bogdan-kovalchuk/esp32-battery-charging-monitoring/hardware/battery-monitor-rev-a/production/README.md

# Battery monitor rev-a: production package

Board: ESP32-S3-WROOM-1 + Ra-02 battery voltage monitor, 4 layers, 62 x 50 mm, 1.6 mm, HASL (JLCPCB standard, no surcharge), 66 footprints (62 BOM references, of them 59 soldered parts in the position file + J101 wire pads + TP102/TP103 test pads, + 4 mounting holes H1–H4), all on the top side, hand assembly. Built 2026-10-15, reworked 2026-10-18, balanced 2026-10-20, revised in review round r6 (2026-10-22), silkscreen reworked in r7, top silk texts edited by the owner in r8, parts re-sourced to Ukrainian stock in the IMRAD-stock round (2026-10-25: F101 and R511 footprints changed, MPN fields), U201 thermal-pad holes 0.20 -> 0.30 mm in the JLCPCB-standard round (2026-10-26), re-exported 2026-10-26 with KiCad 10.0.6 `kicad-cli` from the installed board `battery-monitor-rev-a.kicad_pcb` SHA256 `cf1b4365...` (full hash in `../evidence/jlc-standard-20261026/report.md`; every file of this package except the purchase workbook: fabrication files, assembly drawings, renders, STEP, BOM, position file); DRC with schematic parity 0 errors / 0 unconnected / 0 parity, 7 accepted `lib_footprint_mismatch` warnings (J201, U201, U401, L101, TP102, TP103, R511: board silk edited against the library footprints; never run "Update footprints from library" on them).

## What to upload

`01-gerbers-for-order/battery-monitor-rev-a-gerbers.zip` to JLCPCB as a standard 4-layer board with the quote-page defaults (bare PCB + top stencil, no surcharge). The quote-page table, the expected charges, the design facts, drill counts and the answers to engineering questions are in `01-gerbers-for-order/README-FABRICATION.md`.

**No assembly service for Ukraine:** JLCPCB offers no PCB assembly for delivery to Ukraine and LCSC takes no orders from Ukraine. Order the bare PCB and the stencil only; the parts are bought in Ukraine / AliExpress and soldered by hand.

## What else is in the package

| Path | Content |
|---|---|
| `01-gerbers-for-order/gerbers/` | The ZIP content unpacked (10 Gerber layers, job file, PTH and NPTH Excellon) |
| `01-gerbers-for-order/drill/` | Drill maps (PDF) and drill report: PTH 99 (smallest 0.30 mm: 72 vias + 12 U201 thermal-pad holes), NPTH 6 (total vias: 76 = 72 x 0.6/0.3 + 4 x 0.8/0.4, plugged/tented both sides; the 5 GND vias in the U101 exposed pad are open on the top through the pad's mask opening) |
| `01-gerbers-for-order/netlist-ipc356/` | IPC-D-356 netlist for the fab's electrical test |
| `01-gerbers-for-order/alt-drill-G85/` | Fallback only: PTH drill file with the J201 slots as G85 oval holes and a ZIP that differs from the main ZIP only in that file (use only if the fab asks for G85 slots) |
| `02-components/battery-monitor-rev-a-bom.csv` | KiCad BOM (`kicad-cli sch export bom`, grouped by value + footprint + MPN): Reference, Value, Footprint, MPN, Manufacturer, Quantity, Population, Note; 40 groups, 62 references (59 soldered parts + J101 wire pads + TP102/TP103), 0 DNP |
| `02-components/battery-monitor-rev-a-components.xlsx` | Ukrainian purchase workbook (formulas): sheet `Плата` one line per BOM group (boards to build in `Інструкція`!C5, default 5; buy-at-least stock target, shop, price, link, status), `Список покупок` grouped by shop, `Кошики` per-shop totals, `Набори` the owner's 0603 E24 resistor book, `Поза платою` what to buy outside the board (voltmeter module, XH mating housings and contacts, nylon M3 mounting hardware, inline 2 A blade fuse and holder for the battery + lead), `Пропозиції` every offer and search link; IMRAD-stock round 2026-10-25: MPNs as the schematic fields, IMRAD for every line it stocks, VD MAIS for U101, U301, F501, L101, R305, U202, owner stock U201 / U401, the owner's 0603 book now the free reserve of the 9 resistor lines bought as IMRAD packs; all 120 links opened and stock and prices checked on 2026-10-25 (`../evidence/imrad-stock-20261025/scratch/imrad-workbook/live/`). Generated by the scripts in `../evidence/imrad-stock-20261025/scratch/imrad-workbook/gen/`, verified by `verify_components.py` (0 problems; 39 board lines, 9 outside lines; 9137.32 UAH for 5 boards without delivery: board parts 8328.76 UAH + outside the board 808.56 UAH); record `../evidence/imrad-stock-20261025/imrad-workbook-CHANGES.md` |
| `03-documentation/ASSEMBLY-NOTES.md` | Hand assembly: soldering order with a test per stage, U101 PowerPAD (5 GND vias in the exposed pad, open on the top inside the pad's mask opening, no paste on them; hot air), U301 VSSOP, WROOM MSL3 bake, BOOT/EN recovery without buttons, J101 battery leads (square pad = BAT +), inline 2 A fuse in the battery + lead, M3 nylon mounting hardware (H3 next to F101 pad 2), enclosure heights, voltmeter wiring at J503 and external wake button at J504 (pin 1 = square pad; silk legends `+ GND SNS` at J503 and `BTN` at J504), the 30 references only on the assembly drawing, the parts re-sourced on 2026-10-25 (F101 NANO2, R511 2512, J201 test-fit), firmware obligations, bring-up tests |
| `03-documentation/assembly-top.pdf` | Assembly drawing, top: page 1 F.Fab + F.SilkS + Edge.Cuts with all 66 references (board `cf1b4365`); page 2 overview map 1.5:1 and pages 3–6 quadrants Q1–Q4 at 3:1, all 62 BOM references labelled on their own parts (H1–H4 only on page 1) |
| `03-documentation/assembly-top.html` | Interactive assembly map (hover for reference, value, MPN) |
| `03-documentation/assembly-bottom.pdf` | Bottom view, mirrored: no parts (single-sided), legends only (`BAT +` / `BAT -`, board name, date line) |
| `03-documentation/battery-monitor-rev-a-pos-kicad.csv` | Position file, top side, mm (`kicad-cli pcb export pos`, 59 soldered parts) |
| `03-documentation/battery-monitor-rev-a-schematic.pdf` | Schematic, root + 5 sheets (`kicad-cli sch export pdf`; sheet title blocks empty, owner GUI step) |
| `03-documentation/render-top.png`, `render-bottom.png`, `battery-monitor-rev-a.step` | 3D renders and STEP (re-exported 2026-10-26 from board `cf1b4365`; STEP with `--no-optimize-step`; F101 NANO2 model from EasyEDA/LCSC C99547, KiCad 10.0.6 has none for `Fuse_Littelfuse-NANO2-451_453`; record `../evidence/imrad-stock-20261025/imrad-3d-gerber-CHANGES.md`) |
| `manifest.sha256` | SHA256 of every file in this folder |

Do not rename or edit the Gerber files; after any CAD change regenerate the whole package.

**Re-export of the assembly drawing:** the map pages 2–6 come from `assembly_map_62.py` with the collision-aware label placement of r7-map-fix, which imports `labelplace.py`. Copy both files together from `../evidence/silk-r7-20261023/scratch/r7-map-fix/scripts/` into the export `scripts/` folder before running `doc_export.sh` (the call itself is unchanged); the `assembly_map_62.py` in `../evidence/silk-r7-20261023/scratch/r7-reexport/scripts/` and in the r6 scratch is the older version that runs labels together in the 0603 rows.

**Footprint library:** Never run "Update footprints from library" (or "Change footprints" / any library re-sync) on U201, J201, U401, L101, TP102, TP103 or R511: their board silk was edited against the library footprints (r7; R511 in the IMRAD-stock round 2026-10-25: the library silk line on the `BAT -` side split around the legend, the 7th accepted warning, `../evidence/imrad-stock-20261025/imrad-install-CHANGES.md`) (accepted DRC warnings `lib_footprint_mismatch`), and a library update restores the old silk with its silk-edge and silk-to-pad defects (L101 0.04 mm, TP rings 0.14 mm, U401 at C402 0.095 mm, the R511 line across `BAT -`). A library fix (project-local copies of these seven footprints with the edited silk) is a rev-b item.

**Inline battery-lead fuse (owner wiring, required):** a 2 A MINI/ATO blade fuse (32 V DC rated) in an inline holder in the battery + lead within 0.2 m of the + clip. F101 on the board (Littelfuse NANO2 0451002.MRL since 2026-10-25) interrupts up to 50 A at 125 V AC/DC and 300 A at 32 V DC (Littelfuse 451/453 datasheet, interrupting ratings) and stays secondary protection; a 12/24 V battery can deliver more into a shorted input part or a shorted lead. 48 V part swap: fuse rated >= 80 V DC. Text in `03-documentation/ASSEMBLY-NOTES.md` section 3; purchase lines П8/П9 on the workbook sheet `Поза платою`.

**Bottom silk date:** the bottom silkscreen reads `battery-monitor rev A` and `2026-10-23  4L` (date of the r7 silk rework; the top carries `rev A`). Later changes (the same day the F.Fab-only board `22731ea4` and the owner's top-silk edit r8, board `f26090a2`; on 2026-10-25 the IMRAD-stock round, board `98f3c7e2`) are identified by this package and the board hash, not by the bottom silk.

## Revision history

| Date | Round | Board | What changed in the package | Record |
|---|---|---|---|---|
| 2026-10-20 | Feng-Shui rework 62 x 50 mm | `1e59116f` | complete package | `../evidence/fengshui-20261020/` |
| 2026-10-22 | review r6 | `81057c2e` | vias out of SMD pads, C402 at U401, silk 1.0/0.15 mm, docs; schematic not edited (errata below) | `../evidence/review-r6-20261022/` |
| 2026-10-23 | silk rework r7, owner silk edit r8 | `22731ea4`, `f26090a2` | only F/B silkscreen and assembly drawing | `../evidence/silk-r7-20261023/`, `../evidence/owner-silk-r8-20261023/` |
| 2026-10-25 | IMRAD-stock round, F101 3D model, purchase for 3 boards, pre-fab review | `98f3c7e2`, `0eb3bae2` | F101 NANO2 and R511 2512 footprints, one GND via, MPN fields, workbook, `alt-drill-G85/` | `../evidence/imrad-stock-20261025/` |
| 2026-10-26 | JLCPCB-standard round | `cf1b4365` | U201 thermal holes 0.20 -> 0.30 mm (PTH drill, report, maps, IPC, STEP, ZIP); README-FABRICATION = JLCPCB quote-page defaults (HASL); live quote PCB $8.00 | `../evidence/jlc-standard-20261026/report.md` |

Every exported file is rebuilt from the board of the last row with the commands recorded in that round (method proven
on the previous board each time). Full paragraphs of each round: `../evidence/production-history.md`.

## Schematic errata

The installed schematic sheets were deliberately not edited in r6 (owner 2026-10-22: no schematic change without a real defect; the texts below change no connection). They are stale in the schematic PDF and, for the Note fields, in the BOM CSV `Note` column. Read them as corrected here. Step 1 of the IMRAD-stock round (2026-10-25) changed symbol fields only: it replaced the F101 and L101 Note fields, so their r6 errata rows are closed (new F101 Note checked against the Littelfuse 451/453 datasheet: interrupting ratings, 2 A cold resistance 0.0367 ohm, melting I2t 0.530 A2s); sheet texts and the F501 Note were not touched, and one refreshed field needs reading as corrected (U301 UA_Source).

| Where | Printed text (stale) | Read as |
|---|---|---|
| `05-io` sheet header | "05-IO: user button, status and alert LEDs, I2C header, spare header, LED voltmeter output." | "05-IO: external wake button (J504), status and alert LEDs, I2C pull-ups, LED voltmeter output (J503)." (J501/J502 headers removed 2026-10-18) |
| `02-mcu-usb` sheet header | "02-MCU-USB: ESP32-S3-WROOM-1-N16R8, EN/RESET, BOOT, USB-C data, UART0. Inherited from ..." | "02-MCU-USB: ESP32-S3-WROOM-1-N16R8, EN/RESET (TPS3808), BOOT strap, USB-C data (native USB). Inherited from antenna-controller-rev-c 02-mcu-usb (owner-approved); UART0 header removed 2026-10-18." |
| `05-io` voltmeter text, F501 | "F501 opens in <= 0.2 s (>= 300 %) or 0.04-0.3 ms (adiabatic)" | "F501 opens in <= 0.2 s (>= 300 %) or about 0.08-0.5 ms (adiabatic, melting I2t 0.0022 A2s, Littelfuse 466 Rev. 12/17/18)" |
| `01-power` chain text, 48 V sentence | "Documented alternate for 48 V only (not built): SMAJ58A/SMAJ64A, a 125 V fuse, 100 V switch MOSFETs" | "Documented alternate for 48 V only (not built): SMAJ58A/SMAJ64A (full-surge clamp above the U101 85 V abs max: accepted surge assumption), a fuse rated >= 80 V (F101 0451002.MRL, 125 V, meets this since 2026-10-25), 100 V switch MOSFET, R512 >= 0.5 W (2010/2512) or 22k, C102 effective capacitance re-checked at 60 V; the 4-30 V voltmeter module cannot be used (firmware lockout F6)." |
| L101 Note field (BOM CSV, step-1 text) | "... Isat 1.9 A (L -30 %), above the LMR38010 1.6 A typ limit ..." | "... Isat 1.9 A (L -30 %): above the LMR38010 high-side current limit 1.6 A typ and equal to its 1.9 A max (SNVSC73B 7.5, as quoted in `../evidence/review-r6-20261022/verify-circuit.md`) ..."; the r6 row for the former part's Note is closed |
| F501 Note field (BOM CSV) | "gauge fault fuse (review R2-01): cold 0.710 ohm, melting I2t 0.0010 A2s, 300 % <= 0.2 s, 200 % <= 5 s (Littelfuse 466 Rev. 12/19/13); ..." | "gauge fault fuse (review R2-01): cold 0.691 ohm, melting I2t 0.0022 A2s, 200 % <= 5 s (Littelfuse 466 Rev. 12/17/18); coordination table in schematic-review.md." |
| U301 UA_Source field (hidden schematic field; not in the PDF or the BOM CSV; refreshed in step 1) | "VD MAIS own stock 4 pcs; Digi-Key via VD MAIS 34304 pcs, 3 weeks, 374.63 UAH; IMRAD on order 6-10 working days (2026-10-25)" | "... Digi-Key via VD MAIS 34304 pcs, 3 weeks, 374.63 UAH ex VAT (449.56 UAH with VAT) ..." (the workbook line uses 449.56; `../evidence/imrad-stock-20261025/imrad-workbook-CHANGES.md`; schematic not edited) |

None of these changes a part, a value or a connection; F501 selection is unaffected (`../evidence/review-r6-20261022/verify-circuit.md` S-01, S-02, S-04); the F101 and L101 selections of 2026-10-25 are recorded in `../evidence/imrad-stock-20261025/report.md`.
