bogdan-kovalchuk/esp32-battery-charging-monitoring/hardware/battery-monitor-rev-a/production/03-documentation/render-bottom.png

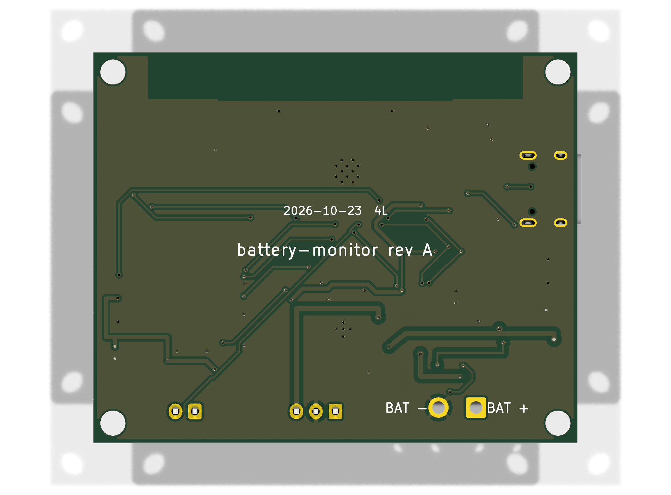
hardware/battery-monitor-rev-a/production/03-documentation/render-bottom.png
