bogdan-kovalchuk/esp32-battery-charging-monitoring/hardware/battery-monitor-rev-a/production/02-components/battery-monitor-rev-a-bom.csv

Reference | Value | Footprint | MPN | Manufacturer | Quantity | Population | Note
C101 | 22uF 100V | Capacitor_SMD:CP_Elec_8x10 | EEE-FK2A220P | Panasonic | 1 |  | damping of hot-plug ringing on battery leads (PWR-020); aluminium SMD 8x10
C102 | 10uF 100V | Capacitor_SMD:C_1210_3225Metric | GRM32EC72A106KE05L | Murata | 1 |  | 10 uF 100 V X7S 1210; 4.32 uF effective at 31 V (Murata curve, c102-choice.md); TI 4.7 uF effective minimum met up to 28.4 V, C101 in parallel
C103 | 100nF 100V | Capacitor_SMD:C_0603_1608Metric | CL10B104KC8NNNC | Samsung | 1 |  | X7R 100 V, next to U101 VIN/GND
C104,C202-C205,C301,C302,C402 | 100nF | Capacitor_SMD:C_0603_1608Metric | CL10B104KB8NNNC | Samsung | 8 |  | RC with 9.57k source: tau 0.96 ms, 16-bit settling 11 tau = 11 ms,U301 VDD decoupling,bootstrap, >= 16 V
C105-C107,C201 | 22uF | Capacitor_SMD:C_0805_2012Metric | GRM21BR61E226ME44L | Murata | 4
C401 | 10uF | Capacitor_SMD:C_0805_2012Metric | CL21A106KAYNNNE | Samsung | 1
D101 | B1100 | Diode_SMD:D_SMA | B1100-13-F | Diodes Incorporated | 1 |  | reverse-polarity block, 100 V 1 A SMA; VF 0.79 V max at 1 A (Diodes DS30018); was MCC SS110-LTP (2026-10-25 IMRAD-stock change); do not substitute a 60 V SS1x family part
D102 | SMAJ33A | Diode_SMD:D_SMA | SMAJ33A-TR | STMicroelectronics | 1 |  | owner Q1: 24 V systems -> SMAJ33A (VWM 33 V, VC 53.3 V at 7.5 A < 85 V U101); documented 48 V alternate only: SMAJ58A/SMAJ64A; pad 1 = cathode band to VIN_PROT
D501 | GREEN | LED_SMD:LED_0603_1608Metric | LTST-C191KGKT | Lite-On | 1 |  | STATUS (GPIO40): Wi-Fi/report state; yellow-green 571 nm, VF 2.0 V typ / 2.4 V max at 20 mA (Lite-On LTST-C191KGKT, 2026-10-25, was Foryard FYLS-0603GD): about 1.3 mA from GPIO40 via R502 1k; 3 V emerald-green LEDs stay dim or dark
D502 | RED | LED_SMD:LED_0603_1608Metric | KP-1608SURCK | Kingbright | 1 |  | ALERT (GPIO41): battery critical; 630 nm, VF 1.95 V typ / 2.5 V max (Kingbright KP-1608SURCK, 2026-10-25, was Hubei KENTO KT-0603R)
F101 | 2A 125V | Fuse:Fuse_Littelfuse-NANO2-451_453 | 0451002.MRL | Littelfuse | 1 |  | 2 A 125 V very fast NANO2 451 (IMRAD-stock change 2026-10-25, was 0466002.NRHF 1206): interrupting 50 A at 125 V AC/DC, 300 A at 32 V DC; cold 0.0367 ohm; melting I2t 0.530 A2s, hot-plug inrush about 0.04 A2s = 7.5 %; still clears a shorted D102
F501 | 0.25A 125V | Fuse:Fuse_1206_3216Metric | 0466.250NRHF | Littelfuse | 1 |  | gauge fault fuse (review R2-01): cold 0.710 ohm, melting I2t 0.0010 A2s, 300 % <= 0.2 s, 200 % <= 5 s (Littelfuse 466 Rev. 12/19/13); coordination table in schematic-review.md
J101 | BAT | Connector_Wire:SolderWire-0.75sqmm_1x02_P4.8mm_D1.25mm_OD2.3mm |  |  | 1 |  | solder pads for the XT30 lead; + = pin 1
J201 | USB4105-GF-A | Connector_USB:USB_C_Receptacle_HRO_TYPE-C-31-M-12 | USB4105-GF-A | GCT | 1 |  | data and programming only; VBUS does not power the board; GCT USB4105-GF-A on the HRO TYPE-C-31-M-12 land (2026-10-25, HRO not stocked in Ukraine): signal pads identical, VBUS/GND 0.05 mm shift, shell legs 0.80/1.10 mm in the 1.2/1.7 mm slots; test-fit on a bare board before soldering
J503 | VOLTMETER | Connector_JST:JST_XH_B3B-XH-A_1x03_P2.50mm_Vertical | B3B-XH-A(LF)(SN) | JST | 1 |  | 0.28 in LED voltmeter 0-100 V: 1 V_GAUGE (module supply, 4-30 V), 2 GND, 3 SENSE via R512 10k from VBAT_FUSED; 2-wire module: pins 1-2, pin 3 unused
J504 | BTN_EXT | Connector_JST:JST_XH_B2B-XH-A_1x02_P2.50mm_Vertical | B2B-XH-A(LF)(SN) | JST | 1 | Populated | External wake button (active high): 1 BTN_PULL (+3V3 via R510 1k), 2 BTN_USER (GPIO5, R501 10k pull-down to GND)
L101 | 22uH | Inductor_SMD:L_Bourns_SRN6045TA | SRN6045-220M | Bourns | 1 |  | 22 uH, ripple 0.34-0.36 A at 32-62 V in; SRN6045-220M (2026-10-25, was SRN6045TA-220M Isat 2.5 A): DCR 0.142 ohm max, Irms 1.5 A, Isat 1.9 A (L -30 %), above the LMR38010 1.6 A typ limit; same footprint; Sumida CDRH6D38NP-220NC (IMRAD) rejected: 1.3 A rated
Q501 | SI2309CDS | Package_TO_SOT_SMD:SOT-23 | SI2309CDS-T1-GE3 | Vishay Siliconix | 1 |  | gauge high-side switch (W23: single P-MOS): source on VIN_PROT (after D101, reverse-safe), drain to GAUGE_SW; -60 V, VGS(th) -1..-3 V; pulsed ID -8 A (10 us)
Q503 | MMBT5551 | Package_TO_SOT_SMD:SOT-23 | MMBT5551LT1G | onsemi | 1 |  | 160 V NPN current sink for the gauge switch gate
R101 | 68k | Resistor_SMD:R_0603_1608Metric | RC0603FR-0768KL | Yageo | 1 |  | RT: fSW = (30970/68)^(1/1.027) = 388 kHz (SNVSC73B eq. 2); full regulation to 65 V at tON-MIN 131 ns
R102 | 510k | Resistor_SMD:R_0603_1608Metric | 0603SAF5103T5E | Royal Ohm | 1 |  | RFBT; Vout = 1.0 V x (1 + 510/220) = 3.318 V; +3V3 band 3.22-3.45 V (typ 3.32 V; LMR38010 PFM regulation and 1 % resistors)
R103 | 220k | Resistor_SMD:R_0603_1608Metric | RC0603FR-07220KL | Yageo | 1 |  | RFBB; divider current 4.5 uA
R201,R202,R401,R501,R507 | 10k | Resistor_SMD:R_0603_1608Metric | 0603SAF1002T5E | Royal Ohm | 5 |  | emitter: Ic = 70-105 uA,pull-down replaces the DevKit external pull-down on GPIO34; GPIO5 has no pull at reset
R205,R206 | 5.1k | Resistor_SMD:R_0603_1608Metric | RC0603FR-075K1L | Yageo | 2
R208,R209 | 22 | Resistor_SMD:R_0603_1608Metric | RC0603FR-0722RL | Yageo | 2
R304 | 220k 0.1% | Resistor_SMD:R_0805_2012Metric | ERA-6AEB224V | Panasonic | 1 |  | thin film 0.1 % 25 ppm/K, 150 V; divider ratio 23.0 (0-69 V -> 0-3.0 V); always on from VBAT_FUSED (W23), 0.1 mA at 24 V
R305 | 10k 0.1% | Resistor_SMD:R_0603_1608Metric | RT0603BRD0710KL | Yageo | 1 |  | thin film 0.1 % 25 ppm/K
R307,R502,R503,R510 | 1k | Resistor_SMD:R_0603_1608Metric | RC0603FR-071KL | Yageo | 4 |  | AIN0 series: limits clamp current on reversal/overvoltage; source 10.6k: load error 0.18-0.39 % (typical ADS1115 input impedance), removed by the one-point calibration,button supply: pressed level 3.0 V (10k/11k), limits current to 3.3 mA when GPIO5 is driven low (power-up glitch)
R504,R505 | 4.7k | Resistor_SMD:R_0603_1608Metric | 0603SAF4701T5E | Royal Ohm | 2 |  | I2C SCL pull-up,I2C SDA pull-up
R506,R508,R509 | 100k | Resistor_SMD:R_0603_1608Metric | AC0603FR-07100KL | Yageo | 3 |  | base pull-down: gauge off while GPIO38 floats at reset/boot,base resistor GPIO38 -> Q503, 1:2 divider with R508,gate to source (VIN_PROT): VGS = 100k x 70-105 uA = 7-10.5 V, limited to VIN_PROT at a low battery
R511 | 4.7 2512 1W | Resistor_SMD:R_2512_6332Metric | RC2512JK-074R7L | Yageo | 1 |  | gauge short-circuit limiter (review R2-01): 2512 1 W thick film (2026-10-25 IMRAD-stock change, was Panasonic ERJ-P08J4R7V 1206 anti-surge 2.64 W / 5 s): short-time overload 2.5 x rated voltage for 5 s (Yageo RC2512, IEC 60115-1 4.13) = 5.42 V, 6.25 W, 31 J; partial-short case 1.8 W for <= 5 s = 8.9 J; dead short <= 0.78 J; ROHM ESR18 rejected: overload test 2.5 x Vr for 2 s only
R512 | 10k | Resistor_SMD:R_1206_3216Metric | 1206S4F1002T5E | Royal Ohm | 1 |  | voltmeter SENSE (J503 pin 3) from VBAT_FUSED: module reads the battery without the D101 drop; limits a sense-lead short to 3.1 mA (96 mW at 31 V; 1206 0.25 W)
TP102 | +3V3 | TestPoint:TestPoint_Pad_D1.5mm |  |  | 1
TP103 | GND | TestPoint:TestPoint_Pad_D1.5mm |  |  | 1
U101 | LMR38010SDDAR | Package_SO:TI_SO-PowerPAD-8 | LMR38010SDDAR | Texas Instruments | 1 |  | PFM + spread spectrum variant: Iq 40 uA, shutdown 3 uA; 4.2-80 V in (85 V abs max), 1 A; do not substitute FDDAR/FSDDAR (forced PWM); DDA0008B = KiCad TI_SO-PowerPAD-8
U201 | ESP32-S3-WROOM-1-N16R8 | RF_Module:ESP32-S3-WROOM-1 | ESP32-S3-WROOM-1-N16R8 (or -N16 / -N8, same footprint) | Espressif | 1 |  | owner stock N16R8; PSRAM not initialised by the firmware; N16R8 ambient -40..+65 C (indoor/garage OK)
U202 | TPS3808G33DBVR | Package_TO_SOT_SMD:SOT-23-6 | TPS3808G33DBVR | Texas Instruments | 1
U203 | USBLC6-2SC6 | Package_TO_SOT_SMD:SOT-23-6 | USBLC6-2SC6 | STMicroelectronics | 1
U301 | ADS1115IDGSR | Package_SO:TSSOP-10_3x3mm_P0.5mm | ADS1115IDGSR | Texas Instruments | 1 |  | 16 bit, I2C 0x48 (ADDR = GND); AIN0 battery, AIN1-AIN3 unused (no-connect, allowed by SBAS444E 9.1.4); ALERT/RDY no-connect (open drain, firmware polls; W23)
U401 | Ra-02 | BattMon:Ra02_Source | Ra-02 | Ai-Thinker | 1 | fitted (owner Q3) | 433 MHz variant (410-525 MHz), IPEX antenna; owner stock
