bogdan-kovalchuk/esp32-battery-charging-monitoring/hardware/battery-monitor-rev-a/production/02-components/battery-monitor-rev-a-components.xlsx

Sheet: Інструкція
Battery monitor rev-a: деталі для монтажу і закупівля із запасом
Деталі, що паяються на плату battery-monitor-rev-a (59 шт на плату з 62 позицій BOM; J101, TP102, TP103 - площадки без деталі). ESP32-S3 і Ra-02 вже є у власника; основний магазин - IMRAD, решта (U101, U301, F501, L101, R305, U202) - VD MAIS; резистори 0603 ряду E24 можна брати і з книги власника. Аркуш «Поза платою» - що купити для монтажу в корпус (вольтметр, відповідні роз'єми, кріплення, запобіжник у проводі батареї). Ціни, наявність і мінімальні замовлення - як на сторінках магазинів 2026-10-25; перед замовленням перевірити.
Налаштування (жовті клітинки можна змінювати)
Кількість плат для збирання | 5 |  | PCB замовляються по 5 шт. Кількості «Потрібно» і запас на брак рахуються від цього числа.
ПДВ для цін, вказаних «без ПДВ» | 20% |  | Космодром і РКС показують ціни без ПДВ; VD MAIS - з ПДВ; Prom.ua, IMRAD, Mini-Tech - як на сторінці.
Категорія | Запас на брак, % | Мін. запас на брак, шт | Навіщо
Дрібні пасивні | 20% | 3 | 0603/0805/1206 губляться і «відлітають» під час паяння
Мікросхеми та силові | 0% | 1 | 1 шт на випадок перегріву або неправильної орієнтації
Роз'єми та кнопки | 0% | 1 | 1 шт на випадок пошкодження
Модулі | 0% | 0 | ESP32-S3 і Ra-02 вже є у власника
Без деталі | 0% | 0 | площадки на платі, нічого не купується
Підсумок (рахується автоматично)
Деталі плати (із запасом): сума відомих цін, грн | 8328.764
Набори (книги): сума, грн | 0
Поза платою (вольтметр, роз'єми-відповідники, кріплення, запобіжник у проводі): сума, грн | 808.56
Разом, грн (без доставки і рядків без ціни) | 9137.324
Рядків без ціни (AliExpress) | 0
Рядків до покупки «в наявності» | 33
Рядків до покупки «під замовлення» (строк уточнити) | 2
Рядків до покупки «немає» / «немає в Україні» | 0
Номіналів з книги резисторів, яким її не вистачає | 0
Як користуватися: 5 кроків
КРОК 1. Тут, у жовтій клітинці C5, - скільки плат збираєте (зараз 5). Усі кількості перерахуються самі.
КРОК 2. Аркуш «Набори»: книга резисторів 0603 вже є («Вже є» = 1); резистори 0603 зараз купуються в IMRAD, книга - безкоштовна альтернатива. «Купити» = 1, лише якщо потрібна ще одна.
КРОК 3. Аркуш «Плата»: змінюйте лише жовті клітинки - «Купити щонайменше», «Вже є» (залишки після rev-c: стовпець «Деталь з rev-c»), «Джерело» і «Магазин». Зелений стовпець «ЗАМОВИТИ» - результат.
КРОК 4. Аркуш «Поза платою»: вольтметр, корпуси і контакти XH, нейлонове кріплення H1-H4, тримач і запобіжник 2 А для проводу батареї. «Вже є» - якщо щось уже є.
КРОК 5. Аркуш «Список покупок»: готовий перелік по магазинах. Аркуш «Кошики» - сума по кожному магазину і скільки бракує до мінімальної суми продавця Prom.ua (Filur 300, Connectors 150, DIY mag 100 грн).
Корисно знати
«ЗАМОВИТИ» = більше з двох: («Потрібно на всі плати» + «на брак») або «Купити щонайменше»; мінус «Вже є»; далі округлюється до мінімального замовлення і кратності магазину. «Лишиться в запасі» – що залишиться після збирання.
«Купити щонайменше» зараз: дешеві мікросхеми, запобіжники, дросель, діоди, транзистори, роз'єми – 10 шт; світлодіоди, 220k 0.1 % - 20; 100 нФ 0603 і 10 кОм 1206 - 100; 22 мкФ 0805 - 50. Дорогі U101, U202, U301 - лише потреба + 1 шт на брак.
«Джерело»: «магазин» - купується окремо (резистори 0603 68k, 510k, 220k, 10k, 5.1k, 22, 4.7k, 1k, 100k - упаковками по 100 шт в IMRAD; замість цього можна вибрати «книга резисторів 0603»); «є у власника» - ESP32-S3 і Ra-02 (сірі рядки); «не купується» - J101 (провід батареї), TP102/TP103.
НЕ замінювати: R304/R305 (0.1 %, тонкоплівкові), R511 (2512 1 Вт, перевантаження 5 с) і F501 0.25 А (розраховані разом), F101 лише NANO2 0451002.MRL (футпринт NANO2), U101 лише SDDAR / SQDDARQ1 (не FDDAR), D102 лише однонаправлений SMAJ33A. Допустимі заміни описано в стовпці «Що купувати».
Два замовлення (перевірено 2026-10-25): IMRAD - усі рядки, які він має на складі; VD MAIS - L101 SRN6045-220M, R305, U202 (власний склад, 0 тижнів) і Digi-Key через VD MAIS, 3 тижні: U101 LMR38010SQDDARQ1, F501 0466.250NRHF, 2 з 6 шт U301 - цей кошик замовляйте першим.
U301 ADS1115: на власному складі VD MAIS лише 4 шт з потрібних 6; решту 2 шт - Digi-Key у тому ж кошику VD MAIS. Ціна в рядку - середня за 6 шт; для іншої кількості перерахуйте (резерв: IMRAD під замовлення 6-10 робочих днів).
Дорожче, ніж у Космодромі (власний склад, резерв у рядку): Q501 (57.12 проти 9.00 грн без ПДВ) і F101 (49.95 проти 8.00): за бажанням змініть «Магазин» і ціну.
J504: лише B2B-XH-A(LF)(SN) без бобишки (IMRAD). B2B-XH-AM (з бобишкою) у плату не стає без підрізання бобишки.
LCSC/JLCPCB не продають в Україну; Digi-Key - через VD MAIS (catalog.vdmais.ua). AliExpress - лише пошукові посилання.
Ціни - як на сторінках на 2026-10-25; «без ПДВ» множиться на (1 + ПДВ). Доставку не враховано. Перед замовленням перевірте наявність. Усі перевірені пропозиції - аркуш «Пропозиції».
Джерела: KiCad BOM (02-components/battery-monitor-rev-a-bom.csv, kicad-cli 10.0.6), сторінки магазинів. Скрипти: battery-monitor-rev-a/evidence/imrad-stock-20261025/scratch/imrad-workbook/gen/ (edit_offers.py -> bom_offers.py, check_links.py, make_components_ua.py, verify_components.py, recalc_excel.ps1); дані - сторінки магазинів 2026-10-25 (скрипти component-sourcing-ukraine, вивід у imrad-workbook/live/).

Sheet: Список покупок
Список покупок: що і скільки замовити в кожному магазині. Рахується сам з аркушів «Плата» і «Набори»: тут нічого не змінюйте.
Купуйте магазин за магазином (рядки згруповано). Порожня ціна - AliExpress: шукайте за MPN зі стовпця «Що замовити». Перед оплатою відкрийте посилання і перевірте наявність і ціну.
Деталі плати
Магазин | Позиції на платі | Що замовити | Кількість | Од. | Ціна з ПДВ, грн/од. | Сума, грн | Статус | Посилання | Примітка
IMRAD | C101 | Panasonic EEEFK2A220P (точний MPN) | 10 | шт | 14.82 | 148.20 | в наявності | відкрити | IMRAD: «Є в наявності, на складі» (кількість не показано); ціна від 6 шт (1 шт: 16.13, від 15: 13.69, від 70: 12.38)
IMRAD | C102 | Murata GRM32EC72A106KE05L (точний MPN) | 10 | шт | 32.06 | 320.60 | в наявності | відкрити | IMRAD: «Є в наявності, на складі» (кількість не показано); ціна від 5 шт (1 шт: 36.53)
IMRAD | C103 | Samsung CL10B104KC8NNNC (100 нФ X7R 100 В 0603, точний MPN) | 100 | шт | 0.94 | 94.00 | в наявності | відкрити | IMRAD: «Є в наявності, на складі» (кількість не показано); ціна від 100 шт (1 шт: 1.65, від 10: 1.02)
IMRAD | C104, C202-C205, C301, C302, C402 | Samsung CL10B104KB8NNNC (100 нФ X7R 50 В 0603, точний MPN) | 100 | шт | 0.67 | 67.00 | в наявності | відкрити | IMRAD: «Є в наявності, на складі» (кількість не показано); ціна від 100 шт (1 шт: 1.65, від 10: 0.72, від 500: 0.63)
IMRAD | C105-C107, C201 | Murata GRM21BR61E226ME44L (точний MPN) | 50 | шт | 12.04 | 602.00 | в наявності | відкрити | IMRAD: «Є в наявності, на складі» (кількість не показано); ціна від 10 шт (1 шт: 13.42, від 100: 11.21). «Купити щонайменше» 50 задано, коли ціна була 2.96 грн: потреба 5 плат = 24 шт
IMRAD | C401 | Samsung CL21A106KAYNNNE (точний MPN) | 20 | шт | 3.41 | 68.20 | в наявності | відкрити | IMRAD: «Є в наявності, на складі» (кількість не показано); ціна від 10 шт (1 шт: 3.80, від 100: 3.18)
IMRAD | D101 | Diodes B1100-13-F (100 В, 1 А, SMA, точний MPN) | 10 | шт | 5.55 | 55.50 | в наявності | відкрити | IMRAD: «Є в наявності, на складі» (кількість не показано); ціна від 10 шт (1 шт: 6.07, від 50: 5.21)
IMRAD | D102 | ST SMAJ33A-TR (однонаправлений, 33 В, 400 Вт, SMA, точний MPN) | 10 | шт | 6.26 | 62.60 | в наявності | відкрити | IMRAD: «Є в наявності, на складі» (кількість не показано); ціна від 10 шт (1 шт: 6.85, від 50: 5.87)
IMRAD | D501 | Lite-On LTST-C191KGKT (жовто-зелений 571 нм, точний MPN) | 20 | шт | 1.74 | 34.80 | в наявності | відкрити | IMRAD: «Є в наявності, на складі» (кількість не показано); ціна від 10 шт (1 шт: 1.84, від 50: 1.56)
IMRAD | D502 | Kingbright KP-1608SURCK (червоний 630 нм, точний MPN) | 20 | шт | 4.69 | 93.80 | в наявності | відкрити | IMRAD: «Є в наявності, на складі» (кількість не показано); ціна від 10 шт (1 шт: 4.96, від 50: 4.21)
IMRAD | F101 | Littelfuse 0451002.MRL (NANO2, 2 А 125 В, точний MPN) | 10 | шт | 49.95 | 499.50 | в наявності | відкрити | IMRAD: «Є в наявності, на складі» (кількість не показано); ціна від 8 шт (1 шт: 57.93, від 4: 55.03, від 24: 45.86)
IMRAD | J201 | GCT USB4105-GF-A (точний MPN) | 10 | шт | 34.96 | 349.60 | в наявності | відкрити | IMRAD: «Є в наявності, на складі» (кількість не показано); ціна від 8 шт (1 шт: 37.65, від 4: 36.30, від 20: 33.62)
IMRAD | J503 | JST B3B-XH-A (точний MPN) | 10 | шт | 4.35 | 43.50 | в наявності | відкрити | IMRAD: «Є в наявності, на складі» (кількість не показано); ціна від 10 шт (1 шт: 4.82, від 35: 4.20)
IMRAD | J504 | JST B2B-XH-A (LF)(SN) (точний MPN) | 10 | шт | 3.20 | 32.00 | в наявності | відкрити | IMRAD: «Є в наявності, на складі» (кількість не показано); ціна від 10 шт (1 шт: 3.72, від 50: 3.05). НЕ B2B-XH-AM (з бобишкою)
IMRAD | Q501 | Vishay SI2309CDS-T1-GE3 (точний MPN) | 10 | шт | 57.12 | 571.20 | в наявності | відкрити | IMRAD: «Є в наявності, на складі» (кількість не показано); одна ціна для будь-якої кількості
IMRAD | Q503 | onsemi MMBT5551LT1G (точний MPN) | 10 | шт | 1.62 | 16.20 | в наявності | відкрити | IMRAD: «Є в наявності, на складі» (кількість не показано); ціна від 10 шт (1 шт: 1.72, від 50: 1.54)
IMRAD | R101 | Yageo RC0603FR-0768KL (68 кОм 1 %), упаковка 100 шт | 100 | шт | 0.104 | 10.40 | в наявності | відкрити | IMRAD: «Є в наявності, на складі» (кількість не показано); 10.40 грн за 100 шт (від 5 уп.: 8.40, від 10: 7.00); ціна в рядку - за 1 шт
IMRAD | R102 | Royal Ohm 0603SAF5103T5E (510 кОм 1 %), упаковка 100 шт | 100 | шт | 0.117 | 11.70 | в наявності | відкрити | IMRAD: «Є в наявності, на складі» (кількість не показано); 11.70 грн за 100 шт (від 5 уп.: 9.45, від 10: 7.88); ціна в рядку - за 1 шт
IMRAD | R103 | Yageo RC0603FR-07220KL (220 кОм 1 %), упаковка 100 шт | 100 | шт | 0.262 | 26.20 | в наявності | відкрити | IMRAD: «Є в наявності, на складі» (кількість не показано); 26.20 грн за 100 шт (від 5 уп.: 25.20, від 10: 21.00); ціна в рядку - за 1 шт
IMRAD | R201, R202, R401, R501, R507 | Royal Ohm 0603SAF1002T5E (10 кОм 1 %), упаковка 100 шт | 100 | шт | 0.1404 | 14.04 | в наявності | відкрити | IMRAD: «Є в наявності, на складі» (кількість не показано); 14.04 грн за 100 шт (від 5 уп.: 11.34, від 10: 9.45); ціна в рядку - за 1 шт
IMRAD | R205, R206 | Yageo RC0603FR-075K1L (5.1 кОм 1 %), упаковка 100 шт | 100 | шт | 0.182 | 18.20 | в наявності | відкрити | IMRAD: «Є в наявності, на складі» (кількість не показано); 18.20 грн за 100 шт (від 5 уп.: 14.70, від 10: 12.25); ціна в рядку - за 1 шт
IMRAD | R208, R209 | Yageo RC0603FR-0722RL (22 Ом 1 %), упаковка 100 шт | 100 | шт | 0.208 | 20.80 | в наявності | відкрити | IMRAD: «Є в наявності, на складі» (кількість не показано); 20.80 грн за 100 шт (від 5 уп.: 16.80, від 10: 14.00); ціна в рядку - за 1 шт
IMRAD | R304 | Panasonic ERA-6AEB224V (220 кОм 0.1 % 25 ppm/K 0805, точний MPN) | 20 | шт | 5.12 | 102.40 | в наявності | відкрити | IMRAD: «Є в наявності, на складі» (кількість не показано); ціна від 10 шт (1 шт: 5.86)
IMRAD | R307, R502, R503, R510 | Yageo RC0603FR-071KL (1 кОм 1 %), упаковка 100 шт | 100 | шт | 0.1375 | 13.75 | в наявності | відкрити | IMRAD: «Є в наявності, на складі» (кількість не показано); 13.75 грн за 100 шт (від 5 уп.: 11.34, від 10: 9.45); ціна в рядку - за 1 шт
IMRAD | R504, R505 | Royal Ohm 0603SAF4701T5E (4.7 кОм 1 %; на сайті SMD0603-4K7-1%), упаковка 100 шт | 100 | шт | 0.1517 | 15.17 | в наявності | відкрити | IMRAD: «Є в наявності, на складі» (кількість не показано); 15.17 грн за 100 шт (від 5 уп.: 14.30, від 10: 13.50); ціна в рядку - за 1 шт
IMRAD | R506, R508, R509 | Yageo AC0603FR-07100KL (100 кОм 1 %), упаковка 100 шт | 100 | шт | 0.1808 | 18.08 | в наявності | відкрити | IMRAD: «Є в наявності, на складі» (кількість не показано); 18.08 грн за 100 шт (від 5 уп.: 17.68, від 10: 16.90); ціна в рядку - за 1 шт
IMRAD | R511 | Yageo RC2512JK-074R7L (4.7 Ом 5 % 2512 1 Вт, точний MPN) | 10 | шт | 1.34 | 13.40 | в наявності | відкрити | IMRAD: «Є в наявності, на складі» (кількість не показано); ціна від 10 шт (1 шт: 1.58, від 100: 1.04)
IMRAD | R512 | Royal Ohm 1206S4F1002T5E (10 кОм 1 % 1206), упаковка 100 шт | 100 | шт | 0.2808 | 28.08 | в наявності | відкрити | IMRAD: «Є в наявності, на складі» (кількість не показано); 28.08 грн за 100 шт (від 5 уп.: 22.68, від 10: 18.90); ціна в рядку - за 1 шт
IMRAD | U203 | ST USBLC6-2SC6 (точний MPN) | 10 | шт | 10.84 | 108.40 | в наявності | відкрити | IMRAD: «Є в наявності, на складі» (кількість не показано); ціна від 10 шт (1 шт: 11.50, від 35: 10.38)
VD MAIS | F501 | Littelfuse 0466.250NRHF (точний MPN), Digi-Key через VD MAIS | 10 | шт | 71.436 | 714.36 | під замовлення | відкрити | Digi-Key F5692CT-ND: 5812 шт, 3 тижні; ціна від 5 шт 59.53 грн без ПДВ (1 шт: 59.66), дані API VD MAIS; в IMRAD немає (0466.250NR - немає, 0451.250MRL - під замовлення). Замовляти разом з U101
VD MAIS | L101 | Bourns SRN6045-220M (точний MPN) | 10 | шт | 12.27 | 122.70 | в наявності | відкрити | власний склад VD MAIS: 370 шт, строк 0 тижнів; в IMRAD 22 мкГн з Isat >= 1.6 А немає
VD MAIS | R305 | Yageo RT0603BRD0710KL (точний MPN) | 10 | шт | 2.07 | 20.70 | в наявності | відкрити | власний склад VD MAIS: 50 шт, строк 0 тижнів; ціна від 10 шт. В IMRAD лише 10.2 кОм 0.1 % (змінило б коефіцієнт дільника)
VD MAIS | U101 | TI LMR38010SQDDARQ1 (Q1-версія LMR38010SDDAR), Digi-Key через VD MAIS | 6 | шт | 302.184 | 1813.10 | під замовлення | відкрити | Digi-Key 296-LMR38010SQDDARQ1CT-ND: 2220 шт, 3 тижні; 251.82 грн без ПДВ (від 10: 225.26), дані API VD MAIS. В IMRAD немає. Замовляти зараз разом з F501 і U301
VD MAIS | U202 | TI TPS3808G33DBVR (точний MPN) | 6 | шт | 84.42 | 506.52 | в наявності | відкрити | власний склад VD MAIS: 227 шт, строк 0 тижнів
VD MAIS | U301 | TI ADS1115IDGSR: 4 шт власний склад VD MAIS + 2 шт Digi-Key через VD MAIS | 6 | шт | 282.01 | 1692.06 | в наявності | відкрити | власний склад: 4 шт по 198.23 грн, строк 0 тижнів; решта 2 шт - Digi-Key 296-38849-1-ND (34304 шт, 3 тижні, 374.63 грн без ПДВ = 449.56 з ПДВ) у тому ж кошику VD MAIS. Ціна в рядку - середня для 6 шт ((4 x 198.23 + 2 x 449.56) / 6 = 282.01); для іншої кількості перерахувати
 |  |  |  |  | Деталі: | 8328.76
Набори (книги)
 |  |  |  |  | Набори: | 0.00
Поза платою (корпус, проводи, кріплення)
IMRAD | J503 B3B-XH-A | JST XHP-3 | 6 | шт | 2.16 | 12.96 | в наявності | відкрити | в наявності (кількість не показано)
IMRAD | J504 B2B-XH-A | JST XHP-2 | 6 | шт | 1.72 | 10.32 | в наявності | відкрити | в наявності (кількість не показано)
Космодром | XHP-3 (3 шт) + XHP-2 (2 шт) | JST SXH-001T-P0.6 (точний MPN) | 30 | шт | 2.40 | 72.00 | в наявності | відкрити | на складі 2499 шт
Космодром | H1-H4 (отвори 3.2 мм) | PLFF-M3-10 (Nylon 66, M3, 10 мм, F-F) | 22 | шт | 4.20 | 92.40 | в наявності | відкрити | на складі 40597 шт; матеріал Nylon 66 94V-2
РКС Компоненти | H1-H4: плата - стійка (4) і стійка - корпус (4) | KLS8-0318-PF-M3-06 (пластиковий M3x6, головка 5.5 мм) | 44 | шт | 1.80 | 79.20 | в наявності | відкрити | у наявності 103 шт (Львів 98, Харків 5), очікується 20000 шт (дату не показано); 10+ по 2.00, 14+ по 1.50 грн без ПДВ
РКС Компоненти | H1-H4 під головку гвинта; обов'язково біля H3 (F101.2 за 4.45 мм) | KangYang WS3-1.5 (пластик, 6 x 3.1 x 1.5 мм) | 22 | шт | 1.44 | 31.68 | в наявності | відкрити | у наявності 3323 шт; 14+ по 1.50, 17+ по 1.20 грн без ПДВ
РКС Компоненти | у тримач на проводі «+» батареї (C-01); F101 на платі - лише вторинний захист | MTA MINIVAL 2A (AMFM-2A) | 10 | шт | 6.00 | 60.00 | в наявності | відкрити | у наявності 57 шт (Львів); 2+ по 10.00, 10+ по 5.00 грн без ПДВ; 32 В DC - з опису іншої пропозиції того самого MINIVAL 2A MTA на цій сторінці (у картці складу напруги немає): перевірити маркування
Prom.ua - DIY mag | J503 (кабель модуля в корпусі) | Панельний LED вольтметр 0.28" 0-100V DC, 3-провідний | 5 | шт | 50.00 | 250.00 | в наявності | відкрити | сторінка: живлення DC 4-30 В («перевищення може пошкодити»), споживання < 30 мА, колір індикатора випадковий; у 24 В системі під час вирівнюючого заряду (до 31 В) живлення на межі: перевірити на стенді (B6/B7)
Prom.ua - Connectors | провід батареї «+», не далі 0.2 м від затискача (C-01) | Тримач автомобільного запобіжника міні з кабелем (вологозахисний, з кришкою) | 5 | шт | 40.00 | 200.00 | в наявності | відкрити | замовлення у продавця від 150 грн; переріз проводу на сторінці не вказано: перевірити
 |  |  |  |  | Поза платою: | 808.56
 |  |  |  |  | РАЗОМ: | 9137.32
 |  | Без доставки. Рядки без ціни (AliExpress) в суму не входять.

Sheet: Плата
Аркуш «Плата»: один рядок = одна група однакових деталей з KiCad BOM плати battery-monitor-rev-a. Результат - стовпець «ЗАМОВИТИ» і аркуш «Список покупок».
Змінювати можна лише ЖОВТІ клітинки: «Купити щонайменше» - скільки взяти із запасом для інших плат; «Вже є» - що вже лежить у вас (наприклад, залишок після rev-c: стовпець «Деталь з rev-c»); «Джерело» і «Магазин» - звідки брати.
«Потрібно на всі плати» + «на брак» → «ЗАМОВИТИ» (не менше «Купити щонайменше» і мінімального замовлення магазину) → «Лишиться в запасі». Технічні стовпці (ціна на сайті, мінімум, резерв, MPN) згорнуто: кнопка «+» над заголовками.
ДЕТАЛЬ |  |  |  |  | СКІЛЬКИ |  |  |  |  |  |  |  | ДЕ КУПИТИ |  |  |  |  |  |  |  | ДОВІДКА (згорнуто: «+» над стовпцями)
№ | Позиції | Номінал | Корпус (KiCad footprint) | Що купувати / допустима заміна | На 1 плату | Од. | Потрібно на всі плати | + на брак | Купити щонайменше ✎ | Вже є ✎ | ЗАМОВИТИ | Лишиться в запасі | Джерело ✎ | Магазин ✎ | Що саме замовити | Статус | Ціна з ПДВ, грн/од. | Сума, грн | Посилання | Примітка до покупки | Ціна на сайті, грн/од. | Ціна вказана | Мін. замовл. | Кратність | Відповідність | Перевірено | Резервний варіант | Резерв: посилання | AliExpress (пошук) | Деталь з rev-c | Категорія | Призначення в схемі | MPN у KiCad (виробник) | URL (службовий) | Ключ (службовий)
1 | C101 | 22uF 100V | CP_Elec_8x10 | 22 мкФ 100 В, алюмінієвий SMD 8x10 мм, low-ESR (Panasonic FK або аналог того самого розміру) | 1 | шт | 5 | 3 | 10 | 0 | 10 | 5 | магазин | IMRAD | Panasonic EEEFK2A220P (точний MPN) | в наявності | 14.82 | 148.20 | відкрити (https://imrad.com.ua/ua/eeefk2a220p-3) | IMRAD: «Є в наявності, на складі» (кількість не показано); ціна від 6 шт (1 шт: 16.13, від 15: 13.69, від 70: 12.38) | 14.82 | як на сторінці | 1 | 1 | точний MPN | 2026-10-25 | Космодром: Panasonic EEEFK2A220P (точний MPN): в наявності, 14.5 грн (без ПДВ). на складі 131 шт | відкрити (https://kosmodrom.ua/kondensator-elektrolitichniy/eeefk2a220p-2.html) | пошук (https://www.aliexpress.com/w/wholesale-EEE-FK2A220P-22uF-100V-SMD.html) |  | Дрібні пасивні | C101: демпфування дзвону на проводах батареї (VIN_PROT) | EEE-FK2A220P (Panasonic) | https://imrad.com.ua/ua/eeefk2a220p-3 | 1006
2 | C102 | 10uF 100V | C_1210_3225Metric | 10 мкФ 100 В X7S 1210, Murata GRM32EC72A106KE05L (той самий з кодом пакування KE05K; допустима заміна Samsung CL32Y106KCVZ4NE) | 1 | шт | 5 | 3 | 10 | 0 | 10 | 5 | магазин | IMRAD | Murata GRM32EC72A106KE05L (точний MPN) | в наявності | 32.06 | 320.60 | відкрити (https://imrad.com.ua/ua/grm32ec72a106ke05l-2) | IMRAD: «Є в наявності, на складі» (кількість не показано); ціна від 5 шт (1 шт: 36.53) | 32.06 | як на сторінці | 1 | 1 | точний MPN | 2026-10-25 | VD MAIS: Murata GRM32EC72A106KE05K (10 мкФ 100 В X7S 1210): в наявності, 44.55 грн (з ПДВ). той самий GRM32EC72A106KE05L, інший лише код пакування; на складі 60 шт | відкрити (https://catalog.vdmais.ua/uk/product/grm32ec72a106ke05k/1747843/) | пошук (https://www.aliexpress.com/w/wholesale-10uF-100V-1210-X7S-capacitor.html) |  | Дрібні пасивні | C102: вхідний конденсатор U101 LMR38010 | GRM32EC72A106KE05L (Murata) | https://imrad.com.ua/ua/grm32ec72a106ke05l-2 | 1007
3 | C103 | 100nF 100V | C_0603_1608Metric | 100 нФ, 0603, X7R, >= 100 В (Samsung CL10B104KC8NNNC або аналог X7R 100 В) | 1 | шт | 5 | 3 | 100 | 0 | 100 | 95 | магазин | IMRAD | Samsung CL10B104KC8NNNC (100 нФ X7R 100 В 0603, точний MPN) | в наявності | 0.94 | 94.00 | відкрити (https://imrad.com.ua/ua/cl10b104kc8nnnc-3) | IMRAD: «Є в наявності, на складі» (кількість не показано); ціна від 100 шт (1 шт: 1.65, від 10: 1.02) | 0.94 | як на сторінці | 1 | 1 | точний MPN | 2026-10-25 | Космодром: Samsung CL10B104KC8NNNC (точний MPN), партнерський склад: під замовлення, 2.76 грн (без ПДВ), мін. 50 шт. 4-6 тижнів, ціна від 50 шт | відкрити (https://kosmodrom.ua/tsq-search?q=CL10B104KC8NNNC) | пошук (https://www.aliexpress.com/w/wholesale-100nF-100V-0603-X7R-capacitor.html) |  | Дрібні пасивні | C103: розв'язка VIN/GND біля U101 | CL10B104KC8NNNC (Samsung) | https://imrad.com.ua/ua/cl10b104kc8nnnc-3 | 1008
4 | C104, C202-C205, C301, C302, C402 | 100nF | C_0603_1608Metric | 100 нФ, 0603, X7R, >= 25 В (C104 bootstrap >= 16 В): Samsung CL10B104KB8NNNC (50 В) | 8 | шт | 40 | 8 | 100 | 0 | 100 | 60 | магазин | IMRAD | Samsung CL10B104KB8NNNC (100 нФ X7R 50 В 0603, точний MPN) | в наявності | 0.67 | 67.00 | відкрити (https://imrad.com.ua/ua/cl10b104kb8nnnc-8) | IMRAD: «Є в наявності, на складі» (кількість не показано); ціна від 100 шт (1 шт: 1.65, від 10: 0.72, від 500: 0.63) | 0.67 | як на сторінці | 1 | 1 | точний MPN | 2026-10-25 | Космодром: Samsung CL10B104KB8NNNC (точний MPN), партнерський склад: під замовлення, 1.79 грн (без ПДВ), мін. 100 шт. 4-6 тижнів, ціна від 100 шт | відкрити (https://kosmodrom.ua/tsq-search?q=CL10B104KB8NNNC) | пошук (https://www.aliexpress.com/w/wholesale-100nF-0603-X7R-50V-capacitor.html) |  | Дрібні пасивні | C104 bootstrap U101; C202-C205 розв'язка ESP32; C301/C302 ADS1115 і RC-фільтр AIN0; C402 Ra-02 | CL10B104KB8NNNC (Samsung) | https://imrad.com.ua/ua/cl10b104kb8nnnc-8 | 1009
5 | C105-C107, C201 | 22uF | C_0805_2012Metric | 22 мкФ, 0805, X5R, >= 25 В: Murata GRM21BR61E226ME44L (або Samsung CL21A226MAYNNNE того самого класу) | 4 | шт | 20 | 4 | 50 | 0 | 50 | 30 | магазин | IMRAD | Murata GRM21BR61E226ME44L (точний MPN) | в наявності | 12.04 | 602.00 | відкрити (https://imrad.com.ua/ua/grm21br61e226me44l-1) | IMRAD: «Є в наявності, на складі» (кількість не показано); ціна від 10 шт (1 шт: 13.42, від 100: 11.21). «Купити щонайменше» 50 задано, коли ціна була 2.96 грн: потреба 5 плат = 24 шт | 12.04 | як на сторінці | 1 | 1 | точний MPN | 2026-10-25 | Космодром: Murata GRM21BR61E226ME44L (точний MPN), партнерський склад: під замовлення, 32.83 грн (без ПДВ), мін. 5 шт. 4-6 тижнів, ціна від 5 шт | відкрити (https://kosmodrom.ua/tsq-search?q=GRM21BR61E226ME44L) | пошук (https://www.aliexpress.com/w/wholesale-22uF-25V-0805-X5R-capacitor.html) |  | Дрібні пасивні | C105-C107: вихід buck +3V3; C201: +3V3 біля ESP32 | GRM21BR61E226ME44L (Murata) | https://imrad.com.ua/ua/grm21br61e226me44l-1 | 1010
6 | C401 | 10uF | C_0805_2012Metric | 10 мкФ, 0805, X5R або X7R, >= 10 В | 1 | шт | 5 | 3 | 20 | 0 | 20 | 15 | магазин | IMRAD | Samsung CL21A106KAYNNNE (точний MPN) | в наявності | 3.41 | 68.20 | відкрити (https://imrad.com.ua/ua/cl21a106kaynnne-3) | IMRAD: «Є в наявності, на складі» (кількість не показано); ціна від 10 шт (1 шт: 3.80, від 100: 3.18) | 3.41 | як на сторінці | 1 | 1 | точний MPN | 2026-10-25 | VD MAIS: Samsung CL21A106KAYNNNE (точний MPN): в наявності, 0.92 грн (з ПДВ), мін. 10 шт. ціна від 10 шт; на складі 1293 шт | відкрити (https://catalog.vdmais.ua/uk/product/cl21a106kaynnne/1718726/) | пошук (https://www.aliexpress.com/w/wholesale-10uF-25V-0805-X5R-capacitor.html) | так | Дрібні пасивні | C401: +3V3 біля Ra-02 | CL21A106KAYNNNE (Samsung) | https://imrad.com.ua/ua/cl21a106kaynnne-3 | 1011
7 | D101 | B1100 | D_SMA | Шотткі 100 В 1 А, SMA: Diodes B1100-13-F (VF 0.79 В max при 1 А). НЕ ставити 60-вольтові SS1x (SS16 тощо) | 1 | шт | 5 | 1 | 10 | 0 | 10 | 5 | магазин | IMRAD | Diodes B1100-13-F (100 В, 1 А, SMA, точний MPN) | в наявності | 5.55 | 55.50 | відкрити (https://imrad.com.ua/ua/b1100-13-f-9) | IMRAD: «Є в наявності, на складі» (кількість не показано); ціна від 10 шт (1 шт: 6.07, від 50: 5.21) | 5.55 | як на сторінці | 1 | 1 | точний MPN | 2026-10-25 | Космодром: Diodes B1100-13-F (точний MPN): в наявності, 3 грн (без ПДВ). на складі 1475 шт | відкрити (https://kosmodrom.ua/diod-shottki-2/b1100-13-f.html) | пошук (https://www.aliexpress.com/w/wholesale-B1100-13-F-SMA-schottky-100V-1A.html) |  | Мікросхеми та силові | D101: захист від переполюсовки батареї | B1100-13-F (Diodes Incorporated) | https://imrad.com.ua/ua/b1100-13-f-9 | 1012
8 | D102 | SMAJ33A | D_SMA | SMAJ33A будь-якого виробника: 33 В, 400 Вт, ОДНОНАПРЯМЛЕНИЙ (не SMAJ33CA), SMA | 1 | шт | 5 | 1 | 10 | 0 | 10 | 5 | магазин | IMRAD | ST SMAJ33A-TR (однонаправлений, 33 В, 400 Вт, SMA, точний MPN) | в наявності | 6.26 | 62.60 | відкрити (https://imrad.com.ua/ua/smaj33a-tr-4) | IMRAD: «Є в наявності, на складі» (кількість не показано); ціна від 10 шт (1 шт: 6.85, від 50: 5.87) | 6.26 | як на сторінці | 1 | 1 | точний MPN | 2026-10-25 | Космодром: ST SMAJ33A-TR (точний MPN), партнерський склад: під замовлення, 9.52 грн (без ПДВ), мін. 5 шт. 4-6 тижнів, ціна від 5 шт (власний склад Космодрому: 0 шт, очікується) | відкрити (https://kosmodrom.ua/tsq-search?q=SMAJ33A-TR) | пошук (https://www.aliexpress.com/w/wholesale-SMAJ33A-TVS-diode-SMA-unidirectional.html) |  | Мікросхеми та силові | D102: TVS на вході VIN_PROT | SMAJ33A-TR (STMicroelectronics) | https://imrad.com.ua/ua/smaj33a-tr-4 | 1013
9 | D501 | GREEN | LED_0603_1608Metric | Жовто-зелений світлодіод 0603, Vf близько 2.0-2.4 В (571 нм): Lite-On LTST-C191KGKT. НЕ ставити смарагдові 525 нм / 3 В | 1 | шт | 5 | 3 | 20 | 0 | 20 | 15 | магазин | IMRAD | Lite-On LTST-C191KGKT (жовто-зелений 571 нм, точний MPN) | в наявності | 1.74 | 34.80 | відкрити (https://imrad.com.ua/ua/ltst-c191kgkt-4) | IMRAD: «Є в наявності, на складі» (кількість не показано); ціна від 10 шт (1 шт: 1.84, від 50: 1.56) | 1.74 | як на сторінці | 1 | 1 | точний MPN | 2026-10-25 | Космодром: Lite-On LTST-C191KGKT (точний MPN), партнерський склад: під замовлення, 2 грн (без ПДВ), мін. 50 шт. 4-6 тижнів, ціна від 50 шт | відкрити (https://kosmodrom.ua/tsq-search?q=LTST-C191KGKT) | пошук (https://www.aliexpress.com/w/wholesale-LTST-C191KGKT-0603-LED.html) |  | Дрібні пасивні | D501: STATUS (GPIO40) | LTST-C191KGKT (Lite-On) | https://imrad.com.ua/ua/ltst-c191kgkt-4 | 1014
10 | D502 | RED | LED_0603_1608Metric | Червоний світлодіод 0603, 630 нм, Vf близько 2 В: Kingbright KP-1608SURCK | 1 | шт | 5 | 3 | 20 | 0 | 20 | 15 | магазин | IMRAD | Kingbright KP-1608SURCK (червоний 630 нм, точний MPN) | в наявності | 4.69 | 93.80 | відкрити (https://imrad.com.ua/ua/kp-1608surck-3) | IMRAD: «Є в наявності, на складі» (кількість не показано); ціна від 10 шт (1 шт: 4.96, від 50: 4.21) | 4.69 | як на сторінці | 1 | 1 | точний MPN | 2026-10-25 | Космодром: Kingbright KP-1608SURCK (точний MPN), партнерський склад: під замовлення, 11.5 грн (без ПДВ), мін. 5 шт. 4-6 тижнів, ціна від 5 шт | відкрити (https://kosmodrom.ua/tsq-search?q=KP-1608SURCK) | пошук (https://www.aliexpress.com/w/wholesale-KP-1608SURCK-0603-red-LED.html) |  | Дрібні пасивні | D502: ALERT (GPIO41) | KP-1608SURCK (Kingbright) | https://imrad.com.ua/ua/kp-1608surck-3 | 1015
11 | F101 | 2A 125V | Fuse_Littelfuse-NANO2-451_453 | Лише Littelfuse 0451002.MRL (NANO2 451, 2 А 125 В, дуже швидкий) під футпринт Fuse_Littelfuse-NANO2-451_453. 1206-запобіжники 0466 на цей футпринт не стають | 1 | шт | 5 | 1 | 10 | 0 | 10 | 5 | магазин | IMRAD | Littelfuse 0451002.MRL (NANO2, 2 А 125 В, точний MPN) | в наявності | 49.95 | 499.50 | відкрити (https://imrad.com.ua/ua/0451002-mrl-2) | IMRAD: «Є в наявності, на складі» (кількість не показано); ціна від 8 шт (1 шт: 57.93, від 4: 55.03, від 24: 45.86) | 49.95 | як на сторінці | 1 | 1 | точний MPN | 2026-10-25 | Космодром: Littelfuse 0451002.MRL (точний MPN; виробник на сайті «LTL»): в наявності, 8 грн (без ПДВ). на складі 806 шт; маркування перевірити при отриманні | відкрити (https://kosmodrom.ua/zapobizhnik-plavkiy/0451002-mrl.html) | пошук (https://www.aliexpress.com/w/wholesale-0451002.MRL-NANO2-2A-fuse.html) |  | Мікросхеми та силові | F101: запобіжник входу батареї | 0451002.MRL (Littelfuse) | https://imrad.com.ua/ua/0451002-mrl-2 | 1016
12 | F501 | 0.25A 125V | Fuse_1206_3216Metric | Лише Littelfuse 0466.250NRHF (0.25 А, 125 В, дуже швидкий, 1206). Інший номінал не ставити: розраховано разом з R511 | 1 | шт | 5 | 1 | 10 | 0 | 10 | 5 | магазин | VD MAIS | Littelfuse 0466.250NRHF (точний MPN), Digi-Key через VD MAIS | під замовлення | 71.436 | 714.36 | відкрити (https://catalog.vdmais.ua/uk/parasearch/?keyword=0466.250NRHF) | Digi-Key F5692CT-ND: 5812 шт, 3 тижні; ціна від 5 шт 59.53 грн без ПДВ (1 шт: 59.66), дані API VD MAIS; в IMRAD немає (0466.250NR - немає, 0451.250MRL - під замовлення). Замовляти разом з U101 | 59.53 | без ПДВ | 5 | 1 | точний MPN | 2026-10-25 | Космодром: Littelfuse 0466.250NRHF (точний MPN), партнерський склад: під замовлення, 8.85 грн (без ПДВ), мін. 5 шт. 4-6 тижнів, ціна від 5 шт | відкрити (https://kosmodrom.ua/tsq-search?q=0466.250NRHF) | пошук (https://www.aliexpress.com/w/wholesale-0466.250-fuse-1206-250mA.html) |  | Мікросхеми та силові | F501: запобіжник виходу на вольтметр J503 | 0466.250NRHF (Littelfuse) | https://catalog.vdmais.ua/uk/parasearch/?keyword=0466.250NRHF | 2017
13 | J101 | BAT | SolderWire-0.75sqmm_1x02_P4.8mm_D1.25mm_OD2.3mm | Деталі немає: два отвори під провід 0.75 мм² (косичка XT30 від роз'єму на корпусі) | 1 | шт | 5 | 0 | 0 | 0 | 0 |  | не купується | не купується | провід XT30 0.5-0.75 мм² (поза платою) | не купується |  | 0.00 |  |  |  | як на сторінці | 1 | 1 |  |  |  |  |  |  | Без деталі | J101: провід батареї (BAT+ = квадратна площадка) | -
14 | J201 | USB4105-GF-A | USB_C_Receptacle_HRO_TYPE-C-31-M-12 | GCT USB4105-GF-A на футпринті HRO TYPE-C-31-M-12 (сигнальні площадки ті самі; ніжки корпусу 0.80/1.10 мм у пазах 1.2/1.7 мм): приміряти на голій платі перед пайкою | 1 | шт | 5 | 1 | 10 | 0 | 10 | 5 | магазин | IMRAD | GCT USB4105-GF-A (точний MPN) | в наявності | 34.96 | 349.60 | відкрити (https://imrad.com.ua/ua/usb4105-gf-a-1) | IMRAD: «Є в наявності, на складі» (кількість не показано); ціна від 8 шт (1 шт: 37.65, від 4: 36.30, від 20: 33.62) | 34.96 | як на сторінці | 1 | 1 | точний MPN | 2026-10-25 | Космодром: GCT USB4105-GF-A (точний MPN): в наявності, 44 грн (без ПДВ). на складі 726 шт | відкрити (https://kosmodrom.ua/usb-roz-39-yem/10sq050-dc.html) | пошук (https://www.aliexpress.com/w/wholesale-USB4105-GF-A-USB-C.html) |  | Роз'єми та кнопки | J201 USB-C: лише дані/прошивка, плату не живить | USB4105-GF-A (GCT) | https://imrad.com.ua/ua/usb4105-gf-a-1 | 1019
15 | J503 | VOLTMETER | JST_XH_B3B-XH-A_1x03_P2.50mm_Vertical | JST XH 3P вертикальний, крок 2.50 мм (B3B-XH-A). НЕ 2.54 мм | 1 | шт | 5 | 1 | 10 | 0 | 10 | 5 | магазин | IMRAD | JST B3B-XH-A (точний MPN) | в наявності | 4.35 | 43.50 | відкрити (https://imrad.com.ua/ua/b3b-xh-a-9) | IMRAD: «Є в наявності, на складі» (кількість не показано); ціна від 10 шт (1 шт: 4.82, від 35: 4.20) | 4.35 | як на сторінці | 1 | 1 | точний MPN | 2026-10-25 | VD MAIS: JST B3B-XH-A (LF)(SN) (точний MPN): в наявності, 5.81 грн (з ПДВ), мін. 10 шт. ціна від 10 шт; на складі 118 шт | відкрити (https://catalog.vdmais.ua/uk/product/b3b-xh-a-%28lf%29%28sn%29/1418386/) | пошук (https://www.aliexpress.com/w/wholesale-JST-XH-2.5mm-3P-vertical-header-B3B-XH-A.html) |  | Роз'єми та кнопки | J503 вольтметр: 1 V+, 2 GND, 3 SNS | B3B-XH-A(LF)(SN) (JST) | https://imrad.com.ua/ua/b3b-xh-a-9 | 1020
16 | J504 | BTN_EXT | JST_XH_B2B-XH-A_1x02_P2.50mm_Vertical | JST XH 2P вертикальний, крок 2.50 мм, B2B-XH-A(LF)(SN) БЕЗ бобишки. НЕ B2B-XH-AM (з бобишкою: у футпринті J504 немає отвору під неї). НЕ 2.54 мм | 1 | шт | 5 | 1 | 10 | 0 | 10 | 5 | магазин | IMRAD | JST B2B-XH-A (LF)(SN) (точний MPN) | в наявності | 3.20 | 32.00 | відкрити (https://imrad.com.ua/ua/b2b-xh-a-cwf-2-wk-02-9) | IMRAD: «Є в наявності, на складі» (кількість не показано); ціна від 10 шт (1 шт: 3.72, від 50: 3.05). НЕ B2B-XH-AM (з бобишкою) | 3.20 | як на сторінці | 1 | 1 | точний MPN | 2026-10-25 | Космодром: JST B2B-XH-A(LF)(SN) (точний MPN), партнерський склад: під замовлення, 3.73 грн (без ПДВ), мін. 20 шт. 4-6 тижнів, ціна від 20 шт | відкрити (https://kosmodrom.ua/tsq-search?q=B2B-XH-A%28LF%29%28SN%29) | пошук (https://www.aliexpress.com/w/wholesale-JST-XH-2.5mm-2P-vertical-header-B2B-XH-A.html) |  | Роз'єми та кнопки | J504 зовнішня кнопка пробудження: 1 + (+3V3 через R510 1k), 2 BTN (GPIO5) (Population: Populated) | B2B-XH-A(LF)(SN) (JST) | https://imrad.com.ua/ua/b2b-xh-a-cwf-2-wk-02-9 | 1021
17 | L101 | 22uH | L_Bourns_SRN6045TA | 22 мкГн, 6x6 мм під футпринт SRN6045TA, Isat >= 1.6 А: Bourns SRN6045-220M (Isat 1.9 А, Irms 1.5 А, DCR 0.142 Ом max). Sumida CDRH6D38NP-220NC (1.3 А) не ставити | 1 | шт | 5 | 1 | 10 | 0 | 10 | 5 | магазин | VD MAIS | Bourns SRN6045-220M (точний MPN) | в наявності | 12.27 | 122.70 | відкрити (https://catalog.vdmais.ua/uk/product/srn6045-220m/1628266/) | власний склад VD MAIS: 370 шт, строк 0 тижнів; в IMRAD 22 мкГн з Isat >= 1.6 А немає | 12.27 | з ПДВ | 1 | 1 | точний MPN | 2026-10-25 | Космодром: Bourns SRN6045-220M (точний MPN), партнерський склад: під замовлення, 43.37 грн (без ПДВ). 4-6 тижнів | відкрити (https://kosmodrom.ua/tsq-search?q=SRN6045-220M) | пошук (https://www.aliexpress.com/w/wholesale-SRN6045-220M-22uH-inductor.html) |  | Мікросхеми та силові | L101: дросель buck U101 | SRN6045-220M (Bourns) | https://catalog.vdmais.ua/uk/product/srn6045-220m/1628266/ | 2022
18 | Q501 | SI2309CDS | SOT-23 | Лише Si2309CDS (P-MOSFET -60 В, SOT-23); суфікс -T1-GE3 або -T1-E3 | 1 | шт | 5 | 1 | 10 | 0 | 10 | 5 | магазин | IMRAD | Vishay SI2309CDS-T1-GE3 (точний MPN) | в наявності | 57.12 | 571.20 | відкрити (https://imrad.com.ua/ua/si2309cds-t1-ge3-3) | IMRAD: «Є в наявності, на складі» (кількість не показано); одна ціна для будь-якої кількості | 57.12 | як на сторінці | 1 | 1 | точний MPN | 2026-10-25 | Космодром: Vishay SI2309CDS-T1-GE3 (точний MPN): в наявності, 9 грн (без ПДВ). на складі 2980 шт | відкрити (https://kosmodrom.ua/tranzistor-poloviy-mosfet/si2309cds-t1-ge3.html) | пошук (https://www.aliexpress.com/w/wholesale-SI2309CDS-SOT-23.html) |  | Мікросхеми та силові | Q501: ключ живлення вольтметра (GAUGE) | SI2309CDS-T1-GE3 (Vishay Siliconix) | https://imrad.com.ua/ua/si2309cds-t1-ge3-3 | 1023
19 | Q503 | MMBT5551 | SOT-23 | MMBT5551 (NPN 160 В, SOT-23) будь-якого виробника | 1 | шт | 5 | 1 | 10 | 0 | 10 | 5 | магазин | IMRAD | onsemi MMBT5551LT1G (точний MPN) | в наявності | 1.62 | 16.20 | відкрити (https://imrad.com.ua/ua/mmbt5551lt1g-3) | IMRAD: «Є в наявності, на складі» (кількість не показано); ціна від 10 шт (1 шт: 1.72, від 50: 1.54) | 1.62 | як на сторінці | 1 | 1 | точний MPN | 2026-10-25 | Космодром: onsemi MMBT5551LT1G (точний MPN): в наявності, 1 грн (без ПДВ). на складі 804 шт | відкрити (https://kosmodrom.ua/tranzistor-bipolyarniy/mmbt5551lt1g.html) | пошук (https://www.aliexpress.com/w/wholesale-MMBT5551-SOT-23.html) |  | Мікросхеми та силові | Q503: джерело струму затвора Q501 | MMBT5551LT1G (onsemi) | https://imrad.com.ua/ua/mmbt5551lt1g-3 | 1024
20 | R101 | 68k | R_0603_1608Metric | 68 кОм, 0603, 1 % | 1 | шт | 5 | 3 | 0 | 0 | 100 | 95 | магазин | IMRAD | Yageo RC0603FR-0768KL (68 кОм 1 %), упаковка 100 шт | в наявності | 0.104 | 10.40 | відкрити (https://imrad.com.ua/ua/rc0603fr-0768kl-8) | IMRAD: «Є в наявності, на складі» (кількість не показано); 10.40 грн за 100 шт (від 5 уп.: 8.40, від 10: 7.00); ціна в рядку - за 1 шт | 0.104 | як на сторінці | 100 | 100 | точний MPN | 2026-10-25 | Mini-Tech: книга резисторів 0603 власника (аркуш «Набори»): з набору. номінал ряду E24 є в книзі власника: якщо не купувати в IMRAD, у стовпці «Джерело» вибрати «книга резисторів 0603» | відкрити (https://www.mini-tech.com.ua/ua/nabor-smd-rezistorov-0603-170) | пошук (https://www.aliexpress.com/w/wholesale-0603-resistor-68K-1%25.html) |  | Дрібні пасивні | R101: RT частоти U101 (388 кГц) | RC0603FR-0768KL (Yageo) | https://imrad.com.ua/ua/rc0603fr-0768kl-8 | 1025
21 | R102 | 510k | R_0603_1608Metric | 510 кОм, 0603, 1 % | 1 | шт | 5 | 3 | 0 | 0 | 100 | 95 | магазин | IMRAD | Royal Ohm 0603SAF5103T5E (510 кОм 1 %), упаковка 100 шт | в наявності | 0.117 | 11.70 | відкрити (https://imrad.com.ua/ua/0603saf5103t5e-1) | IMRAD: «Є в наявності, на складі» (кількість не показано); 11.70 грн за 100 шт (від 5 уп.: 9.45, від 10: 7.88); ціна в рядку - за 1 шт | 0.117 | як на сторінці | 100 | 100 | точний MPN | 2026-10-25 | Mini-Tech: книга резисторів 0603 власника (аркуш «Набори»): з набору. номінал ряду E24 є в книзі власника: якщо не купувати в IMRAD, у стовпці «Джерело» вибрати «книга резисторів 0603» | відкрити (https://www.mini-tech.com.ua/ua/nabor-smd-rezistorov-0603-170) | пошук (https://www.aliexpress.com/w/wholesale-0603-resistor-510K-1%25.html) |  | Дрібні пасивні | R102: верхнє плече FB U101 (+3V3) | 0603SAF5103T5E (Royal Ohm) | https://imrad.com.ua/ua/0603saf5103t5e-1 | 1026
22 | R103 | 220k | R_0603_1608Metric | 220 кОм, 0603, 1 % | 1 | шт | 5 | 3 | 0 | 0 | 100 | 95 | магазин | IMRAD | Yageo RC0603FR-07220KL (220 кОм 1 %), упаковка 100 шт | в наявності | 0.262 | 26.20 | відкрити (https://imrad.com.ua/ua/rc0603fr-07220kl-8) | IMRAD: «Є в наявності, на складі» (кількість не показано); 26.20 грн за 100 шт (від 5 уп.: 25.20, від 10: 21.00); ціна в рядку - за 1 шт | 0.262 | як на сторінці | 100 | 100 | точний MPN | 2026-10-25 | Mini-Tech: книга резисторів 0603 власника (аркуш «Набори»): з набору. номінал ряду E24 є в книзі власника: якщо не купувати в IMRAD, у стовпці «Джерело» вибрати «книга резисторів 0603» | відкрити (https://www.mini-tech.com.ua/ua/nabor-smd-rezistorov-0603-170) | пошук (https://www.aliexpress.com/w/wholesale-0603-resistor-220K-1%25.html) |  | Дрібні пасивні | R103: нижнє плече FB U101 | RC0603FR-07220KL (Yageo) | https://imrad.com.ua/ua/rc0603fr-07220kl-8 | 1027
23 | R201, R202, R401, R501, R507 | 10k | R_0603_1608Metric | 10 кОм, 0603, 1 % | 5 | шт | 25 | 5 | 0 | 0 | 100 | 75 | магазин | IMRAD | Royal Ohm 0603SAF1002T5E (10 кОм 1 %), упаковка 100 шт | в наявності | 0.1404 | 14.04 | відкрити (https://imrad.com.ua/ua/0603saf1002t5e-2) | IMRAD: «Є в наявності, на складі» (кількість не показано); 14.04 грн за 100 шт (від 5 уп.: 11.34, від 10: 9.45); ціна в рядку - за 1 шт | 0.1404 | як на сторінці | 100 | 100 | точний MPN | 2026-10-25 | Mini-Tech: книга резисторів 0603 власника (аркуш «Набори»): з набору. номінал ряду E24 є в книзі власника: якщо не купувати в IMRAD, у стовпці «Джерело» вибрати «книга резисторів 0603» | відкрити (https://www.mini-tech.com.ua/ua/nabor-smd-rezistorov-0603-170) | пошук (https://www.aliexpress.com/w/wholesale-0603-resistor-10K-1%25.html) |  | Дрібні пасивні | R201 EN, R202 BOOT, R401 NSS, R501 кнопка, R507 емітер Q503 | 0603SAF1002T5E (Royal Ohm) | https://imrad.com.ua/ua/0603saf1002t5e-2 | 1028
24 | R205, R206 | 5.1k | R_0603_1608Metric | Лише 5.1 кОм (вимога USB-C до CC), 0603 | 2 | шт | 10 | 3 | 0 | 0 | 100 | 90 | магазин | IMRAD | Yageo RC0603FR-075K1L (5.1 кОм 1 %), упаковка 100 шт | в наявності | 0.182 | 18.20 | відкрити (https://imrad.com.ua/ua/rc0603fr-075k1l-4) | IMRAD: «Є в наявності, на складі» (кількість не показано); 18.20 грн за 100 шт (від 5 уп.: 14.70, від 10: 12.25); ціна в рядку - за 1 шт | 0.182 | як на сторінці | 100 | 100 | точний MPN | 2026-10-25 | Mini-Tech: книга резисторів 0603 власника (аркуш «Набори»): з набору. номінал ряду E24 є в книзі власника: якщо не купувати в IMRAD, у стовпці «Джерело» вибрати «книга резисторів 0603» | відкрити (https://www.mini-tech.com.ua/ua/nabor-smd-rezistorov-0603-170) | пошук (https://www.aliexpress.com/w/wholesale-0603-resistor-5.1K-1%25.html) |  | Дрібні пасивні | R205/R206: CC1/CC2 USB-C | RC0603FR-075K1L (Yageo) | https://imrad.com.ua/ua/rc0603fr-075k1l-4 | 1029
25 | R208, R209 | 22 | R_0603_1608Metric | 22 Ом, 0603, 1-5 % | 2 | шт | 10 | 3 | 0 | 0 | 100 | 90 | магазин | IMRAD | Yageo RC0603FR-0722RL (22 Ом 1 %), упаковка 100 шт | в наявності | 0.208 | 20.80 | відкрити (https://imrad.com.ua/ua/rc0603fr-0722rl-9) | IMRAD: «Є в наявності, на складі» (кількість не показано); 20.80 грн за 100 шт (від 5 уп.: 16.80, від 10: 14.00); ціна в рядку - за 1 шт | 0.208 | як на сторінці | 100 | 100 | точний MPN | 2026-10-25 | Mini-Tech: книга резисторів 0603 власника (аркуш «Набори»): з набору. номінал ряду E24 є в книзі власника: якщо не купувати в IMRAD, у стовпці «Джерело» вибрати «книга резисторів 0603» | відкрити (https://www.mini-tech.com.ua/ua/nabor-smd-rezistorov-0603-170) | пошук (https://www.aliexpress.com/w/wholesale-0603-resistor-22R.html) |  | Дрібні пасивні | R208/R209: послідовні в USB D+/D- | RC0603FR-0722RL (Yageo) | https://imrad.com.ua/ua/rc0603fr-0722rl-9 | 1030
26 | R304 | 220k 0.1% | R_0805_2012Metric | Лише 220 кОм +/-0.1 %, 25 ppm/K, тонкоплівковий, 0805, робоча напруга >= 100 В: Panasonic ERA-6AEB224V (150 В). 1 % не ставити | 1 | шт | 5 | 3 | 20 | 0 | 20 | 15 | магазин | IMRAD | Panasonic ERA-6AEB224V (220 кОм 0.1 % 25 ppm/K 0805, точний MPN) | в наявності | 5.12 | 102.40 | відкрити (https://imrad.com.ua/ua/era6aeb224v-6) | IMRAD: «Є в наявності, на складі» (кількість не показано); ціна від 10 шт (1 шт: 5.86) | 5.12 | як на сторінці | 1 | 1 | точний MPN | 2026-10-25 | Космодром: Yageo RT0805BRD07220KL (220 кОм 0.1 % 0805), партнерський склад: під замовлення, 4.6 грн (без ПДВ), мін. 20 шт. 4-6 тижнів, мін. 20 шт | відкрити (https://kosmodrom.ua/tsq-search?q=RT0805BRD07220KL) | пошук (https://www.aliexpress.com/w/wholesale-ERA-6AEB224V-220K-0.1%25-0805.html) |  | Дрібні пасивні | R304: верхнє плече дільника батареї (AIN0) | ERA-6AEB224V (Panasonic) | https://imrad.com.ua/ua/era6aeb224v-6 | 1031
27 | R305 | 10k 0.1% | R_0603_1608Metric | Лише 10 кОм +/-0.1 %, 25 ppm/K, тонкоплівковий, 0603. 1 % не ставити | 1 | шт | 5 | 3 | 10 | 0 | 10 | 5 | магазин | VD MAIS | Yageo RT0603BRD0710KL (точний MPN) | в наявності | 2.07 | 20.70 | відкрити (https://catalog.vdmais.ua/uk/product/rt0603brd0710kl/1697301/) | власний склад VD MAIS: 50 шт, строк 0 тижнів; ціна від 10 шт. В IMRAD лише 10.2 кОм 0.1 % (змінило б коефіцієнт дільника) | 2.07 | з ПДВ | 10 | 1 | точний MPN | 2026-10-25 | Космодром: Yageo RT0603BRD0710KL (точний MPN), партнерський склад: під замовлення, 3.06 грн (без ПДВ), мін. 20 шт. 4-6 тижнів, від 20 шт | відкрити (https://kosmodrom.ua/tsq-search?q=RT0603BRD0710KL) | пошук (https://www.aliexpress.com/w/wholesale-RT0603BRD0710KL-10K-0.1%25-0603.html) |  | Дрібні пасивні | R305: нижнє плече дільника батареї (AIN0) | RT0603BRD0710KL (Yageo) | https://catalog.vdmais.ua/uk/product/rt0603brd0710kl/1697301/ | 2032
28 | R307, R502, R503, R510 | 1k | R_0603_1608Metric | 1 кОм, 0603, 1 % | 4 | шт | 20 | 4 | 0 | 0 | 100 | 80 | магазин | IMRAD | Yageo RC0603FR-071KL (1 кОм 1 %), упаковка 100 шт | в наявності | 0.1375 | 13.75 | відкрити (https://imrad.com.ua/ua/rc0603fr-071kl-3) | IMRAD: «Є в наявності, на складі» (кількість не показано); 13.75 грн за 100 шт (від 5 уп.: 11.34, від 10: 9.45); ціна в рядку - за 1 шт | 0.1375 | як на сторінці | 100 | 100 | точний MPN | 2026-10-25 | Mini-Tech: книга резисторів 0603 власника (аркуш «Набори»): з набору. номінал ряду E24 є в книзі власника: якщо не купувати в IMRAD, у стовпці «Джерело» вибрати «книга резисторів 0603» | відкрити (https://www.mini-tech.com.ua/ua/nabor-smd-rezistorov-0603-170) | пошук (https://www.aliexpress.com/w/wholesale-0603-resistor-1K-1%25.html) |  | Дрібні пасивні | R307 AIN0 послідовний; R502/R503 світлодіоди; R510 живлення кнопки | RC0603FR-071KL (Yageo) | https://imrad.com.ua/ua/rc0603fr-071kl-3 | 1033
29 | R504, R505 | 4.7k | R_0603_1608Metric | 4.7 кОм, 0603, 1 % | 2 | шт | 10 | 3 | 0 | 0 | 100 | 90 | магазин | IMRAD | Royal Ohm 0603SAF4701T5E (4.7 кОм 1 %; на сайті SMD0603-4K7-1%), упаковка 100 шт | в наявності | 0.1517 | 15.17 | відкрити (https://imrad.com.ua/ua/smd0603-4k7-1--2) | IMRAD: «Є в наявності, на складі» (кількість не показано); 15.17 грн за 100 шт (від 5 уп.: 14.30, від 10: 13.50); ціна в рядку - за 1 шт | 0.1517 | як на сторінці | 100 | 100 | точний MPN | 2026-10-25 | Mini-Tech: книга резисторів 0603 власника (аркуш «Набори»): з набору. номінал ряду E24 є в книзі власника: якщо не купувати в IMRAD, у стовпці «Джерело» вибрати «книга резисторів 0603» | відкрити (https://www.mini-tech.com.ua/ua/nabor-smd-rezistorov-0603-170) | пошук (https://www.aliexpress.com/w/wholesale-0603-resistor-4.7K-1%25.html) |  | Дрібні пасивні | R504/R505 підтяжки I2C | 0603SAF4701T5E (Royal Ohm) | https://imrad.com.ua/ua/smd0603-4k7-1--2 | 1034
30 | R506, R508, R509 | 100k | R_0603_1608Metric | 100 кОм, 0603, 1 % | 3 | шт | 15 | 3 | 0 | 0 | 100 | 85 | магазин | IMRAD | Yageo AC0603FR-07100KL (100 кОм 1 %), упаковка 100 шт | в наявності | 0.1808 | 18.08 | відкрити (https://imrad.com.ua/ua/ac0603fr-07100kl-5) | IMRAD: «Є в наявності, на складі» (кількість не показано); 18.08 грн за 100 шт (від 5 уп.: 17.68, від 10: 16.90); ціна в рядку - за 1 шт | 0.1808 | як на сторінці | 100 | 100 | точний MPN | 2026-10-25 | Mini-Tech: книга резисторів 0603 власника (аркуш «Набори»): з набору. номінал ряду E24 є в книзі власника: якщо не купувати в IMRAD, у стовпці «Джерело» вибрати «книга резисторів 0603» | відкрити (https://www.mini-tech.com.ua/ua/nabor-smd-rezistorov-0603-170) | пошук (https://www.aliexpress.com/w/wholesale-0603-resistor-100K-1%25.html) |  | Дрібні пасивні | R506 стягування бази Q503; R508 база Q503; R509 затвор-витік Q501 | AC0603FR-07100KL (Yageo) | https://imrad.com.ua/ua/ac0603fr-07100kl-5 | 1035
31 | R511 | 4.7 2512 1W | R_2512_6332Metric | Лише 4.7 Ом 2512 1 Вт товстоплівковий з перевантаженням 2.5 x Ur протягом 5 с (Yageo RC2512JK-074R7L): 1206-резистори на цей футпринт не стають | 1 | шт | 5 | 3 | 10 | 0 | 10 | 5 | магазин | IMRAD | Yageo RC2512JK-074R7L (4.7 Ом 5 % 2512 1 Вт, точний MPN) | в наявності | 1.34 | 13.40 | відкрити (https://imrad.com.ua/ua/rc2512jk-074r7l-2) | IMRAD: «Є в наявності, на складі» (кількість не показано); ціна від 10 шт (1 шт: 1.58, від 100: 1.04) | 1.34 | як на сторінці | 1 | 1 | точний MPN | 2026-10-25 | Космодром: Yageo RC2512JK-074R7L (точний MPN), партнерський склад: під замовлення, 7.51 грн (без ПДВ), мін. 10 шт. 4-6 тижнів, ціна від 10 шт | відкрити (https://kosmodrom.ua/tsq-search?q=RC2512JK-074R7L) | пошук (https://www.aliexpress.com/w/wholesale-RC2512JK-074R7L-4.7R-2512.html) |  | Дрібні пасивні | R511: обмеження струму КЗ виходу на вольтметр (разом з F501) | RC2512JK-074R7L (Yageo) | https://imrad.com.ua/ua/rc2512jk-074r7l-2 | 1036
32 | R512 | 10k | R_1206_3216Metric | 10 кОм, 1206, 1 %, >= 0.25 Вт: Royal Ohm 1206S4F1002T5E (друге джерело Yageo RC1206FR-0710KL) | 1 | шт | 5 | 3 | 100 | 0 | 100 | 95 | магазин | IMRAD | Royal Ohm 1206S4F1002T5E (10 кОм 1 % 1206), упаковка 100 шт | в наявності | 0.2808 | 28.08 | відкрити (https://imrad.com.ua/ua/1206s4f1002t5e-3) | IMRAD: «Є в наявності, на складі» (кількість не показано); 28.08 грн за 100 шт (від 5 уп.: 22.68, від 10: 18.90); ціна в рядку - за 1 шт | 0.2808 | як на сторінці | 100 | 100 | точний MPN | 2026-10-25 | Космодром: Yageo 10 кОм 1 % 1206 0.25 Вт: в наявності, 0.69 грн (без ПДВ), мін. 100 шт. ціна від 100 шт | відкрити (https://kosmodrom.ua/smd-rezistor-2513/smd-rezistor-1206-10-kom-1-tochni.html) | пошук (https://www.aliexpress.com/w/wholesale-1206-resistor-10K-1%25.html) |  | Дрібні пасивні | R512: лінія SENSE вольтметра від VBAT_FUSED | 1206S4F1002T5E (Royal Ohm) | https://imrad.com.ua/ua/1206s4f1002t5e-3 | 1037
33 | TP102, TP103 | +3V3 / GND | TestPoint_Pad_D1.5mm | Деталі немає: контрольні площадки 1.5 мм на платі | 2 | шт | 10 | 0 | 0 | 0 | 0 |  | не купується | не купується | площадки на платі | не купується |  | 0.00 |  |  |  | як на сторінці | 1 | 1 |  |  |  |  |  |  | Без деталі | TP102 +3V3, TP103 GND | -
34 | U101 | LMR38010SDDAR | TI_SO-PowerPAD-8 | LMR38010 у PFM-варіанті: LMR38010SQDDARQ1 (AEC-Q100 версія того самого кристала, той самий корпус) або LMR38010SDDAR. FDDAR / FSDDAR (примусовий PWM) НЕ купувати | 1 | шт | 5 | 1 | 0 | 0 | 6 | 1 | магазин | VD MAIS | TI LMR38010SQDDARQ1 (Q1-версія LMR38010SDDAR), Digi-Key через VD MAIS | під замовлення | 302.184 | 1813.10 | відкрити (https://catalog.vdmais.ua/uk/parasearch/?keyword=LMR38010SQDDARQ1) | Digi-Key 296-LMR38010SQDDARQ1CT-ND: 2220 шт, 3 тижні; 251.82 грн без ПДВ (від 10: 225.26), дані API VD MAIS. В IMRAD немає. Замовляти зараз разом з F501 і U301 | 251.82 | без ПДВ | 1 | 1 | еквівалент | 2026-10-25 | Космодром: TI LMR38010SDDAR (точний MPN KiCad), партнерський склад: під замовлення, 84.59 грн (без ПДВ). 4-6 тижнів | відкрити (https://kosmodrom.ua/tsq-search?q=LMR38010SDDAR) | пошук (https://www.aliexpress.com/w/wholesale-LMR38010SDDAR.html) |  | Мікросхеми та силові | U101: buck 6-31 В -> +3V3 | LMR38010SDDAR (Texas Instruments) | https://catalog.vdmais.ua/uk/parasearch/?keyword=LMR38010SQDDARQ1 | 2039
35 | U201 | ESP32-S3-WROOM-1-N16R8 | ESP32-S3-WROOM-1 | ESP32-S3-WROOM-1-N16R8 (або -N16 / -N8, той самий футпринт). Перед пайкою: маркування, MSL3 – просушити | 1 | шт | 5 | 0 | 0 | 0 | 0 |  | є у власника | є у власника | вже куплено | є у власника |  | 0.00 |  | якщо знадобиться ще – резервний варіант |  | як на сторінці | 1 | 1 |  |  | IMRAD: Espressif ESP32-S3-WROOM-1-N16R8 (точний MPN): в наявності, 480.56 грн (як на сторінці). IMRAD: «Є в наявності, на складі» (кількість не показано); якщо знадобиться ще; 1 шт: 480.56, від 2: 451.73, від 4: 432.51 | відкрити (https://imrad.com.ua/ua/esp32-s3-wroom-1-n16r8-8) | пошук (https://www.aliexpress.com/w/wholesale-ESP32-S3-WROOM-1-N16R8.html) | так | Модулі | U201: мікроконтролер | ESP32-S3-WROOM-1-N16R8 (or -N16 / -N8, same footprint) (Espressif)
36 | U202 | TPS3808G33DBVR | SOT-23-6 | Лише TPS3808G33DBVR. MAX809T (IMRAD) потребує зміни кола скидання: лише rev-b. Може лишитися з rev-c (див. «Вже є») | 1 | шт | 5 | 1 | 0 | 0 | 6 | 1 | магазин | VD MAIS | TI TPS3808G33DBVR (точний MPN) | в наявності | 84.42 | 506.52 | відкрити (https://catalog.vdmais.ua/uk/product/tps3808g33dbvr/1716171/) | власний склад VD MAIS: 227 шт, строк 0 тижнів | 84.42 | з ПДВ | 1 | 1 | точний MPN | 2026-10-25 | IMRAD: TI TPS3808G33DBVR (точний MPN): під замовлення, 109.23 грн (як на сторінці). 6-10 робочих днів; від 14 шт: 66.35 | відкрити (https://imrad.com.ua/ua/tps3808g33dbvr-4) | пошук (https://www.aliexpress.com/w/wholesale-TPS3808G33DBVR.html) | так | Мікросхеми та силові | U202: супервізор живлення на EN | TPS3808G33DBVR (Texas Instruments) | https://catalog.vdmais.ua/uk/product/tps3808g33dbvr/1716171/ | 2041
37 | U203 | USBLC6-2SC6 | SOT-23-6 | Лише ST USBLC6-2SC6 (клони UMW/TECH PUBLIC мають іншу напругу обмеження). Може лишитися з rev-c | 1 | шт | 5 | 1 | 10 | 0 | 10 | 5 | магазин | IMRAD | ST USBLC6-2SC6 (точний MPN) | в наявності | 10.84 | 108.40 | відкрити (https://imrad.com.ua/ua/usblc6-2sc6-4) | IMRAD: «Є в наявності, на складі» (кількість не показано); ціна від 10 шт (1 шт: 11.50, від 35: 10.38) | 10.84 | як на сторінці | 1 | 1 | точний MPN | 2026-10-25 | Космодром: ST USBLC6-2SC6 (точний MPN): в наявності, 7.5 грн (без ПДВ). на складі 61 шт | відкрити (https://kosmodrom.ua/zahisniy-diod-supresor/usblc6-2sc6.html) | пошук (https://www.aliexpress.com/w/wholesale-USBLC6-2SC6.html) | так | Мікросхеми та силові | U203: ESD-захист USB | USBLC6-2SC6 (STMicroelectronics) | https://imrad.com.ua/ua/usblc6-2sc6-4 | 1042
38 | U301 | ADS1115IDGSR | TSSOP-10_3x3mm_P0.5mm | Лише ADS1115IDGSR (VSSOP-10). Модулі-плати ADS1115 не підходять | 1 | шт | 5 | 1 | 0 | 0 | 6 | 1 | магазин | VD MAIS | TI ADS1115IDGSR: 4 шт власний склад VD MAIS + 2 шт Digi-Key через VD MAIS | в наявності | 282.01 | 1692.06 | відкрити (https://catalog.vdmais.ua/uk/product/ads1115idgsr/1745986/) | власний склад: 4 шт по 198.23 грн, строк 0 тижнів; решта 2 шт - Digi-Key 296-38849-1-ND (34304 шт, 3 тижні, 374.63 грн без ПДВ = 449.56 з ПДВ) у тому ж кошику VD MAIS. Ціна в рядку - середня для 6 шт ((4 x 198.23 + 2 x 449.56) / 6 = 282.01); для іншої кількості перерахувати | 282.01 | з ПДВ | 1 | 1 | точний MPN | 2026-10-25 | IMRAD: TI ADS1115IDGSR (точний MPN): під замовлення, 217.65 грн (як на сторінці), мін. 5 шт. 6-10 робочих днів; від 5 шт (1 шт: 346.29, від 10: 205.51) | відкрити (https://imrad.com.ua/ua/ads1115idgsr-3) | пошук (https://www.aliexpress.com/w/wholesale-ADS1115IDGSR.html) |  | Мікросхеми та силові | U301: 16-бітний АЦП напруги батареї, I2C 0x48 | ADS1115IDGSR (Texas Instruments) | https://catalog.vdmais.ua/uk/product/ads1115idgsr/1745986/ | 2043
39 | U401 | Ra-02 | Ra02_Source | Ai-Thinker Ra-02, 433 МГц, з роз'ємом IPEX (не Ra-01, не 868/915 МГц) | 1 | шт | 5 | 0 | 0 | 0 | 0 |  | є у власника | є у власника | вже куплено | є у власника |  | 0.00 |  | якщо знадобиться ще – резервний варіант |  | як на сторінці | 1 | 1 |  |  | Prom.ua - продавець Ra-02: Ai-Thinker Ra-02 SX1278 433 МГц: в наявності, 230 грн (як на сторінці). ціна 230 грн у заголовку сторінки (2026-10-25); діапазон 433 МГц і роз'єм IPEX перевірити на фото перед покупкою | відкрити (https://prom.ua/ua/p3212257815-thinker-433-mgts.html) | пошук (https://www.aliexpress.com/w/wholesale-Ai-Thinker-Ra-02-SX1278-433MHz.html) | так | Модулі | U401: LoRa (FSPI); не вмикати передачу без антени (Population: fitted (owner Q3)) | Ra-02 (Ai-Thinker)
 | РАЗОМ | деталей на 1 плату: |  |  | 59 |  |  |  |  |  |  |  |  |  |  |  | Сума: | 8328.76
 |  |  |  |  |  |  |  |  |  |  |  |  |  |  |  |  | Без ціни: | 0

Sheet: Набори
Аркуш «Набори»: книга SMD резисторів 0603 (ряд E24) власника - безкоштовна альтернатива 9 номіналам 0603, які з 2026-10-25 куплено в IMRAD (щоб брати з книги: «Джерело» = «книга резисторів 0603» на аркуші «Плата»).
«Вже є» = 1: книга вже є у власника (куплена для rev-c). «Купити» = 1, якщо потрібна ще одна (наприклад, книги не вистачає: на аркуші «Плата» статус «набору мало - докупити»).
Якщо книги немає (обидва 0), рядки з джерелом «книга резисторів 0603» стануть червоними: тоді змініть їм «Джерело» на «магазин» і вкажіть магазин.
№ | Набір | Що дає для цієї плати / навіщо | Вже є ✎ | Купити ✎ | Шт кожного номіналу | Магазин | Статус | Ціна, грн | Ціна вказана | Ціна з ПДВ, грн | Сума, грн | Посилання | Примітка
N1 | Книга SMD резисторів 0603: 170 номіналів x 50 шт, 1 %, 0R-10M (ряд E24) | Є у власника (куплена для rev-c). Безкоштовна альтернатива рядкам 0603 E24 (68k, 510k, 220k, 10k, 5.1k, 22, 4.7k, 1k, 100k), які з 2026-10-25 куплено в IMRAD: щоб брати з книги, у стовпці «Джерело» на аркуші «Плата» вибрати «книга резисторів 0603». НЕ містить прецизійні 0.1 % (вони на аркуші «Плата» з магазину). 1 = купити ще одну | 1 | 0 | 50 | Mini-Tech | в наявності | 825.00 | як на сторінці | 825.00 | 0.00 | відкрити (https://www.mini-tech.com.ua/ua/nabor-smd-rezistorov-0603-170) | 170 номіналів 0R-10M = ряд E24 (висновок з кількості)
 |  |  |  |  |  |  |  |  |  | Сума: | 0.00

Sheet: Поза платою
Аркуш «Поза платою»: що ще купити для монтажу плати в корпус. Цих деталей немає в KiCad BOM (не паяються на плату).
Кількість = «На 1 плату» × кількість плат (Інструкція!C5) + «Запас»; жовті клітинки можна змінювати («Вже є» - якщо щось уже лежить у вас). Сума потрапляє в «Кошики», «Список покупок» і підсумок на «Інструкції».
Запобіжник у проводі «+» батареї (тримач + 2 А) - обов'язковий захист проводу (C-01): F101 на платі розриває лише до 50 А. Кріплення H1-H4 - лише пластикове (нейлон), шайби не більше 7 мм.
№ | Для чого | Що купити | Вимоги / допустима заміна | На 1 плату | Од. | Потрібно на всі плати | Запас, шт ✎ | Купити щонайменше ✎ | Вже є ✎ | ЗАМОВИТИ | Магазин ✎ | Що саме замовити | Статус | Ціна на сайті, грн/од. | Ціна вказана | Ціна з ПДВ, грн/од. | Сума, грн | Посилання | Мін. замовл. | Кратність | Примітка до покупки | Резервний варіант | Резерв: посилання
П1 | J503 (кабель модуля в корпусі) | Модуль LED-вольтметра 0.28", 3 дроти, DC 0-100 В | 3-провідний 0.28" вольтметр 0-100 В: червоний - живлення (J503.1 V+), чорний - GND (J503.2), жовтий - вимір (J503.3 SNS) | 1 | шт | 5 | 0 | 0 | 0 | 5 | Prom.ua - DIY mag | Панельний LED вольтметр 0.28" 0-100V DC, 3-провідний | в наявності | 50.00 | як на сторінці | 50.00 | 250.00 | відкрити (https://prom.ua/ua/p2882297154-panelnyj-led-voltmetr.html) | 1 | 1 | сторінка: живлення DC 4-30 В («перевищення може пошкодити»), споживання < 30 мА, колір індикатора випадковий; у 24 В системі під час вирівнюючого заряду (до 31 В) живлення на межі: перевірити на стенді (B6/B7) | Prom.ua - RADIOFORMAT: Вольтметр цифровий DC 0-100 В, 0.28", червоний, трипровідний: в наявності, 49 грн (як на сторінці). діапазон живлення на сторінці не перевірено | відкрити (https://prom.ua/ua/p1469578947-voltmetr-tsifrovoj-100.html)
П2 | J503 B3B-XH-A | Корпус роз'єму JST XHP-3 (відповідь до J503) | JST XHP-3, крок 2.50 мм; контакти SXH-001T-P0.6 окремо | 1 | шт | 5 | 1 | 0 | 0 | 6 | IMRAD | JST XHP-3 | в наявності | 2.16 | як на сторінці | 2.16 | 12.96 | відкрити (https://imrad.com.ua/ua/xhp-3-3) | 1 | 1 | в наявності (кількість не показано)
П3 | J504 B2B-XH-A | Корпус роз'єму JST XHP-2 (відповідь до J504) | JST XHP-2, крок 2.50 мм; контакти SXH-001T-P0.6 окремо | 1 | шт | 5 | 1 | 0 | 0 | 6 | IMRAD | JST XHP-2 | в наявності | 1.72 | як на сторінці | 1.72 | 10.32 | відкрити (https://imrad.com.ua/ua/xhp-2-3) | 1 | 1 | в наявності (кількість не показано)
П4 | XHP-3 (3 шт) + XHP-2 (2 шт) | Контакт обтискний JST SXH-001T-P0.6 (22-28 AWG) | JST SXH-001T-P0.6 для XHP, провід 22-28 AWG (0.08-0.34 мм²); обтискач під JST XH | 5 | шт | 25 | 5 | 0 | 0 | 30 | Космодром | JST SXH-001T-P0.6 (точний MPN) | в наявності | 2.00 | без ПДВ | 2.40 | 72.00 | відкрити (https://kosmodrom.ua/roz-39-yem-ns25-2-54-mm/sxh-001t-p0-6-2.html) | 1 | 1 | на складі 2499 шт | РКС Компоненти: JST SXH-001T-P0.6 (для XHP): в наявності, 2 грн (без ПДВ), мін. 10 шт. у наявності лише 1 шт (Харків), потрібно 30; 10+ по 2.00, 100+ по 1.20 грн без ПДВ | відкрити (https://www.rcscomponents.kiev.ua/search?q=SXH-001T-P0.6)
П5 | H1-H4 (отвори 3.2 мм) | Стійка нейлонова M3, внутрішня-внутрішня різьба, 10 мм | Нейлонова стійка M3 F-F (Nylon 66), шестигранник 5.5 мм; висоту підібрати під корпус | 4 | шт | 20 | 2 | 0 | 0 | 22 | Космодром | PLFF-M3-10 (Nylon 66, M3, 10 мм, F-F) | в наявності | 3.50 | без ПДВ | 4.20 | 92.40 | відкрити (https://kosmodrom.ua/mizhplatni-stiyki-plastikovi/plff-m3-10.html) | 1 | 1 | на складі 40597 шт; матеріал Nylon 66 94V-2 | РКС Компоненти: KLS8-0214-M3-10 (нейлонова M3/M3, 10 мм, внутрішня/зовнішня різьба): під замовлення, 4 грн (без ПДВ), мін. 5 шт. очікується 15000 шт, під замовлення 150 шт, 7-21 день; тоді гвинтів 4 шт на плату + гайка або різьба в корпусі | відкрити (https://www.rcscomponents.kiev.ua/search?q=KLS8-0214-M3-10)
П6 | H1-H4: плата - стійка (4) і стійка - корпус (4) | Гвинт пластиковий M3x6, напівкругла головка 5.5 мм | Пластиковий (нейлоновий) гвинт M3x6, головка до 5.5 мм | 8 | шт | 40 | 4 | 0 | 0 | 44 | РКС Компоненти | KLS8-0318-PF-M3-06 (пластиковий M3x6, головка 5.5 мм) | в наявності | 1.50 | без ПДВ | 1.80 | 79.20 | відкрити (https://www.rcscomponents.kiev.ua/product/hvynt-m3-plastykovyi-kls8-0318-pf-m3-06-head-type-a_158561.html) | 14 | 1 | у наявності 103 шт (Львів 98, Харків 5), очікується 20000 шт (дату не показано); 10+ по 2.00, 14+ по 1.50 грн без ПДВ | Космодром: Гвинт пластиковий, полукругла головка під крест M3*6 (упаковка 100 шт): в наявності, 1.86 грн (без ПДВ), мін. 100 шт. 186 грн за упаковку 100 шт (ціна тут за 1 шт); на складі 10 уп. | відкрити (https://kosmodrom.ua/gvint-kripilniy/gvint-plastikoviy-polukrugla-golovka-pid-krest-m3-6-100pcs-2.html)
П7 | H1-H4 під головку гвинта; обов'язково біля H3 (F101.2 за 4.45 мм) | Шайба пластикова M3, зовн. 6 мм, 1.5 мм | Пластикова шайба M3, зовнішній діаметр <= 7 мм (не DIN 9021) | 4 | шт | 20 | 2 | 0 | 0 | 22 | РКС Компоненти | KangYang WS3-1.5 (пластик, 6 x 3.1 x 1.5 мм) | в наявності | 1.20 | без ПДВ | 1.44 | 31.68 | відкрити (https://www.rcscomponents.kiev.ua/product/shaiba-ws3-1-5_198596.html) | 17 | 1 | у наявності 3323 шт; 14+ по 1.50, 17+ по 1.20 грн без ПДВ | Космодром: Plastic Nylon Flat Washer M3x7x1mm White: в наявності, 1.4 грн (без ПДВ), мін. 100 шт. 3800 шт, від 100 шт | відкрити (https://kosmodrom.ua/shayba-2/plastic-nylon-flat-washer-m3x7x1mm-white-2.html)
П8 | провід батареї «+», не далі 0.2 м від затискача (C-01) | Тримач автомобільного запобіжника MINI (ATM) з кабелем | Тримач у розрив проводу «+» батареї, під запобіжник MINI 11 мм; переріз проводу тримача не менший за провід батареї (0.5-0.75 мм²) | 1 | шт | 5 | 0 | 0 | 0 | 5 | Prom.ua - Connectors | Тримач автомобільного запобіжника міні з кабелем (вологозахисний, з кришкою) | в наявності | 40.00 | як на сторінці | 40.00 | 200.00 | відкрити (https://prom.ua/ua/p2254860639-derzhatel-avtomobilnogo-predohranitelya.html) | 1 | 1 | замовлення у продавця від 150 грн; переріз проводу на сторінці не вказано: перевірити | Prom.ua - RadioShopUA: Тримач запобіжника mini П-образного з кабелем: в наявності, 36 грн (як на сторінці). замовлення у продавця від 100 грн; переріз проводу не вказано | відкрити (https://prom.ua/ua/p3200661263-trimach-zapobizhnika-mini.html)
П9 | у тримач на проводі «+» батареї (C-01); F101 на платі - лише вторинний захист | Запобіжник автомобільний MINI 2 А, 32 В DC | MINI (ATM) 2 А, >= 32 В DC (система 24 В: до 31 В). Для варіанта 48 В - запобіжник >= 80 В DC | 1 | шт | 5 | 5 | 0 | 0 | 10 | РКС Компоненти | MTA MINIVAL 2A (AMFM-2A) | в наявності | 5.00 | без ПДВ | 6.00 | 60.00 | відкрити (https://www.rcscomponents.kiev.ua/product/zapobizhnyk-avtomobilnyi-minival-2a-amfm-2a_168879.html) | 10 | 1 | у наявності 57 шт (Львів); 2+ по 10.00, 10+ по 5.00 грн без ПДВ; 32 В DC - з опису іншої пропозиції того самого MINIVAL 2A MTA на цій сторінці (у картці складу напруги немає): перевірити маркування | Prom.ua - Doodah: Yiyue FN Mini 2A 32V, 10 шт: в наявності, 54 грн (як на сторінці). 54 грн за 10 шт; замовлення у продавця від 200 грн | відкрити (https://prom.ua/ua/p2073082340-predohranitel-elektricheskij-plavkij.html)
 |  |  |  |  |  |  |  |  |  |  |  |  |  |  |  | Сума: | 808.56

Sheet: Кошики
Магазин | Рядків (плата) | Рядків (набори) | Рядків (поза платою) | Сума, грн | Мін. сума продавця, грн | Не вистачає до мінімуму, грн | Як купувати
IMRAD | 29 | 0 | 2 | 3482.60 |  |  | imrad.com.ua, Київ. Основний магазин цієї плати. Ціна як на сторінці (резистори 0603/1206 - за 100 шт).
VD MAIS | 6 | 0 | 0 | 4869.44 |  |  | catalog.vdmais.ua: каталог VD MAIS (партнер Digi-Key в Україні); ціни з ПДВ; оплата карткою для фізосіб.
Космодром | 0 | 0 | 2 | 164.40 |  |  | kosmodrom.ua, Харків. Ціни на сайті без ПДВ; доставка Новою поштою. «4 - 6 тижнів» = партнерський склад, під замовлення.
РКС Компоненти | 0 | 0 | 3 | 170.88 |  |  | rcscomponents.kiev.ua (Радіомаг). Ціни без ПДВ; у кожної позиції свій мінімум, шт.
Prom.ua - Filur Electric | 0 | 0 | 0 | 0.00 | 300 |  | filur.prom.ua; мінімальна сума замовлення на сайті 300 грн.
Prom.ua - DIY mag | 0 | 0 | 1 | 250.00 | 100 | 0.00 | prom.ua, продавець DIY mag; замовлення у продавця від 100 грн (вольтметр, аркуш «Поза платою»).
Prom.ua - Connectors | 0 | 0 | 1 | 200.00 | 150 | 0.00 | prom.ua, продавець Connectors; замовлення у продавця від 150 грн (тримач запобіжника, аркуш «Поза платою»).
Mini-Tech | 0 | 0 | 0 | 0.00 |  |  | mini-tech.com.ua, Київ: книги SMD резисторів (аркуш «Набори»).
AliExpress | 0 | 0 | 0 | 0.00 |  |  | Лише пошукові посилання (сторінки товарів не перевіряються автоматично). Звіряти номінал, корпус і MPN з рядком.
РАЗОМ | 35 | 0 | 9 | 9137.32
Що саме купувати в кожному магазині - аркуш «Список покупок». Доставку і комісії не враховано; рядки без ціни (AliExpress) в суму не входять.

Sheet: Пропозиції
Рядок «Плата» | Позиції | Потрібна деталь | Роль | Магазин | Пропозиція | Відповідність | Статус (оцінка) | Наявність (як на сторінці) | Ціна (як на сторінці) | Заголовок сторінки | HTTP | Деталь названа на сторінці | Посилання | Перевірено
1 | C101 | 22 мкФ 100 В, алюмінієвий SMD 8x10 мм, low-ESR (Panasonic FK або аналог того самого розміру) | обрано | IMRAD | Panasonic EEEFK2A220P (точний MPN) | точний MPN | в наявності | В наявності | 1 16,13 грн/шт 14,82 грн/шт - від 6 13,69 грн/шт - від 15 12,38 грн/шт - від 70 | ᐉ Конденсатор електролітичний Panasonic EEEFK2A220P купити в Києві • IMRAD - український інтернет-магазин радіодеталей | 200 | так | відкрити (https://imrad.com.ua/ua/eeefk2a220p-3) | 2026-10-25
1 | C101 | 22 мкФ 100 В, алюмінієвий SMD 8x10 мм, low-ESR (Panasonic FK або аналог того самого розміру) | резерв | Космодром | Panasonic EEEFK2A220P (точний MPN) | точний MPN | в наявності | Є НА СКЛАДІ, МОЖНА КУПИТИ; на складі 131 шт (склад) | 1+: 14.50 грн без ПДВ; 35+: 14.12 грн без ПДВ; 147+: 13.58 грн без ПДВ | Купити EEEFK2A220P Конденсатор електролітичний на складі КОСМОДРОМ, Харків, Україна | 200 | так | відкрити (https://kosmodrom.ua/kondensator-elektrolitichniy/eeefk2a220p-2.html) | 2026-10-25
1 | C101 | 22 мкФ 100 В, алюмінієвий SMD 8x10 мм, low-ESR (Panasonic FK або аналог того самого розміру) | пошук | AliExpress | пошукова сторінка | пошук |  | пошукова сторінка (товари не перевіряються) |  | EEE FK2A220P 22uF 100V SMD - Buy EEE FK2A220P 22uF 100V SMD with free shipping on AliExpress | 200 | так | відкрити (https://www.aliexpress.com/w/wholesale-EEE-FK2A220P-22uF-100V-SMD.html) | 2026-10-25
2 | C102 | 10 мкФ 100 В X7S 1210, Murata GRM32EC72A106KE05L (той самий з кодом пакування KE05K; допустима заміна Samsung CL32Y106KCVZ4NE) | обрано | IMRAD | Murata GRM32EC72A106KE05L (точний MPN) | точний MPN | в наявності | В наявності | 1 36,53 грн/шт 32,06 грн/шт - від 5 | ᐉ Конденсатор керамічний MURATA GRM32EC72A106KE05L купити в Києві • IMRAD - український інтернет-магазин радіодеталей | 200 | так | відкрити (https://imrad.com.ua/ua/grm32ec72a106ke05l-2) | 2026-10-25
2 | C102 | 10 мкФ 100 В X7S 1210, Murata GRM32EC72A106KE05L (той самий з кодом пакування KE05K; допустима заміна Samsung CL32Y106KCVZ4NE) | резерв | VD MAIS | Murata GRM32EC72A106KE05K (10 мкФ 100 В X7S 1210) | еквівалент | в наявності | Є на складі 60 шт Строк 0 тижн. Всього доступно 60 шт | від 1 44.55 грн від 100 41.02 грн від 200 38.78 грн | C1210 10mkF 10% 100V X7R - Замовити на VD MAIS | 200 | так | відкрити (https://catalog.vdmais.ua/uk/product/grm32ec72a106ke05k/1747843/) | 2026-10-25
2 | C102 | 10 мкФ 100 В X7S 1210, Murata GRM32EC72A106KE05L (той самий з кодом пакування KE05K; допустима заміна Samsung CL32Y106KCVZ4NE) | пошук | AliExpress | пошукова сторінка | пошук |  | пошукова сторінка (товари не перевіряються) |  | 10uF 100V 1210 X7S capacitor - Buy 10uF 100V 1210 X7S capacitor with free shipping on AliExpress | 200 | так | відкрити (https://www.aliexpress.com/w/wholesale-10uF-100V-1210-X7S-capacitor.html) | 2026-10-25
3 | C103 | 100 нФ, 0603, X7R, >= 100 В (Samsung CL10B104KC8NNNC або аналог X7R 100 В) | обрано | IMRAD | Samsung CL10B104KC8NNNC (100 нФ X7R 100 В 0603, точний MPN) | точний MPN | в наявності | В наявності | 1 1,65 грн/шт 1,02 грн/шт - від 10 0,94 грн/шт - від 100 | ᐉ Конденсатор керамічний SAMSUNG CL10B104KC8NNNC купити в Києві • IMRAD - український інтернет-магазин радіодеталей | 200 | так | відкрити (https://imrad.com.ua/ua/cl10b104kc8nnnc-3) | 2026-10-25
3 | C103 | 100 нФ, 0603, X7R, >= 100 В (Samsung CL10B104KC8NNNC або аналог X7R 100 В) | резерв | Космодром | Samsung CL10B104KC8NNNC (точний MPN), партнерський склад | точний MPN | під замовлення | 4 - 6 тижнів (Samsung Electro-Mechanics) | 50+: 2.76 грн без ПДВ | Результаты пошуку за запитом CL10B104KC8NNNC Космодром | 200 | так | відкрити (https://kosmodrom.ua/tsq-search?q=CL10B104KC8NNNC) | 2026-10-25
3 | C103 | 100 нФ, 0603, X7R, >= 100 В (Samsung CL10B104KC8NNNC або аналог X7R 100 В) | пошук | AliExpress | пошукова сторінка | пошук |  | пошукова сторінка (товари не перевіряються) |  | 100nF 100V 0603 X7R capacitor - Buy 100nF 100V 0603 X7R capacitor with free shipping on AliExpress | 200 | так | відкрити (https://www.aliexpress.com/w/wholesale-100nF-100V-0603-X7R-capacitor.html) | 2026-10-25
4 | C104, C202-C205, C301, C302, C402 | 100 нФ, 0603, X7R, >= 25 В (C104 bootstrap >= 16 В): Samsung CL10B104KB8NNNC (50 В) | обрано | IMRAD | Samsung CL10B104KB8NNNC (100 нФ X7R 50 В 0603, точний MPN) | точний MPN | в наявності | В наявності | 1 1,65 грн/шт 0,72 грн/шт - від 10 0,67 грн/шт - від 100 0,63 грн/шт - від 500 | ᐉ Конденсатор керамічний SAMSUNG CL10B104KB8NNNC купити в Києві • IMRAD - український інтернет-магазин радіодеталей | 200 | так | відкрити (https://imrad.com.ua/ua/cl10b104kb8nnnc-8) | 2026-10-25
4 | C104, C202-C205, C301, C302, C402 | 100 нФ, 0603, X7R, >= 25 В (C104 bootstrap >= 16 В): Samsung CL10B104KB8NNNC (50 В) | резерв | Космодром | Samsung CL10B104KB8NNNC (точний MPN), партнерський склад | точний MPN | під замовлення | 4 - 6 тижнів (Samsung Electro-Mechanics) | 100+: 1.79 грн без ПДВ | Результаты пошуку за запитом CL10B104KB8NNNC Космодром | 200 | так | відкрити (https://kosmodrom.ua/tsq-search?q=CL10B104KB8NNNC) | 2026-10-25
4 | C104, C202-C205, C301, C302, C402 | 100 нФ, 0603, X7R, >= 25 В (C104 bootstrap >= 16 В): Samsung CL10B104KB8NNNC (50 В) | пошук | AliExpress | пошукова сторінка | пошук |  | пошукова сторінка (товари не перевіряються) |  | 100nF 0603 X7R 50V capacitor - Buy 100nF 0603 X7R 50V capacitor with free shipping on AliExpress | 200 | так | відкрити (https://www.aliexpress.com/w/wholesale-100nF-0603-X7R-50V-capacitor.html) | 2026-10-25
5 | C105-C107, C201 | 22 мкФ, 0805, X5R, >= 25 В: Murata GRM21BR61E226ME44L (або Samsung CL21A226MAYNNNE того самого класу) | обрано | IMRAD | Murata GRM21BR61E226ME44L (точний MPN) | точний MPN | в наявності | В наявності | 1 13,42 грн/шт 12,04 грн/шт - від 10 11,21 грн/шт - від 100 | ᐉ Конденсатор керамічний MURATA GRM21BR61E226ME44L купити в Києві • IMRAD - український інтернет-магазин радіодеталей | 200 | так | відкрити (https://imrad.com.ua/ua/grm21br61e226me44l-1) | 2026-10-25
5 | C105-C107, C201 | 22 мкФ, 0805, X5R, >= 25 В: Murata GRM21BR61E226ME44L (або Samsung CL21A226MAYNNNE того самого класу) | резерв | Космодром | Murata GRM21BR61E226ME44L (точний MPN), партнерський склад | точний MPN | під замовлення | 4 - 6 тижнів (muRata) | 5+: 32.83 грн без ПДВ | Результаты пошуку за запитом GRM21BR61E226ME44L Космодром | 200 | так | відкрити (https://kosmodrom.ua/tsq-search?q=GRM21BR61E226ME44L) | 2026-10-25
5 | C105-C107, C201 | 22 мкФ, 0805, X5R, >= 25 В: Murata GRM21BR61E226ME44L (або Samsung CL21A226MAYNNNE того самого класу) | пошук | AliExpress | пошукова сторінка | пошук |  | пошукова сторінка (товари не перевіряються) |  | 22uF 25V 0805 X5R capacitor - Buy 22uF 25V 0805 X5R capacitor with free shipping on AliExpress | 200 | так | відкрити (https://www.aliexpress.com/w/wholesale-22uF-25V-0805-X5R-capacitor.html) | 2026-10-25
6 | C401 | 10 мкФ, 0805, X5R або X7R, >= 10 В | обрано | IMRAD | Samsung CL21A106KAYNNNE (точний MPN) | точний MPN | в наявності | В наявності | 1 3,80 грн/шт 3,41 грн/шт - від 10 3,18 грн/шт - від 100 2,98 грн/шт - від 500 | ᐉ Конденсатор керамічний SAMSUNG CL21A106KAYNNNE купити в Києві • IMRAD - український інтернет-магазин радіодеталей | 200 | так | відкрити (https://imrad.com.ua/ua/cl21a106kaynnne-3) | 2026-10-25
6 | C401 | 10 мкФ, 0805, X5R або X7R, >= 10 В | резерв | VD MAIS | Samsung CL21A106KAYNNNE (точний MPN) | точний MPN | в наявності | Є на складі 1293 шт Строк 0 тижн. Всього доступно 1293 шт | від 10 0.92 грн від 100 0.85 грн від 1000 0.81 грн | C0805 10mkF 10% 25V X5R - Замовити на VD MAIS | 200 | так | відкрити (https://catalog.vdmais.ua/uk/product/cl21a106kaynnne/1718726/) | 2026-10-25
6 | C401 | 10 мкФ, 0805, X5R або X7R, >= 10 В | пошук | AliExpress | пошукова сторінка | пошук |  | пошукова сторінка (товари не перевіряються) |  | 10uF 25V 0805 X5R capacitor - Buy 10uF 25V 0805 X5R capacitor with free shipping on AliExpress | 200 | так | відкрити (https://www.aliexpress.com/w/wholesale-10uF-25V-0805-X5R-capacitor.html) | 2026-10-25
7 | D101 | Шотткі 100 В 1 А, SMA: Diodes B1100-13-F (VF 0.79 В max при 1 А). НЕ ставити 60-вольтові SS1x (SS16 тощо) | обрано | IMRAD | Diodes B1100-13-F (100 В, 1 А, SMA, точний MPN) | точний MPN | в наявності | В наявності | 1 6,07 грн/шт 5,55 грн/шт - від 10 5,21 грн/шт - від 50 4,93 грн/шт - від 80 | ᐉ Діод Шоттки DIODES INCORPORATED B1100-13-F купити в Києві • IMRAD - український інтернет-магазин радіодеталей | 200 | так | відкрити (https://imrad.com.ua/ua/b1100-13-f-9) | 2026-10-25
7 | D101 | Шотткі 100 В 1 А, SMA: Diodes B1100-13-F (VF 0.79 В max при 1 А). НЕ ставити 60-вольтові SS1x (SS16 тощо) | резерв | Космодром | Diodes B1100-13-F (точний MPN) | точний MPN | в наявності | Є НА СКЛАДІ, МОЖНА КУПИТИ; на складі 1475 шт (склад) | 1+: 3.00 грн без ПДВ; 216+: 2.31 грн без ПДВ; 958+: 2.09 грн без ПДВ | Купити B1100-13-F Діод Шотткі на складі КОСМОДРОМ, Харків, Україна | 200 | так | відкрити (https://kosmodrom.ua/diod-shottki-2/b1100-13-f.html) | 2026-10-25
7 | D101 | Шотткі 100 В 1 А, SMA: Diodes B1100-13-F (VF 0.79 В max при 1 А). НЕ ставити 60-вольтові SS1x (SS16 тощо) | пошук | AliExpress | пошукова сторінка | пошук |  | пошукова сторінка (товари не перевіряються) |  | B1100 13 F SMA schottky 100V 1A - Buy B1100 13 F SMA schottky 100V 1A with free shipping on AliExpress | 200 | так | відкрити (https://www.aliexpress.com/w/wholesale-B1100-13-F-SMA-schottky-100V-1A.html) | 2026-10-25
8 | D102 | SMAJ33A будь-якого виробника: 33 В, 400 Вт, ОДНОНАПРЯМЛЕНИЙ (не SMAJ33CA), SMA | обрано | IMRAD | ST SMAJ33A-TR (однонаправлений, 33 В, 400 Вт, SMA, точний MPN) | точний MPN | в наявності | В наявності | 1 6,85 грн/шт 6,26 грн/шт - від 10 5,87 грн/шт - від 50 5,56 грн/шт - від 80 | ᐉ Захисний діод ST MICROELECTRONICS SMAJ33A-TR купити в Києві • IMRAD - український інтернет-магазин радіодеталей | 200 | так | відкрити (https://imrad.com.ua/ua/smaj33a-tr-4) | 2026-10-25
8 | D102 | SMAJ33A будь-якого виробника: 33 В, 400 Вт, ОДНОНАПРЯМЛЕНИЙ (не SMAJ33CA), SMA | резерв | Космодром | ST SMAJ33A-TR (точний MPN), партнерський склад | точний MPN | під замовлення | тимчасово немає на складі, очікується (ST) | 4 - 6 тижнів (ST) | 1+: 4.00 грн без ПДВ | 5+: 9.52 грн без ПДВ | Результаты пошуку за запитом SMAJ33A-TR Космодром | 200 | так | відкрити (https://kosmodrom.ua/tsq-search?q=SMAJ33A-TR) | 2026-10-25
8 | D102 | SMAJ33A будь-якого виробника: 33 В, 400 Вт, ОДНОНАПРЯМЛЕНИЙ (не SMAJ33CA), SMA | пошук | AliExpress | пошукова сторінка | пошук |  | пошукова сторінка (товари не перевіряються) |  | SMAJ33A TVS diode SMA unidirectional - Buy SMAJ33A TVS diode SMA unidirectional with free shipping on AliExpress | 200 | так | відкрити (https://www.aliexpress.com/w/wholesale-SMAJ33A-TVS-diode-SMA-unidirectional.html) | 2026-10-25
9 | D501 | Жовто-зелений світлодіод 0603, Vf близько 2.0-2.4 В (571 нм): Lite-On LTST-C191KGKT. НЕ ставити смарагдові 525 нм / 3 В | обрано | IMRAD | Lite-On LTST-C191KGKT (жовто-зелений 571 нм, точний MPN) | точний MPN | в наявності | В наявності | 1 1,84 грн/шт 1,74 грн/шт - від 10 1,56 грн/шт - від 50 1,34 грн/шт - від 100 | ᐉ Світлодіоди SMD LITEON LTST-C191KGKT купити в Києві • IMRAD - український інтернет-магазин радіодеталей | 200 | так | відкрити (https://imrad.com.ua/ua/ltst-c191kgkt-4) | 2026-10-25
9 | D501 | Жовто-зелений світлодіод 0603, Vf близько 2.0-2.4 В (571 нм): Lite-On LTST-C191KGKT. НЕ ставити смарагдові 525 нм / 3 В | резерв | Космодром | Lite-On LTST-C191KGKT (точний MPN), партнерський склад | точний MPN | під замовлення | 4 - 6 тижнів (LITEON) | 50+: 2.00 грн без ПДВ | Результаты пошуку за запитом LTST-C191KGKT Космодром | 200 | так | відкрити (https://kosmodrom.ua/tsq-search?q=LTST-C191KGKT) | 2026-10-25
9 | D501 | Жовто-зелений світлодіод 0603, Vf близько 2.0-2.4 В (571 нм): Lite-On LTST-C191KGKT. НЕ ставити смарагдові 525 нм / 3 В | пошук | AliExpress | пошукова сторінка | пошук |  | пошукова сторінка (товари не перевіряються) |  | LTST C191KGKT 0603 LED - Buy LTST C191KGKT 0603 LED with free shipping on AliExpress | 200 | так | відкрити (https://www.aliexpress.com/w/wholesale-LTST-C191KGKT-0603-LED.html) | 2026-10-25
10 | D502 | Червоний світлодіод 0603, 630 нм, Vf близько 2 В: Kingbright KP-1608SURCK | обрано | IMRAD | Kingbright KP-1608SURCK (червоний 630 нм, точний MPN) | точний MPN | в наявності | В наявності | 1 4,96 грн/шт 4,69 грн/шт - від 10 4,21 грн/шт - від 50 3,61 грн/шт - від 100 | ᐉ Світлодіоди SMD KINGBRIGHT ELECTRONIC KP-1608SURCK купити в Києві • IMRAD - український інтернет-магазин радіодеталей | 200 | так | відкрити (https://imrad.com.ua/ua/kp-1608surck-3) | 2026-10-25
10 | D502 | Червоний світлодіод 0603, 630 нм, Vf близько 2 В: Kingbright KP-1608SURCK | резерв | Космодром | Kingbright KP-1608SURCK (точний MPN), партнерський склад | точний MPN | під замовлення | 4 - 6 тижнів (Kingbright) | 5+: 11.50 грн без ПДВ | Результаты пошуку за запитом KP-1608SURCK Космодром | 200 | так | відкрити (https://kosmodrom.ua/tsq-search?q=KP-1608SURCK) | 2026-10-25
10 | D502 | Червоний світлодіод 0603, 630 нм, Vf близько 2 В: Kingbright KP-1608SURCK | пошук | AliExpress | пошукова сторінка | пошук |  | пошукова сторінка (товари не перевіряються) |  | KP 1608SURCK 0603 red LED - Buy KP 1608SURCK 0603 red LED with free shipping on AliExpress | 200 | так | відкрити (https://www.aliexpress.com/w/wholesale-KP-1608SURCK-0603-red-LED.html) | 2026-10-25
11 | F101 | Лише Littelfuse 0451002.MRL (NANO2 451, 2 А 125 В, дуже швидкий) під футпринт Fuse_Littelfuse-NANO2-451_453. 1206-запобіжники 0466 на цей футпринт не стають | обрано | IMRAD | Littelfuse 0451002.MRL (NANO2, 2 А 125 В, точний MPN) | точний MPN | в наявності | В наявності | 1 57,93 грн/шт 55,03 грн/шт - від 4 49,95 грн/шт - від 8 45,86 грн/шт - від 24 | ᐉ Запобіжник плавкий LITTELFUSE 0451002.MRL купити в Києві • IMRAD - український інтернет-магазин радіодеталей | 200 | так | відкрити (https://imrad.com.ua/ua/0451002-mrl-2) | 2026-10-25
11 | F101 | Лише Littelfuse 0451002.MRL (NANO2 451, 2 А 125 В, дуже швидкий) під футпринт Fuse_Littelfuse-NANO2-451_453. 1206-запобіжники 0466 на цей футпринт не стають | резерв | Космодром | Littelfuse 0451002.MRL (точний MPN; виробник на сайті «LTL») | точний MPN | в наявності | Є НА СКЛАДІ, МОЖНА КУПИТИ; на складі 806 шт (склад) | 1+: 8.00 грн без ПДВ; 71+: 7.07 грн без ПДВ; 303+: 6.60 грн без ПДВ | Купити 0451002.MRL Запобіжник плавкий на складі КОСМОДРОМ, Харків, Україна | 200 | так | відкрити (https://kosmodrom.ua/zapobizhnik-plavkiy/0451002-mrl.html) | 2026-10-25
11 | F101 | Лише Littelfuse 0451002.MRL (NANO2 451, 2 А 125 В, дуже швидкий) під футпринт Fuse_Littelfuse-NANO2-451_453. 1206-запобіжники 0466 на цей футпринт не стають | пошук | AliExpress | пошукова сторінка | пошук |  | пошукова сторінка (товари не перевіряються) |  | 0451002.MRL NANO2 2A fuse - Buy 0451002.MRL NANO2 2A fuse with free shipping on AliExpress | 200 | так | відкрити (https://www.aliexpress.com/w/wholesale-0451002.MRL-NANO2-2A-fuse.html) | 2026-10-25
12 | F501 | Лише Littelfuse 0466.250NRHF (0.25 А, 125 В, дуже швидкий, 1206). Інший номінал не ставити: розраховано разом з R511 | обрано | VD MAIS | Littelfuse 0466.250NRHF (точний MPN), Digi-Key через VD MAIS | точний MPN | під замовлення |  |  | Пошук по каталогу VD MAIS: 0466.250NRHF | 200 | так | відкрити (https://catalog.vdmais.ua/uk/parasearch/?keyword=0466.250NRHF) | 2026-10-25
12 | F501 | Лише Littelfuse 0466.250NRHF (0.25 А, 125 В, дуже швидкий, 1206). Інший номінал не ставити: розраховано разом з R511 | резерв | Космодром | Littelfuse 0466.250NRHF (точний MPN), партнерський склад | точний MPN | під замовлення | 4 - 6 тижнів (Littelfuse) | 5+: 8.85 грн без ПДВ | Результаты пошуку за запитом 0466.250NRHF Космодром | 200 | так | відкрити (https://kosmodrom.ua/tsq-search?q=0466.250NRHF) | 2026-10-25
12 | F501 | Лише Littelfuse 0466.250NRHF (0.25 А, 125 В, дуже швидкий, 1206). Інший номінал не ставити: розраховано разом з R511 | пошук | AliExpress | пошукова сторінка | пошук |  | пошукова сторінка (товари не перевіряються) |  | 0466.250 fuse 1206 250mA - Buy 0466.250 fuse 1206 250mA with free shipping on AliExpress | 200 | так | відкрити (https://www.aliexpress.com/w/wholesale-0466.250-fuse-1206-250mA.html) | 2026-10-25
14 | J201 | GCT USB4105-GF-A на футпринті HRO TYPE-C-31-M-12 (сигнальні площадки ті самі; ніжки корпусу 0.80/1.10 мм у пазах 1.2/1.7 мм): приміряти на голій платі перед пайкою | обрано | IMRAD | GCT USB4105-GF-A (точний MPN) | точний MPN | в наявності | В наявності | 1 37,65 грн/шт 36,30 грн/шт - від 4 34,96 грн/шт - від 8 33,62 грн/шт - від 20 | ᐉ Роз'єм USB GCT USB4105-GF-A купити в Києві • IMRAD - український інтернет-магазин радіодеталей | 200 | так | відкрити (https://imrad.com.ua/ua/usb4105-gf-a-1) | 2026-10-25
14 | J201 | GCT USB4105-GF-A на футпринті HRO TYPE-C-31-M-12 (сигнальні площадки ті самі; ніжки корпусу 0.80/1.10 мм у пазах 1.2/1.7 мм): приміряти на голій платі перед пайкою | резерв | Космодром | GCT USB4105-GF-A (точний MPN) | точний MPN | в наявності | Є НА СКЛАДІ, МОЖНА КУПИТИ; на складі 726 шт (склад) | 1+: 44.00 грн без ПДВ; 12+: 42.81 грн без ПДВ; 49+: 41.19 грн без ПДВ | Купити USB4105-GF-A USB роз'єм на складі КОСМОДРОМ, Харків, Україна | 200 | так | відкрити (https://kosmodrom.ua/usb-roz-39-yem/10sq050-dc.html) | 2026-10-25
14 | J201 | GCT USB4105-GF-A на футпринті HRO TYPE-C-31-M-12 (сигнальні площадки ті самі; ніжки корпусу 0.80/1.10 мм у пазах 1.2/1.7 мм): приміряти на голій платі перед пайкою | пошук | AliExpress | пошукова сторінка | пошук |  | пошукова сторінка (товари не перевіряються) |  | USB4105 GF A USB C - Buy USB4105 GF A USB C with free shipping on AliExpress | 200 | так | відкрити (https://www.aliexpress.com/w/wholesale-USB4105-GF-A-USB-C.html) | 2026-10-25
15 | J503 | JST XH 3P вертикальний, крок 2.50 мм (B3B-XH-A). НЕ 2.54 мм | обрано | IMRAD | JST B3B-XH-A (точний MPN) | точний MPN | в наявності | В наявності | 1 4,82 грн/шт 4,35 грн/шт - від 10 4,20 грн/шт - від 35 3,89 грн/шт - від 100 | Роз'єми сигнальні растр 2,50мм JST B3B-XH-A | 200 | так | відкрити (https://imrad.com.ua/ua/b3b-xh-a-9) | 2026-10-25
15 | J503 | JST XH 3P вертикальний, крок 2.50 мм (B3B-XH-A). НЕ 2.54 мм | резерв | VD MAIS | JST B3B-XH-A (LF)(SN) (точний MPN) | точний MPN | в наявності | Є на складі 118 шт Строк 0 тижн. Всього доступно 118 шт | від 10 5.81 грн від 10000 5.17 грн від 15000 4.69 грн | B3B-XH-A - Замовити на VD MAIS | 200 | так | відкрити (https://catalog.vdmais.ua/uk/product/b3b-xh-a-%28lf%29%28sn%29/1418386/) | 2026-10-25
15 | J503 | JST XH 3P вертикальний, крок 2.50 мм (B3B-XH-A). НЕ 2.54 мм | пошук | AliExpress | пошукова сторінка | пошук |  | пошукова сторінка (товари не перевіряються) |  | JST XH 2.5mm 3P vertical header B3B XH A - Buy JST XH 2.5mm 3P vertical header B3B XH A with free shipping on AliExpress | 200 | так | відкрити (https://www.aliexpress.com/w/wholesale-JST-XH-2.5mm-3P-vertical-header-B3B-XH-A.html) | 2026-10-25
16 | J504 | JST XH 2P вертикальний, крок 2.50 мм, B2B-XH-A(LF)(SN) БЕЗ бобишки. НЕ B2B-XH-AM (з бобишкою: у футпринті J504 немає отвору під неї). НЕ 2.54 мм | обрано | IMRAD | JST B2B-XH-A (LF)(SN) (точний MPN) | точний MPN | в наявності | В наявності | 1 3,72 грн/шт 3,20 грн/шт - від 10 3,05 грн/шт - від 50 | Роз'єми сигнальні растр 2,50мм JST B2B-XH-A [CWF-2] [WK-02] | 200 | так | відкрити (https://imrad.com.ua/ua/b2b-xh-a-cwf-2-wk-02-9) | 2026-10-25
16 | J504 | JST XH 2P вертикальний, крок 2.50 мм, B2B-XH-A(LF)(SN) БЕЗ бобишки. НЕ B2B-XH-AM (з бобишкою: у футпринті J504 немає отвору під неї). НЕ 2.54 мм | резерв | Космодром | JST B2B-XH-A(LF)(SN) (точний MPN), партнерський склад | точний MPN | під замовлення | 4 - 6 тижнів (JST) | 20+: 3.73 грн без ПДВ | Результаты пошуку за запитом B2B-XH-A(LF)(SN) Космодром | 200 | так | відкрити (https://kosmodrom.ua/tsq-search?q=B2B-XH-A%28LF%29%28SN%29) | 2026-10-25
16 | J504 | JST XH 2P вертикальний, крок 2.50 мм, B2B-XH-A(LF)(SN) БЕЗ бобишки. НЕ B2B-XH-AM (з бобишкою: у футпринті J504 немає отвору під неї). НЕ 2.54 мм | пошук | AliExpress | пошукова сторінка | пошук |  | пошукова сторінка (товари не перевіряються) |  | JST XH 2.5mm 2P vertical header B2B XH A - Buy JST XH 2.5mm 2P vertical header B2B XH A with free shipping on AliExpress | 200 | так | відкрити (https://www.aliexpress.com/w/wholesale-JST-XH-2.5mm-2P-vertical-header-B2B-XH-A.html) | 2026-10-25
17 | L101 | 22 мкГн, 6x6 мм під футпринт SRN6045TA, Isat >= 1.6 А: Bourns SRN6045-220M (Isat 1.9 А, Irms 1.5 А, DCR 0.142 Ом max). Sumida CDRH6D38NP-220NC (1.3 А) не ставити | обрано | VD MAIS | Bourns SRN6045-220M (точний MPN) | точний MPN | в наявності | Є на складі 370 шт Строк 0 тижн. Всього доступно 370 шт | від 1 12.27 грн | SRN6045-220M - Замовити на VD MAIS | 200 | так | відкрити (https://catalog.vdmais.ua/uk/product/srn6045-220m/1628266/) | 2026-10-25
17 | L101 | 22 мкГн, 6x6 мм під футпринт SRN6045TA, Isat >= 1.6 А: Bourns SRN6045-220M (Isat 1.9 А, Irms 1.5 А, DCR 0.142 Ом max). Sumida CDRH6D38NP-220NC (1.3 А) не ставити | резерв | Космодром | Bourns SRN6045-220M (точний MPN), партнерський склад | точний MPN | під замовлення | 4 - 6 тижнів (BOURNS) | 1+: 43.37 грн без ПДВ | Результаты пошуку за запитом SRN6045-220M Космодром | 200 | так | відкрити (https://kosmodrom.ua/tsq-search?q=SRN6045-220M) | 2026-10-25
17 | L101 | 22 мкГн, 6x6 мм під футпринт SRN6045TA, Isat >= 1.6 А: Bourns SRN6045-220M (Isat 1.9 А, Irms 1.5 А, DCR 0.142 Ом max). Sumida CDRH6D38NP-220NC (1.3 А) не ставити | пошук | AliExpress | пошукова сторінка | пошук |  | пошукова сторінка (товари не перевіряються) |  | SRN6045 220M 22uH inductor - Buy SRN6045 220M 22uH inductor with free shipping on AliExpress | 200 | так | відкрити (https://www.aliexpress.com/w/wholesale-SRN6045-220M-22uH-inductor.html) | 2026-10-25
18 | Q501 | Лише Si2309CDS (P-MOSFET -60 В, SOT-23); суфікс -T1-GE3 або -T1-E3 | обрано | IMRAD | Vishay SI2309CDS-T1-GE3 (точний MPN) | точний MPN | в наявності | В наявності | 1 57,12 грн/шт | ᐉ MOSFET транзистор VISHAY SI2309CDS-T1-GE3 купити в Києві • IMRAD - український інтернет-магазин радіодеталей | 200 | так | відкрити (https://imrad.com.ua/ua/si2309cds-t1-ge3-3) | 2026-10-25
18 | Q501 | Лише Si2309CDS (P-MOSFET -60 В, SOT-23); суфікс -T1-GE3 або -T1-E3 | резерв | Космодром | Vishay SI2309CDS-T1-GE3 (точний MPN) | точний MPN | в наявності | Є НА СКЛАДІ, МОЖНА КУПИТИ; на складі 2980 шт (склад) | 1+: 9.00 грн без ПДВ; 61+: 8.14 грн без ПДВ; 272+: 7.36 грн без ПДВ | Купити SI2309CDS-T1-GE3 Транзистор польовий MOSFET на складі КОСМОДРОМ, Харків, Україна | 200 | так | відкрити (https://kosmodrom.ua/tranzistor-poloviy-mosfet/si2309cds-t1-ge3.html) | 2026-10-25
18 | Q501 | Лише Si2309CDS (P-MOSFET -60 В, SOT-23); суфікс -T1-GE3 або -T1-E3 | пошук | AliExpress | пошукова сторінка | пошук |  | пошукова сторінка (товари не перевіряються) |  | SI2309CDS SOT 23 - Buy SI2309CDS SOT 23 with free shipping on AliExpress | 200 | так | відкрити (https://www.aliexpress.com/w/wholesale-SI2309CDS-SOT-23.html) | 2026-10-25
19 | Q503 | MMBT5551 (NPN 160 В, SOT-23) будь-якого виробника | обрано | IMRAD | onsemi MMBT5551LT1G (точний MPN) | точний MPN | в наявності | В наявності | 1 1,72 грн/шт 1,62 грн/шт - від 10 1,54 грн/шт - від 50 1,40 грн/шт - від 100 | ᐉ Біполярний транзистор ON Semiconductor MMBT5551LT1G купити в Києві • IMRAD - український інтернет-магазин радіодеталей | 200 | так | відкрити (https://imrad.com.ua/ua/mmbt5551lt1g-3) | 2026-10-25
19 | Q503 | MMBT5551 (NPN 160 В, SOT-23) будь-якого виробника | резерв | Космодром | onsemi MMBT5551LT1G (точний MPN) | точний MPN | в наявності | Є НА СКЛАДІ, МОЖНА КУПИТИ; на складі 804 шт (склад) | 1+: 1.00 грн без ПДВ; 628+: 0.80 грн без ПДВ; 2782+: 0.72 грн без ПДВ | Купити MMBT5551LT1G Транзистор біполярний на складі КОСМОДРОМ, Харків, Україна | 200 | так | відкрити (https://kosmodrom.ua/tranzistor-bipolyarniy/mmbt5551lt1g.html) | 2026-10-25
19 | Q503 | MMBT5551 (NPN 160 В, SOT-23) будь-якого виробника | пошук | AliExpress | пошукова сторінка | пошук |  | пошукова сторінка (товари не перевіряються) |  | MMBT5551 SOT 23 - Buy MMBT5551 SOT 23 with free shipping on AliExpress | 200 | так | відкрити (https://www.aliexpress.com/w/wholesale-MMBT5551-SOT-23.html) | 2026-10-25
20 | R101 | 68 кОм, 0603, 1 % | обрано | IMRAD | Yageo RC0603FR-0768KL (68 кОм 1 %), упаковка 100 шт | точний MPN | в наявності | В наявності |  | ᐉ Резистори smd YAGEO RC0603FR-0768KL купити в Києві • IMRAD - український інтернет-магазин радіодеталей | 200 | так | відкрити (https://imrad.com.ua/ua/rc0603fr-0768kl-8) | 2026-10-25
20 | R101 | 68 кОм, 0603, 1 % | резерв | Mini-Tech | книга резисторів 0603 власника (аркуш «Набори») | еквівалент | з набору | В наявності | 825.00 грн | Набір SMD резисторів у книзі 0603 170 типів 0,125 Вт 1% | 200 | так | відкрити (https://www.mini-tech.com.ua/ua/nabor-smd-rezistorov-0603-170) | 2026-10-25
20 | R101 | 68 кОм, 0603, 1 % | пошук | AliExpress | пошукова сторінка | пошук |  | пошукова сторінка (товари не перевіряються) |  | 0603 resistor 68K 1% - Buy 0603 resistor 68K 1% with free shipping on AliExpress | 200 | так | відкрити (https://www.aliexpress.com/w/wholesale-0603-resistor-68K-1%25.html) | 2026-10-25
21 | R102 | 510 кОм, 0603, 1 % | обрано | IMRAD | Royal Ohm 0603SAF5103T5E (510 кОм 1 %), упаковка 100 шт | точний MPN | в наявності | В наявності |  | ᐉ Резистори smd ROYAL OHM 0603SAF5103T5E купити в Києві • IMRAD - український інтернет-магазин радіодеталей | 200 | так | відкрити (https://imrad.com.ua/ua/0603saf5103t5e-1) | 2026-10-25
21 | R102 | 510 кОм, 0603, 1 % | резерв | Mini-Tech | книга резисторів 0603 власника (аркуш «Набори») | еквівалент | з набору | В наявності | 825.00 грн | Набір SMD резисторів у книзі 0603 170 типів 0,125 Вт 1% | 200 | так | відкрити (https://www.mini-tech.com.ua/ua/nabor-smd-rezistorov-0603-170) | 2026-10-25
21 | R102 | 510 кОм, 0603, 1 % | пошук | AliExpress | пошукова сторінка | пошук |  | пошукова сторінка (товари не перевіряються) |  | 0603 resistor 510K 1% - Buy 0603 resistor 510K 1% with free shipping on AliExpress | 200 | так | відкрити (https://www.aliexpress.com/w/wholesale-0603-resistor-510K-1%25.html) | 2026-10-25
22 | R103 | 220 кОм, 0603, 1 % | обрано | IMRAD | Yageo RC0603FR-07220KL (220 кОм 1 %), упаковка 100 шт | точний MPN | в наявності | В наявності |  | ᐉ Резистори smd YAGEO RC0603FR-07220KL купити в Києві • IMRAD - український інтернет-магазин радіодеталей | 200 | так | відкрити (https://imrad.com.ua/ua/rc0603fr-07220kl-8) | 2026-10-25
22 | R103 | 220 кОм, 0603, 1 % | резерв | Mini-Tech | книга резисторів 0603 власника (аркуш «Набори») | еквівалент | з набору | В наявності | 825.00 грн | Набір SMD резисторів у книзі 0603 170 типів 0,125 Вт 1% | 200 | так | відкрити (https://www.mini-tech.com.ua/ua/nabor-smd-rezistorov-0603-170) | 2026-10-25
22 | R103 | 220 кОм, 0603, 1 % | пошук | AliExpress | пошукова сторінка | пошук |  | пошукова сторінка (товари не перевіряються) |  | 0603 resistor 220K 1% - Buy 0603 resistor 220K 1% with free shipping on AliExpress | 200 | так | відкрити (https://www.aliexpress.com/w/wholesale-0603-resistor-220K-1%25.html) | 2026-10-25
23 | R201, R202, R401, R501, R507 | 10 кОм, 0603, 1 % | обрано | IMRAD | Royal Ohm 0603SAF1002T5E (10 кОм 1 %), упаковка 100 шт | точний MPN | в наявності | В наявності |  | ᐉ Резистори smd ROYAL OHM 0603SAF1002T5E купити в Києві • IMRAD - український інтернет-магазин радіодеталей | 200 | так | відкрити (https://imrad.com.ua/ua/0603saf1002t5e-2) | 2026-10-25
23 | R201, R202, R401, R501, R507 | 10 кОм, 0603, 1 % | резерв | Mini-Tech | книга резисторів 0603 власника (аркуш «Набори») | еквівалент | з набору | В наявності | 825.00 грн | Набір SMD резисторів у книзі 0603 170 типів 0,125 Вт 1% | 200 | так | відкрити (https://www.mini-tech.com.ua/ua/nabor-smd-rezistorov-0603-170) | 2026-10-25
23 | R201, R202, R401, R501, R507 | 10 кОм, 0603, 1 % | пошук | AliExpress | пошукова сторінка | пошук |  | пошукова сторінка (товари не перевіряються) |  | 0603 resistor 10K 1% - Buy 0603 resistor 10K 1% with free shipping on AliExpress | 200 | так | відкрити (https://www.aliexpress.com/w/wholesale-0603-resistor-10K-1%25.html) | 2026-10-25
24 | R205, R206 | Лише 5.1 кОм (вимога USB-C до CC), 0603 | обрано | IMRAD | Yageo RC0603FR-075K1L (5.1 кОм 1 %), упаковка 100 шт | точний MPN | в наявності | В наявності |  | ᐉ Резистори smd YAGEO RC0603FR-075K1L купити в Києві • IMRAD - український інтернет-магазин радіодеталей | 200 | так | відкрити (https://imrad.com.ua/ua/rc0603fr-075k1l-4) | 2026-10-25
24 | R205, R206 | Лише 5.1 кОм (вимога USB-C до CC), 0603 | резерв | Mini-Tech | книга резисторів 0603 власника (аркуш «Набори») | еквівалент | з набору | В наявності | 825.00 грн | Набір SMD резисторів у книзі 0603 170 типів 0,125 Вт 1% | 200 | так | відкрити (https://www.mini-tech.com.ua/ua/nabor-smd-rezistorov-0603-170) | 2026-10-25
24 | R205, R206 | Лише 5.1 кОм (вимога USB-C до CC), 0603 | пошук | AliExpress | пошукова сторінка | пошук |  | пошукова сторінка (товари не перевіряються) |  | 0603 resistor 5.1K 1% - Buy 0603 resistor 5.1K 1% with free shipping on AliExpress | 200 | так | відкрити (https://www.aliexpress.com/w/wholesale-0603-resistor-5.1K-1%25.html) | 2026-10-25
25 | R208, R209 | 22 Ом, 0603, 1-5 % | обрано | IMRAD | Yageo RC0603FR-0722RL (22 Ом 1 %), упаковка 100 шт | точний MPN | в наявності | В наявності |  | ᐉ Резистори smd YAGEO RC0603FR-0722RL купити в Києві • IMRAD - український інтернет-магазин радіодеталей | 200 | так | відкрити (https://imrad.com.ua/ua/rc0603fr-0722rl-9) | 2026-10-25
25 | R208, R209 | 22 Ом, 0603, 1-5 % | резерв | Mini-Tech | книга резисторів 0603 власника (аркуш «Набори») | еквівалент | з набору | В наявності | 825.00 грн | Набір SMD резисторів у книзі 0603 170 типів 0,125 Вт 1% | 200 | так | відкрити (https://www.mini-tech.com.ua/ua/nabor-smd-rezistorov-0603-170) | 2026-10-25
25 | R208, R209 | 22 Ом, 0603, 1-5 % | пошук | AliExpress | пошукова сторінка | пошук |  | пошукова сторінка (товари не перевіряються) |  | 0603 resistor 22R - Buy 0603 resistor 22R with free shipping on AliExpress | 200 | так | відкрити (https://www.aliexpress.com/w/wholesale-0603-resistor-22R.html) | 2026-10-25
26 | R304 | Лише 220 кОм +/-0.1 %, 25 ppm/K, тонкоплівковий, 0805, робоча напруга >= 100 В: Panasonic ERA-6AEB224V (150 В). 1 % не ставити | обрано | IMRAD | Panasonic ERA-6AEB224V (220 кОм 0.1 % 25 ppm/K 0805, точний MPN) | точний MPN | в наявності | В наявності | 1 5,86 грн/шт 5,12 грн/шт - від 10 | ᐉ Резистори smd Panasonic ERA6AEB224V купити в Києві • IMRAD - український інтернет-магазин радіодеталей | 200 | так | відкрити (https://imrad.com.ua/ua/era6aeb224v-6) | 2026-10-25
26 | R304 | Лише 220 кОм +/-0.1 %, 25 ppm/K, тонкоплівковий, 0805, робоча напруга >= 100 В: Panasonic ERA-6AEB224V (150 В). 1 % не ставити | резерв | Космодром | Yageo RT0805BRD07220KL (220 кОм 0.1 % 0805), партнерський склад | еквівалент | під замовлення | 4 - 6 тижнів (YAGEO) | 20+: 4.60 грн без ПДВ | Результаты пошуку за запитом RT0805BRD07220KL Космодром | 200 | так | відкрити (https://kosmodrom.ua/tsq-search?q=RT0805BRD07220KL) | 2026-10-25
26 | R304 | Лише 220 кОм +/-0.1 %, 25 ppm/K, тонкоплівковий, 0805, робоча напруга >= 100 В: Panasonic ERA-6AEB224V (150 В). 1 % не ставити | пошук | AliExpress | пошукова сторінка | пошук |  | пошукова сторінка (товари не перевіряються) |  | ERA 6AEB224V 220K 0.1% 0805 - Buy ERA 6AEB224V 220K 0.1% 0805 with free shipping on AliExpress | 200 | так | відкрити (https://www.aliexpress.com/w/wholesale-ERA-6AEB224V-220K-0.1%25-0805.html) | 2026-10-25
27 | R305 | Лише 10 кОм +/-0.1 %, 25 ppm/K, тонкоплівковий, 0603. 1 % не ставити | обрано | VD MAIS | Yageo RT0603BRD0710KL (точний MPN) | точний MPN | в наявності | Є на складі 50 шт Строк 0 тижн. Всього доступно 50 шт | від 10 2.07 грн від 100 1.56 грн від 1000 1.42 грн | RC0603 10 kOm 0.1% 25ppm - Замовити на VD MAIS | 200 | так | відкрити (https://catalog.vdmais.ua/uk/product/rt0603brd0710kl/1697301/) | 2026-10-25
27 | R305 | Лише 10 кОм +/-0.1 %, 25 ppm/K, тонкоплівковий, 0603. 1 % не ставити | резерв | Космодром | Yageo RT0603BRD0710KL (точний MPN), партнерський склад | точний MPN | під замовлення | 4 - 6 тижнів (YAGEO) | 20+: 3.06 грн без ПДВ | Результаты пошуку за запитом RT0603BRD0710KL Космодром | 200 | так | відкрити (https://kosmodrom.ua/tsq-search?q=RT0603BRD0710KL) | 2026-10-25
27 | R305 | Лише 10 кОм +/-0.1 %, 25 ppm/K, тонкоплівковий, 0603. 1 % не ставити | пошук | AliExpress | пошукова сторінка | пошук |  | пошукова сторінка (товари не перевіряються) |  | RT0603BRD0710KL 10K 0.1% 0603 - Buy RT0603BRD0710KL 10K 0.1% 0603 with free shipping on AliExpress | 200 | так | відкрити (https://www.aliexpress.com/w/wholesale-RT0603BRD0710KL-10K-0.1%25-0603.html) | 2026-10-25
28 | R307, R502, R503, R510 | 1 кОм, 0603, 1 % | обрано | IMRAD | Yageo RC0603FR-071KL (1 кОм 1 %), упаковка 100 шт | точний MPN | в наявності | В наявності |  | ᐉ Резистори smd YAGEO RC0603FR-071KL купити в Києві • IMRAD - український інтернет-магазин радіодеталей | 200 | так | відкрити (https://imrad.com.ua/ua/rc0603fr-071kl-3) | 2026-10-25
28 | R307, R502, R503, R510 | 1 кОм, 0603, 1 % | резерв | Mini-Tech | книга резисторів 0603 власника (аркуш «Набори») | еквівалент | з набору | В наявності | 825.00 грн | Набір SMD резисторів у книзі 0603 170 типів 0,125 Вт 1% | 200 | так | відкрити (https://www.mini-tech.com.ua/ua/nabor-smd-rezistorov-0603-170) | 2026-10-25
28 | R307, R502, R503, R510 | 1 кОм, 0603, 1 % | пошук | AliExpress | пошукова сторінка | пошук |  | пошукова сторінка (товари не перевіряються) |  | 0603 resistor 1K 1% - Buy 0603 resistor 1K 1% with free shipping on AliExpress | 200 | так | відкрити (https://www.aliexpress.com/w/wholesale-0603-resistor-1K-1%25.html) | 2026-10-25
29 | R504, R505 | 4.7 кОм, 0603, 1 % | обрано | IMRAD | Royal Ohm 0603SAF4701T5E (4.7 кОм 1 %; на сайті SMD0603-4K7-1%), упаковка 100 шт | точний MPN | в наявності | В наявності |  | ᐉ Резистори smd ROYAL OHM SMD0603-4K7-1% купити в Києві • IMRAD - український інтернет-магазин радіодеталей | 200 | так | відкрити (https://imrad.com.ua/ua/smd0603-4k7-1--2) | 2026-10-25
29 | R504, R505 | 4.7 кОм, 0603, 1 % | резерв | Mini-Tech | книга резисторів 0603 власника (аркуш «Набори») | еквівалент | з набору | В наявності | 825.00 грн | Набір SMD резисторів у книзі 0603 170 типів 0,125 Вт 1% | 200 | так | відкрити (https://www.mini-tech.com.ua/ua/nabor-smd-rezistorov-0603-170) | 2026-10-25
29 | R504, R505 | 4.7 кОм, 0603, 1 % | пошук | AliExpress | пошукова сторінка | пошук |  | пошукова сторінка (товари не перевіряються) |  | 0603 resistor 4.7K 1% - Buy 0603 resistor 4.7K 1% with free shipping on AliExpress | 200 | так | відкрити (https://www.aliexpress.com/w/wholesale-0603-resistor-4.7K-1%25.html) | 2026-10-25
30 | R506, R508, R509 | 100 кОм, 0603, 1 % | обрано | IMRAD | Yageo AC0603FR-07100KL (100 кОм 1 %), упаковка 100 шт | точний MPN | в наявності | В наявності |  | ᐉ Резистори smd YAGEO AC0603FR-07100KL купити в Києві • IMRAD - український інтернет-магазин радіодеталей | 200 | так | відкрити (https://imrad.com.ua/ua/ac0603fr-07100kl-5) | 2026-10-25
30 | R506, R508, R509 | 100 кОм, 0603, 1 % | резерв | Mini-Tech | книга резисторів 0603 власника (аркуш «Набори») | еквівалент | з набору | В наявності | 825.00 грн | Набір SMD резисторів у книзі 0603 170 типів 0,125 Вт 1% | 200 | так | відкрити (https://www.mini-tech.com.ua/ua/nabor-smd-rezistorov-0603-170) | 2026-10-25
30 | R506, R508, R509 | 100 кОм, 0603, 1 % | пошук | AliExpress | пошукова сторінка | пошук |  | пошукова сторінка (товари не перевіряються) |  | 0603 resistor 100K 1% - Buy 0603 resistor 100K 1% with free shipping on AliExpress | 200 | так | відкрити (https://www.aliexpress.com/w/wholesale-0603-resistor-100K-1%25.html) | 2026-10-25
31 | R511 | Лише 4.7 Ом 2512 1 Вт товстоплівковий з перевантаженням 2.5 x Ur протягом 5 с (Yageo RC2512JK-074R7L): 1206-резистори на цей футпринт не стають | обрано | IMRAD | Yageo RC2512JK-074R7L (4.7 Ом 5 % 2512 1 Вт, точний MPN) | точний MPN | в наявності | В наявності | 1 1,58 грн/шт 1,34 грн/шт - від 10 1,04 грн/шт - від 100 0,95 грн/шт - від 500 | ᐉ Резистори smd YAGEO RC2512JK-074R7L купити в Києві • IMRAD - український інтернет-магазин радіодеталей | 200 | так | відкрити (https://imrad.com.ua/ua/rc2512jk-074r7l-2) | 2026-10-25
31 | R511 | Лише 4.7 Ом 2512 1 Вт товстоплівковий з перевантаженням 2.5 x Ur протягом 5 с (Yageo RC2512JK-074R7L): 1206-резистори на цей футпринт не стають | резерв | Космодром | Yageo RC2512JK-074R7L (точний MPN), партнерський склад | точний MPN | під замовлення | 4 - 6 тижнів (YAGEO) | 10+: 7.51 грн без ПДВ | Результаты пошуку за запитом RC2512JK-074R7L Космодром | 200 | так | відкрити (https://kosmodrom.ua/tsq-search?q=RC2512JK-074R7L) | 2026-10-25
31 | R511 | Лише 4.7 Ом 2512 1 Вт товстоплівковий з перевантаженням 2.5 x Ur протягом 5 с (Yageo RC2512JK-074R7L): 1206-резистори на цей футпринт не стають | пошук | AliExpress | пошукова сторінка | пошук |  | пошукова сторінка (товари не перевіряються) |  | RC2512JK 074R7L 4.7R 2512 - Buy RC2512JK 074R7L 4.7R 2512 with free shipping on AliExpress | 200 | так | відкрити (https://www.aliexpress.com/w/wholesale-RC2512JK-074R7L-4.7R-2512.html) | 2026-10-25
32 | R512 | 10 кОм, 1206, 1 %, >= 0.25 Вт: Royal Ohm 1206S4F1002T5E (друге джерело Yageo RC1206FR-0710KL) | обрано | IMRAD | Royal Ohm 1206S4F1002T5E (10 кОм 1 % 1206), упаковка 100 шт | точний MPN | в наявності | В наявності |  | ᐉ Резистори smd ROYAL OHM 1206S4F1002T5E купити в Києві • IMRAD - український інтернет-магазин радіодеталей | 200 | так | відкрити (https://imrad.com.ua/ua/1206s4f1002t5e-3) | 2026-10-25
32 | R512 | 10 кОм, 1206, 1 %, >= 0.25 Вт: Royal Ohm 1206S4F1002T5E (друге джерело Yageo RC1206FR-0710KL) | резерв | Космодром | Yageo 10 кОм 1 % 1206 0.25 Вт | еквівалент | в наявності | Є НА СКЛАДІ, МОЖНА КУПИТИ; на складі 23300 шт (склад) | 100+: 0.69 грн без ПДВ; 1000+: 0.55 грн без ПДВ; 5000+: 0.35 грн без ПДВ | Купити SMD-резистор (1206) 10 kom ±1% (точні) SMD-резистор на складі КОСМОДРОМ, Харків, Україна | 200 | так | відкрити (https://kosmodrom.ua/smd-rezistor-2513/smd-rezistor-1206-10-kom-1-tochni.html) | 2026-10-25
32 | R512 | 10 кОм, 1206, 1 %, >= 0.25 Вт: Royal Ohm 1206S4F1002T5E (друге джерело Yageo RC1206FR-0710KL) | пошук | AliExpress | пошукова сторінка | пошук |  | пошукова сторінка (товари не перевіряються) |  | 1206 resistor 10K 1% - Buy 1206 resistor 10K 1% with free shipping on AliExpress | 200 | так | відкрити (https://www.aliexpress.com/w/wholesale-1206-resistor-10K-1%25.html) | 2026-10-25
34 | U101 | LMR38010 у PFM-варіанті: LMR38010SQDDARQ1 (AEC-Q100 версія того самого кристала, той самий корпус) або LMR38010SDDAR. FDDAR / FSDDAR (примусовий PWM) НЕ купувати | обрано | VD MAIS | TI LMR38010SQDDARQ1 (Q1-версія LMR38010SDDAR), Digi-Key через VD MAIS | еквівалент | під замовлення |  |  | Пошук по каталогу VD MAIS: LMR38010SQDDARQ1 | 200 | так | відкрити (https://catalog.vdmais.ua/uk/parasearch/?keyword=LMR38010SQDDARQ1) | 2026-10-25
34 | U101 | LMR38010 у PFM-варіанті: LMR38010SQDDARQ1 (AEC-Q100 версія того самого кристала, той самий корпус) або LMR38010SDDAR. FDDAR / FSDDAR (примусовий PWM) НЕ купувати | резерв | Космодром | TI LMR38010SDDAR (точний MPN KiCad), партнерський склад | точний MPN | під замовлення | 4 - 6 тижнів (TI) | 1+: 84.59 грн без ПДВ | Результаты пошуку за запитом LMR38010SDDAR Космодром | 200 | так | відкрити (https://kosmodrom.ua/tsq-search?q=LMR38010SDDAR) | 2026-10-25
34 | U101 | LMR38010 у PFM-варіанті: LMR38010SQDDARQ1 (AEC-Q100 версія того самого кристала, той самий корпус) або LMR38010SDDAR. FDDAR / FSDDAR (примусовий PWM) НЕ купувати | пошук | AliExpress | пошукова сторінка | пошук |  | пошукова сторінка (товари не перевіряються) |  | LMR38010SDDAR - Buy LMR38010SDDAR with free shipping on AliExpress | 200 | так | відкрити (https://www.aliexpress.com/w/wholesale-LMR38010SDDAR.html) | 2026-10-25
35 | U201 | ESP32-S3-WROOM-1-N16R8 (або -N16 / -N8, той самий футпринт). Перед пайкою: маркування, MSL3 – просушити | резерв | IMRAD | Espressif ESP32-S3-WROOM-1-N16R8 (точний MPN) | точний MPN | в наявності | В наявності | 1 480,56 грн/шт 451,73 грн/шт - від 2 432,51 грн/шт - від 4 418,09 грн/шт - від 10 | ᐉ Bluetooth прийомо-передавач ESPRESIF ESP32-S3-WROOM-1-N16R8 купити в Києві • IMRAD - український інтернет-магазин радіодеталей | 200 | так | відкрити (https://imrad.com.ua/ua/esp32-s3-wroom-1-n16r8-8) | 2026-10-25
35 | U201 | ESP32-S3-WROOM-1-N16R8 (або -N16 / -N8, той самий футпринт). Перед пайкою: маркування, MSL3 – просушити | пошук | AliExpress | пошукова сторінка | пошук |  | пошукова сторінка (товари не перевіряються) |  | ESP32 S3 WROOM 1 N16R8 - Buy ESP32 S3 WROOM 1 N16R8 with free shipping on AliExpress | 200 | так | відкрити (https://www.aliexpress.com/w/wholesale-ESP32-S3-WROOM-1-N16R8.html) | 2026-10-25
36 | U202 | Лише TPS3808G33DBVR. MAX809T (IMRAD) потребує зміни кола скидання: лише rev-b. Може лишитися з rev-c (див. «Вже є») | обрано | VD MAIS | TI TPS3808G33DBVR (точний MPN) | точний MPN | в наявності | Є на складі 227 шт Строк 0 тижн. Всього доступно 227 шт | від 1 84.42 грн від 25 78.79 грн від 100 73.16 грн | TPS3808G33DBV - Замовити на VD MAIS | 200 | так | відкрити (https://catalog.vdmais.ua/uk/product/tps3808g33dbvr/1716171/) | 2026-10-25
36 | U202 | Лише TPS3808G33DBVR. MAX809T (IMRAD) потребує зміни кола скидання: лише rev-b. Може лишитися з rev-c (див. «Вже є») | резерв | IMRAD | TI TPS3808G33DBVR (точний MPN) | точний MPN | під замовлення | Доступний під | 1 109,23 грн/шт 66,35 грн/шт - від 14 63,11 грн/шт - від 33 62,30 грн/шт - від 250 | ᐉ Формувачі імпульсу скидання і супервізори Texas Instruments TPS3808G33DBVR купити в Києві • IMRAD - український інтернет-магазин радіодеталей | 200 | так | відкрити (https://imrad.com.ua/ua/tps3808g33dbvr-4) | 2026-10-25
36 | U202 | Лише TPS3808G33DBVR. MAX809T (IMRAD) потребує зміни кола скидання: лише rev-b. Може лишитися з rev-c (див. «Вже є») | пошук | AliExpress | пошукова сторінка | пошук |  | пошукова сторінка (товари не перевіряються) |  | TPS3808G33DBVR - Buy TPS3808G33DBVR with free shipping on AliExpress | 200 | так | відкрити (https://www.aliexpress.com/w/wholesale-TPS3808G33DBVR.html) | 2026-10-25
37 | U203 | Лише ST USBLC6-2SC6 (клони UMW/TECH PUBLIC мають іншу напругу обмеження). Може лишитися з rev-c | обрано | IMRAD | ST USBLC6-2SC6 (точний MPN) | точний MPN | в наявності | В наявності | 1 11,50 грн/шт 10,84 грн/шт - від 10 10,38 грн/шт - від 35 | ᐉ Захисна ІС ST MICROELECTRONICS USBLC6-2SC6 купити в Києві • IMRAD - український інтернет-магазин радіодеталей | 200 | так | відкрити (https://imrad.com.ua/ua/usblc6-2sc6-4) | 2026-10-25
37 | U203 | Лише ST USBLC6-2SC6 (клони UMW/TECH PUBLIC мають іншу напругу обмеження). Може лишитися з rev-c | резерв | Космодром | ST USBLC6-2SC6 (точний MPN) | точний MPN | в наявності | Є НА СКЛАДІ, МОЖНА КУПИТИ; на складі 61 шт (склад) | 1+: 7.50 грн без ПДВ; 74+: 6.71 грн без ПДВ; 330+: 6.06 грн без ПДВ | Купити USBLC6-2SC6 Захисний діод (супресор) на складі КОСМОДРОМ, Харків, Україна | 200 | так | відкрити (https://kosmodrom.ua/zahisniy-diod-supresor/usblc6-2sc6.html) | 2026-10-25
37 | U203 | Лише ST USBLC6-2SC6 (клони UMW/TECH PUBLIC мають іншу напругу обмеження). Може лишитися з rev-c | пошук | AliExpress | пошукова сторінка | пошук |  | пошукова сторінка (товари не перевіряються) |  | USBLC6 2SC6 - Buy USBLC6 2SC6 with free shipping on AliExpress | 200 | так | відкрити (https://www.aliexpress.com/w/wholesale-USBLC6-2SC6.html) | 2026-10-25
38 | U301 | Лише ADS1115IDGSR (VSSOP-10). Модулі-плати ADS1115 не підходять | обрано | VD MAIS | TI ADS1115IDGSR: 4 шт власний склад VD MAIS + 2 шт Digi-Key через VD MAIS | точний MPN | в наявності | Є на складі 4 шт Строк 0 тижн. Всього доступно 4 шт | від 1 198.23 грн від 10 183.54 грн від 100 168.86 грн | ADS1115IDG - Замовити на VD MAIS | 200 | так | відкрити (https://catalog.vdmais.ua/uk/product/ads1115idgsr/1745986/) | 2026-10-25
38 | U301 | Лише ADS1115IDGSR (VSSOP-10). Модулі-плати ADS1115 не підходять | резерв | IMRAD | TI ADS1115IDGSR (точний MPN) | точний MPN | під замовлення | Доступний під | 1 346,29 грн/шт 217,65 грн/шт - від 5 205,51 грн/шт - від 10 | ᐉ АЦП Texas Instruments ADS1115IDGSR купити в Києві • IMRAD - український інтернет-магазин радіодеталей | 200 | так | відкрити (https://imrad.com.ua/ua/ads1115idgsr-3) | 2026-10-25
38 | U301 | Лише ADS1115IDGSR (VSSOP-10). Модулі-плати ADS1115 не підходять | додатково | Космодром | TI ADS1115IDGSR (точний MPN), партнерський склад | точний MPN | під замовлення | тимчасово немає на складі, очікується (TI) | 4 - 6 тижнів (TI) | 1+: 98.50 грн без ПДВ | 1+: 141.21 грн без ПДВ | Результаты пошуку за запитом ADS1115IDGSR Космодром | 200 | так | відкрити (https://kosmodrom.ua/tsq-search?q=ADS1115IDGSR) | 2026-10-25
38 | U301 | Лише ADS1115IDGSR (VSSOP-10). Модулі-плати ADS1115 не підходять | пошук | AliExpress | пошукова сторінка | пошук |  | пошукова сторінка (товари не перевіряються) |  | ADS1115IDGSR - Buy ADS1115IDGSR with free shipping on AliExpress | 200 | так | відкрити (https://www.aliexpress.com/w/wholesale-ADS1115IDGSR.html) | 2026-10-25
39 | U401 | Ai-Thinker Ra-02, 433 МГц, з роз'ємом IPEX (не Ra-01, не 868/915 МГц) | резерв | Prom.ua - продавець Ra-02 | Ai-Thinker Ra-02 SX1278 433 МГц | точний MPN | в наявності |  |  | Ai-Thinker 433 МГц 15км трансивер дальньої дії SX1278 LoRa Ra02, ціна 230 ₴: купити на Prom.ua | Україна | 200 | так | відкрити (https://prom.ua/ua/p3212257815-thinker-433-mgts.html) | 2026-10-25
39 | U401 | Ai-Thinker Ra-02, 433 МГц, з роз'ємом IPEX (не Ra-01, не 868/915 МГц) | пошук | AliExpress | пошукова сторінка | пошук |  | пошукова сторінка (товари не перевіряються) |  | Ai Thinker Ra 02 SX1278 433MHz - Buy Ai Thinker Ra 02 SX1278 433MHz with free shipping on AliExpress | 200 | так | відкрити (https://www.aliexpress.com/w/wholesale-Ai-Thinker-Ra-02-SX1278-433MHz.html) | 2026-10-25
Набори | книга | Книга SMD резисторів 0603: 170 номіналів x 50 шт, 1 %, 0R-10M (ряд E24) | набір | Mini-Tech | Набір SMD резисторів у книзі 0603 170 типів 0,125 Вт 1 % | набір | в наявності | В наявності | 825.00 грн | Набір SMD резисторів у книзі 0603 170 типів 0,125 Вт 1% | 200 | так | відкрити (https://www.mini-tech.com.ua/ua/nabor-smd-rezistorov-0603-170) | 2026-10-25
Поза платою П1 | J503 (кабель модуля в корпусі) | Модуль LED-вольтметра 0.28", 3 дроти, DC 0-100 В | обрано | Prom.ua - DIY mag | Панельний LED вольтметр 0.28" 0-100V DC, 3-провідний | аналог | в наявності | Готово до відправки |  | Панельний LED вольтметр 0.28" 0 100V DC, 3-провідний, міні, ціна 50 ₴: купити на Prom.ua | Україна | 200 | так | відкрити (https://prom.ua/ua/p2882297154-panelnyj-led-voltmetr.html) | 2026-10-25
Поза платою П1 | J503 (кабель модуля в корпусі) | Модуль LED-вольтметра 0.28", 3 дроти, DC 0-100 В | резерв | Prom.ua - RADIOFORMAT | Вольтметр цифровий DC 0-100 В, 0.28", червоний, трипровідний | аналог | в наявності | Готово до відправки |  | Вольтметр цифровий DC 0 100 В, LED-індикатор 0,28 , червоний, трипровідний, ціна 49 ₴: купити на Prom.ua | Україна, Дніпро | 200 | так | відкрити (https://prom.ua/ua/p1469578947-voltmetr-tsifrovoj-100.html) | 2026-10-25
Поза платою П2 | J503 B3B-XH-A | Корпус роз'єму JST XHP-3 (відповідь до J503) | обрано | IMRAD | JST XHP-3 | точний MPN | в наявності | В наявності | 1 2,16 грн/шт 1,86 грн/шт - від 10 1,77 грн/шт - від 50 1,64 грн/шт - від 290 | ᐉ Роз'єми сигнальні растр 2,50мм JST XHP-3 купити в Києві • IMRAD - український інтернет-магазин радіодеталей | 200 | так | відкрити (https://imrad.com.ua/ua/xhp-3-3) | 2026-10-25
Поза платою П3 | J504 B2B-XH-A | Корпус роз'єму JST XHP-2 (відповідь до J504) | обрано | IMRAD | JST XHP-2 | точний MPN | в наявності | В наявності | 1 1,72 грн/шт 1,48 грн/шт - від 10 1,41 грн/шт - від 50 | ᐉ Роз'єми сигнальні растр 2,50мм JST XHP-2 купити в Києві • IMRAD - український інтернет-магазин радіодеталей | 200 | так | відкрити (https://imrad.com.ua/ua/xhp-2-3) | 2026-10-25
Поза платою П4 | XHP-3 (3 шт) + XHP-2 (2 шт) | Контакт обтискний JST SXH-001T-P0.6 (22-28 AWG) | обрано | Космодром | JST SXH-001T-P0.6 (точний MPN) | точний MPN | в наявності | Є НА СКЛАДІ, МОЖНА КУПИТИ; на складі 2499 шт (склад) | 1+: 2.00 грн без ПДВ; 293+: 1.88 грн без ПДВ; 1216+: 1.81 грн без ПДВ | Купити SXH-001T-P0.6 Роз'єм NS25 - 2,54 мм на складі КОСМОДРОМ, Харків, Україна | 200 | так | відкрити (https://kosmodrom.ua/roz-39-yem-ns25-2-54-mm/sxh-001t-p0-6-2.html) | 2026-10-25
Поза платою П4 | XHP-3 (3 шт) + XHP-2 (2 шт) | Контакт обтискний JST SXH-001T-P0.6 (22-28 AWG) | резерв | РКС Компоненти | JST SXH-001T-P0.6 (для XHP) | точний MPN | в наявності | у наявності: 1 шт 1 шт - РАДІОМАГ-Харків | 1+ 20.00 грн 10+ 2.00 грн 100+ 1.20 грн купити В кошику од. на суму грн. SXH-001T-P0.6 Виробник : JST Category: Raster signal connectors 2,50mm Description: Con | SXH-001T-P0.6 купити - РКС Компоненти - РАДІОМАГ | 200 | так | відкрити (https://www.rcscomponents.kiev.ua/search?q=SXH-001T-P0.6) | 2026-10-25
Поза платою П5 | H1-H4 (отвори 3.2 мм) | Стійка нейлонова M3, внутрішня-внутрішня різьба, 10 мм | обрано | Космодром | PLFF-M3-10 (Nylon 66, M3, 10 мм, F-F) | аналог | в наявності | Є НА СКЛАДІ, МОЖНА КУПИТИ; на складі 40597 шт (склад) | 1+: 3.50 грн без ПДВ; 210+: 2.38 грн без ПДВ; 911+: 2.20 грн без ПДВ | Купити PLFF-M3-10 Міжплатний стійки пластикові на складі КОСМОДРОМ, Харків, Україна | 200 | так | відкрити (https://kosmodrom.ua/mizhplatni-stiyki-plastikovi/plff-m3-10.html) | 2026-10-25
Поза платою П5 | H1-H4 (отвори 3.2 мм) | Стійка нейлонова M3, внутрішня-внутрішня різьба, 10 мм | резерв | РКС Компоненти | KLS8-0214-M3-10 (нейлонова M3/M3, 10 мм, внутрішня/зовнішня різьба) | аналог | під замовлення | очікується: 15000 шт 15000 шт - очікується на замовлення: 150 шт 150 шт - термін постачання 7-21 дні (днів) | 5+ 4.00 грн 10+ 3.20 грн 100+ 2.60 грн 1000+ 2.30 грн; мінімум 5 шт | KLS8-0214-M3-10 купити - РКС Компоненти - РАДІОМАГ | 200 | так | відкрити (https://www.rcscomponents.kiev.ua/search?q=KLS8-0214-M3-10) | 2026-10-25
Поза платою П6 | H1-H4: плата - стійка (4) і стійка - корпус (4) | Гвинт пластиковий M3x6, напівкругла головка 5.5 мм | обрано | РКС Компоненти | KLS8-0318-PF-M3-06 (пластиковий M3x6, головка 5.5 мм) | аналог | в наявності | у наявності: 103 шт 98 шт - РАДІОМАГ-Львів 5 шт - РАДІОМАГ-Харків очікується: 20000 шт 20000 шт - очікується | 10+ 2.00 грн 14+ 1.50 грн 100+ 1.30 грн 1000+ 1.10 грн; мінімум 10 шт | Гвинт М3 пластиковий KLS8-0318-PF-M3-06 (head type A) за ціною від 1.10 грн - РКС Компоненти - РАДІОМАГ | 200 | так | відкрити (https://www.rcscomponents.kiev.ua/product/hvynt-m3-plastykovyi-kls8-0318-pf-m3-06-head-type-a_158561.html) | 2026-10-25
Поза платою П6 | H1-H4: плата - стійка (4) і стійка - корпус (4) | Гвинт пластиковий M3x6, напівкругла головка 5.5 мм | резерв | Космодром | Гвинт пластиковий, полукругла головка під крест M3*6 (упаковка 100 шт) | аналог | в наявності | Є НА СКЛАДІ, МОЖНА КУПИТИ; на складі 10 шт (склад) | 1+: 186.00 грн без ПДВ; 3+: 169.26 грн без ПДВ; 13+: 152.88 грн без ПДВ | Купити Гвинт пластиковий, полукругла головка під крест M3*6 (100pcs) Гвинт кріпильний на складі КОСМОДРОМ, Харків, Україна | 200 | так | відкрити (https://kosmodrom.ua/gvint-kripilniy/gvint-plastikoviy-polukrugla-golovka-pid-krest-m3-6-100pcs-2.html) | 2026-10-25
Поза платою П7 | H1-H4 під головку гвинта; обов'язково біля H3 (F101.2 за 4.45 мм) | Шайба пластикова M3, зовн. 6 мм, 1.5 мм | обрано | РКС Компоненти | KangYang WS3-1.5 (пластик, 6 x 3.1 x 1.5 мм) | аналог | в наявності |  | 14+ 1.50 грн 17+ 1.20 грн 100+ 1.00 грн; мінімум 14 шт | Шайба WS3-1.5 KangYang за ціною від 1.00 грн - РКС Компоненти - РАДІОМАГ | 200 | так | відкрити (https://www.rcscomponents.kiev.ua/product/shaiba-ws3-1-5_198596.html) | 2026-10-25
Поза платою П7 | H1-H4 під головку гвинта; обов'язково біля H3 (F101.2 за 4.45 мм) | Шайба пластикова M3, зовн. 6 мм, 1.5 мм | резерв | Космодром | Plastic Nylon Flat Washer M3x7x1mm White | аналог | в наявності | Є НА СКЛАДІ, МОЖНА КУПИТИ; на складі 3800 шт (склад) | 100+: 1.40 грн без ПДВ; 1000+: 1.12 грн без ПДВ; 5000+: 0.70 грн без ПДВ | Купити Plastic Nylon Flat Washer M3x7x1mm White Шайба на складі КОСМОДРОМ, Харків, Україна | 200 | так | відкрити (https://kosmodrom.ua/shayba-2/plastic-nylon-flat-washer-m3x7x1mm-white-2.html) | 2026-10-25
Поза платою П8 | провід батареї «+», не далі 0.2 м від затискача (C-01) | Тримач автомобільного запобіжника MINI (ATM) з кабелем | обрано | Prom.ua - Connectors | Тримач автомобільного запобіжника міні з кабелем (вологозахисний, з кришкою) | аналог | в наявності | Готово до відправки |  | Тримач автомобільного запобіжника міні з кабелем, ціна 40 ₴: купити на Prom.ua | Україна | 200 | так | відкрити (https://prom.ua/ua/p2254860639-derzhatel-avtomobilnogo-predohranitelya.html) | 2026-10-25
Поза платою П8 | провід батареї «+», не далі 0.2 м від затискача (C-01) | Тримач автомобільного запобіжника MINI (ATM) з кабелем | резерв | Prom.ua - RadioShopUA | Тримач запобіжника mini П-образного з кабелем | аналог | в наявності | В наявності |  | Тримач запобіжника mini П - образного з кабелем, ціна 36 ₴: купити на Prom.ua | Україна, Київ | 200 | так | відкрити (https://prom.ua/ua/p3200661263-trimach-zapobizhnika-mini.html) | 2026-10-25
Поза платою П9 | у тримач на проводі «+» батареї (C-01); F101 на платі - лише вторинний захист | Запобіжник автомобільний MINI 2 А, 32 В DC | обрано | РКС Компоненти | MTA MINIVAL 2A (AMFM-2A) | аналог | в наявності | у наявності: 57 шт 57 шт - РАДІОМАГ-Львів | 2+ 10.00 грн 10+ 5.00 грн 100+ 3.00 грн 1000+ 2.00 грн; мінімум 2 шт | Запобіжник автомобільний MINIVAL 2A (AMFM-2A) MTA за ціною від 2.00 грн - РКС Компоненти - РАДІОМАГ | 200 | так | відкрити (https://www.rcscomponents.kiev.ua/product/zapobizhnyk-avtomobilnyi-minival-2a-amfm-2a_168879.html) | 2026-10-25
Поза платою П9 | у тримач на проводі «+» батареї (C-01); F101 на платі - лише вторинний захист | Запобіжник автомобільний MINI 2 А, 32 В DC | резерв | Prom.ua - Doodah | Yiyue FN Mini 2A 32V, 10 шт | аналог | в наявності | В наявності |  | Запобіжник Yiyue FN Mini 2A 32V, 10 шт, ціна 54 ₴: купити на Prom.ua | Україна, Київ | 200 | так | відкрити (https://prom.ua/ua/p2073082340-predohranitel-elektricheskij-plavkij.html) | 2026-10-25
Кожне посилання відкрито скриптом check_links.py 2026-10-25: HTTP-статус, заголовок сторінки, чи названо на сторінці потрібну деталь (MPN або назва товару), наявність і ціни - як показано. «Еквівалент» - той самий номінал, корпус і параметри іншого виробника; «аналог» - інша деталь, відмінність описано в примітці. Пошукові сторінки AliExpress: товари на них автоматично не перевіряються (капча).
