bogdan-kovalchuk/esp32-battery-charging-monitoring/hardware/battery-monitor-rev-a/3dmodels/Ra-02_C90039_easyeda.step

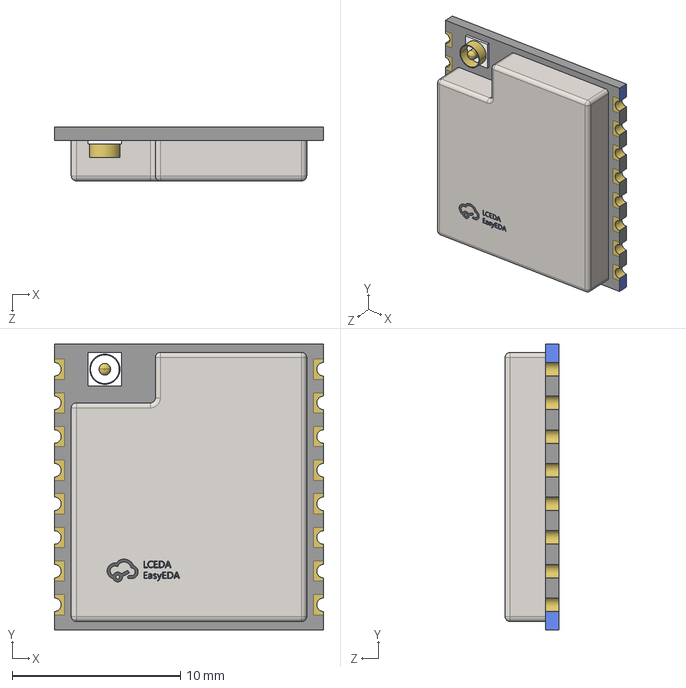
[picture p3: CAD file, 2026-10-18]
hardware/battery-monitor-rev-a/3dmodels/Ra-02_C90039_easyeda.step
16.0 x 17.0 x 3.20 mm
