bogdan-kovalchuk/esp32-battery-charging-monitoring/hardware/battery-monitor-rev-a/production/03-documentation/battery-monitor-rev-a.step

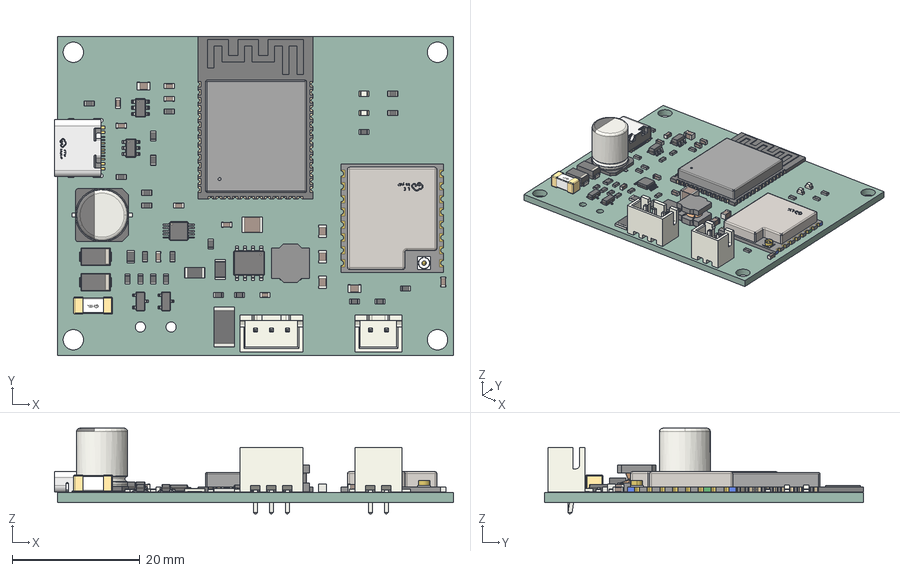
[picture p4: CAD file, 2026-10-22]
hardware/battery-monitor-rev-a/production/03-documentation/battery-monitor-rev-a.step
62.4 x 50.0 x 13.4 mm
R_0603_1608Metric x 22
JST_B2B_XH_A
FUSE-SMD_L6.1-W2.7-H2.7
R_1206_3216Metric
C_0805_2012Metric x 5
C_0603_1608Metric x 9
SOT-23-6 x 2
D_SMA x 2
R_0805_2012Metric
R_2512_6332Metric
USB-C_SMD-TYPE-C-31-M-12
TSSOP-10_3x3mm_P0.5mm
WIRELM-SMD_L17.0-W16.0-H3.2-RA-02
C_1210_3225Metric
JST_B3B_XH_A
L_Bourns_SRN6045TA
ESP32-S3-WROOM-1
LED_0603_1608Metric x 2
TI_SO-PowerPAD-8
SOT-23 x 2
Fuse_1206_3216Metric
CP_Elec_8x10
battery-monitor-rev-a_PCB
