bogdan-kovalchuk/esp32-battery-charging-monitoring/hardware/battery-monitor-rev-a/production/03-documentation/assembly-bottom.pdf

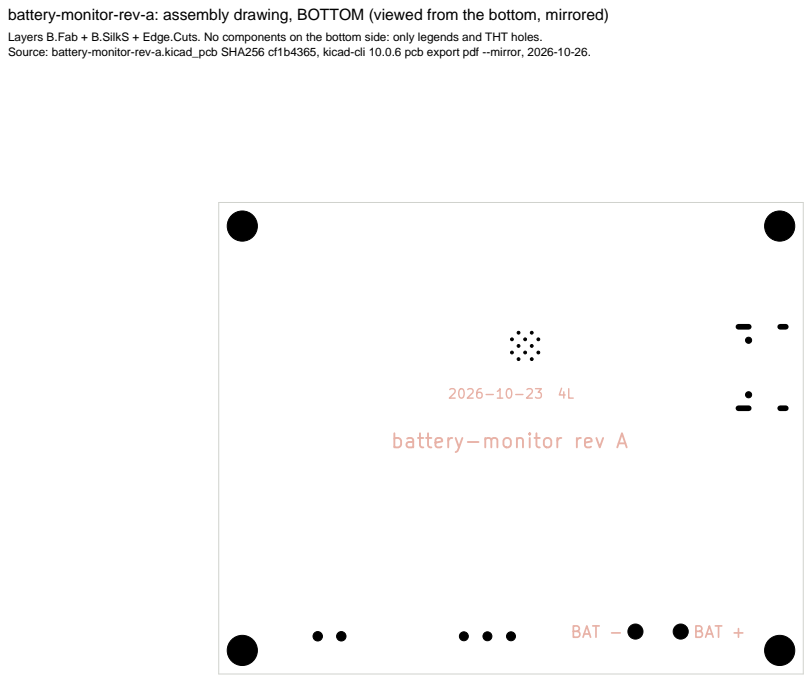
[picture p5: page 1]

battery-monitor-rev-a: assembly drawing, BOTTOM (viewed from the bottom, mirrored)
Layers B.Fab + B.SilkS + Edge.Cuts. No components on the bottom side: only legends and THT holes.
Source: battery-monitor-rev-a.kicad_pcb SHA256 cf1b4365, kicad-cli 10.0.6 pcb export pdf --mirror, 2026-10-26.
