bogdan-kovalchuk/esp32-battery-charging-monitoring/hardware/battery-monitor-rev-a/production/03-documentation/assembly-top.pdf

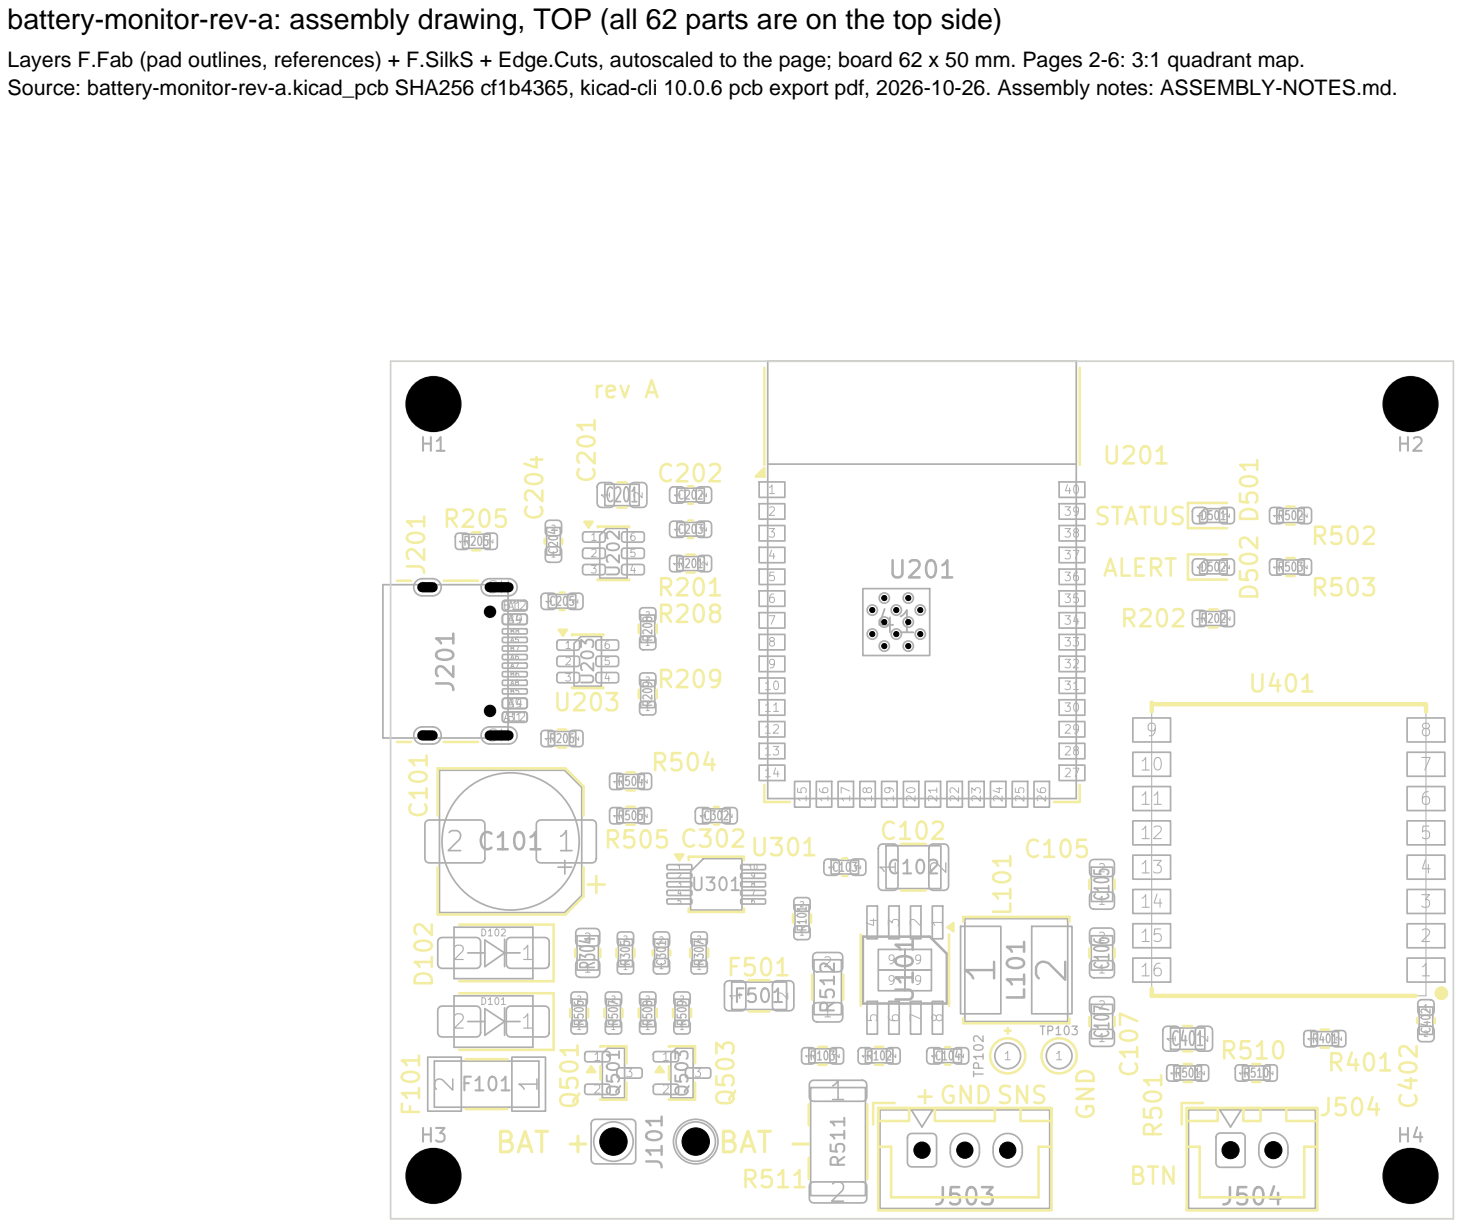
[picture p6: page 1]

battery-monitor-rev-a: assembly drawing, TOP (all 62 parts are on the top side)
Layers F.Fab (pad outlines, references) + F.SilkS + Edge.Cuts, autoscaled to the page; board 62 x 50 mm. Pages 2-6: 3:1 quadrant map.
Source: battery-monitor-rev-a.kicad_pcb SHA256 cf1b4365, kicad-cli 10.0.6 pcb export pdf, 2026-10-26. Assembly notes: ASSEMBLY-NOTES.md.

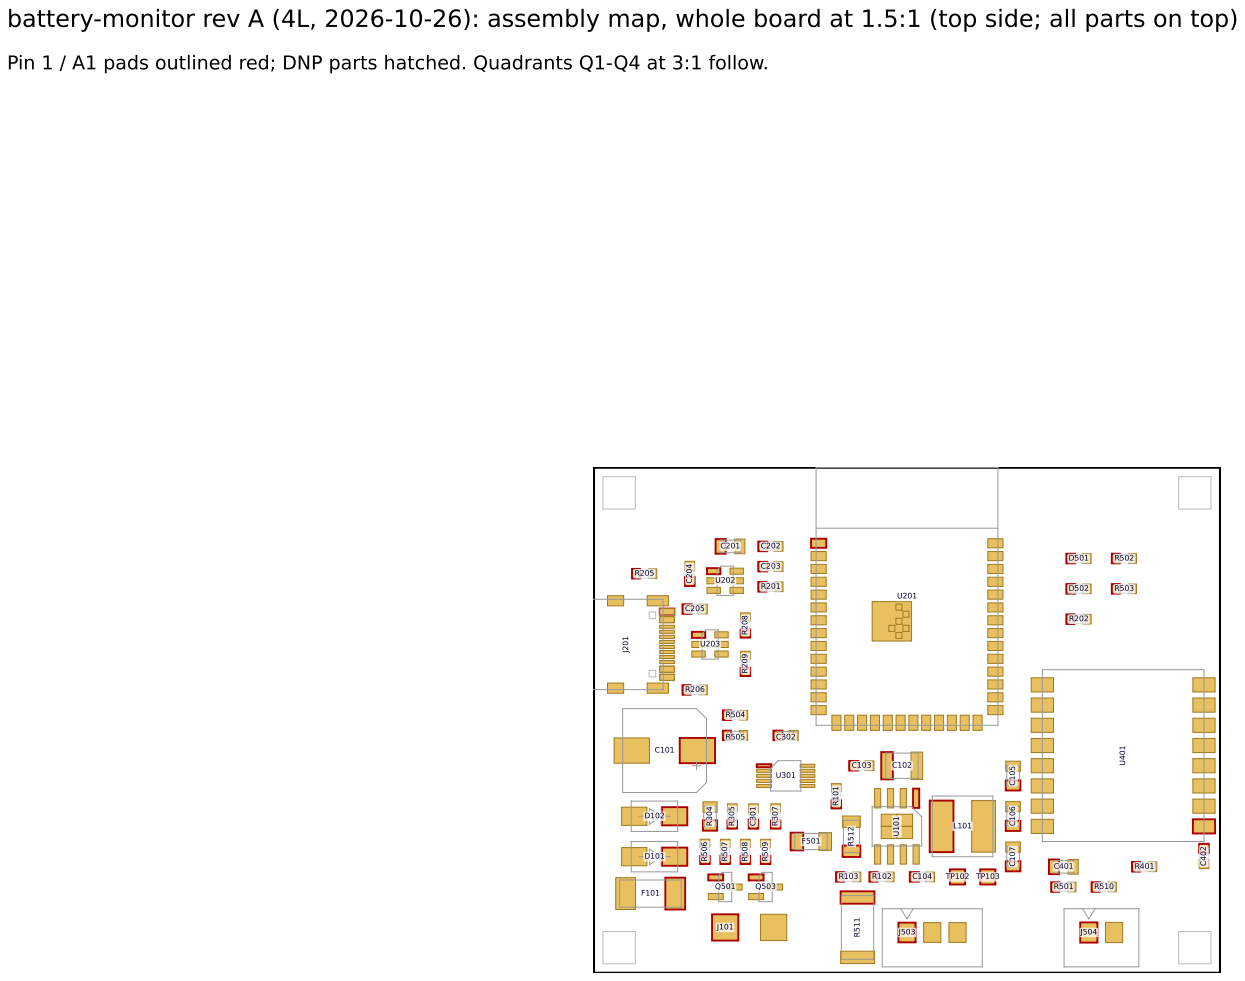
[picture p7: page 2]

battery-monitor rev A (4L, 2026-10-26): assembly map, whole board at 1.5:1 (top side; all parts on top)

Pin 1 / A1 pads outlined red; DNP parts hatched. Quadrants Q1-Q4 at 3:1 follow.

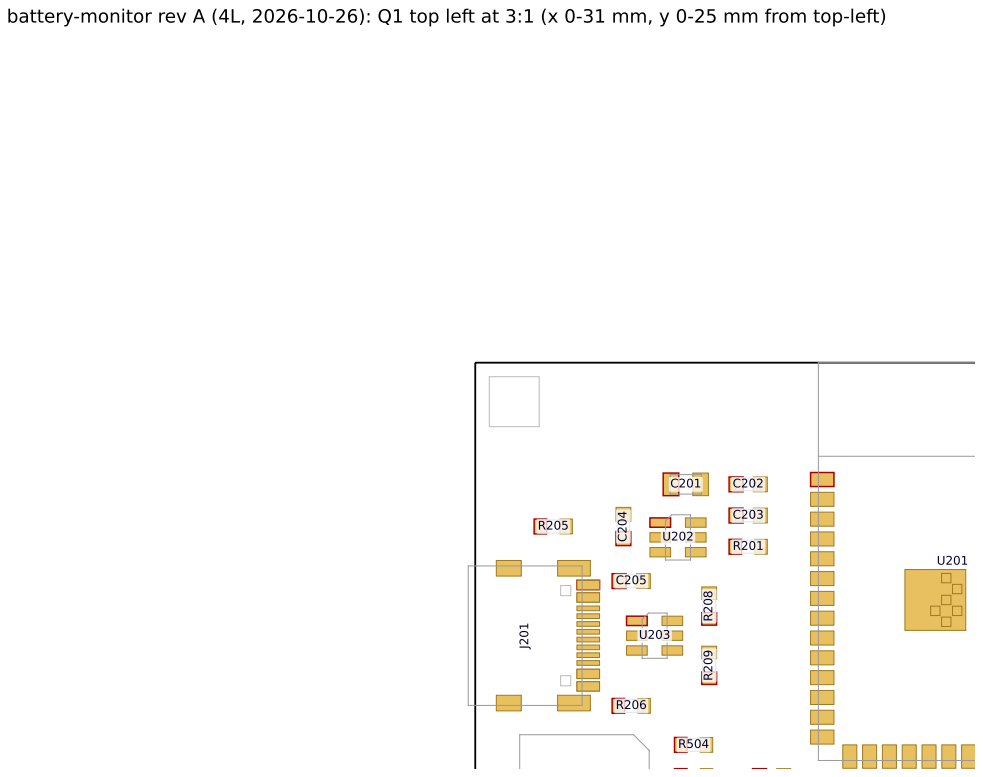
[picture p8: page 3]

battery-monitor rev A (4L, 2026-10-26): Q1 top left at 3:1 (x 0-31 mm, y 0-25 mm from top-left)

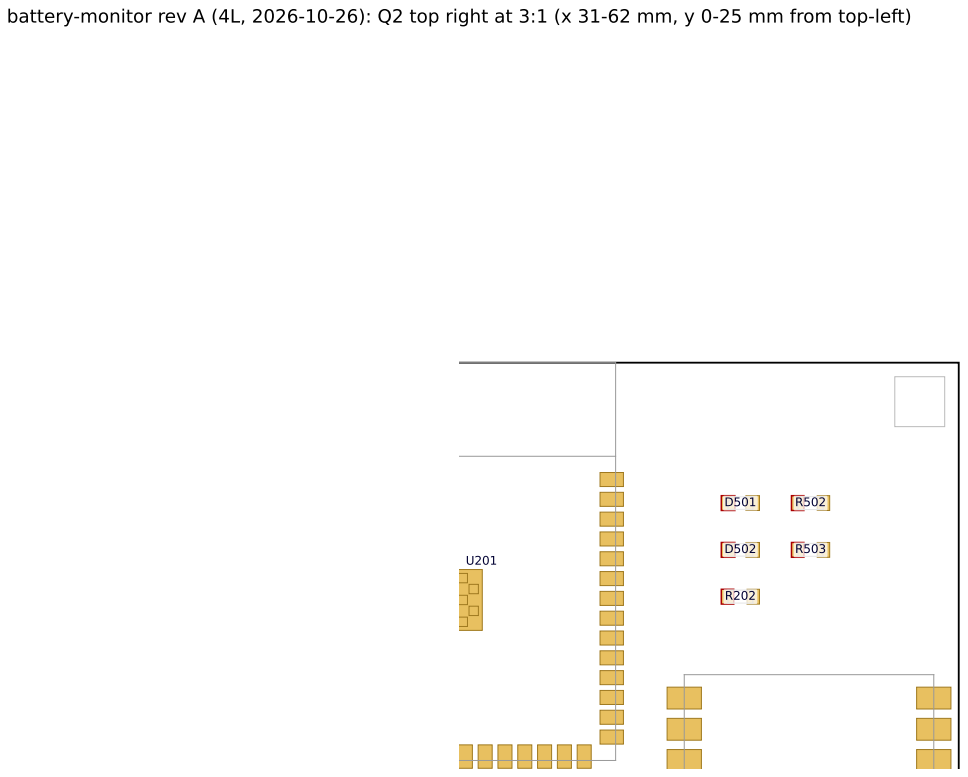
[picture p9: page 4]

battery-monitor rev A (4L, 2026-10-26): Q2 top right at 3:1 (x 31-62 mm, y 0-25 mm from top-left)

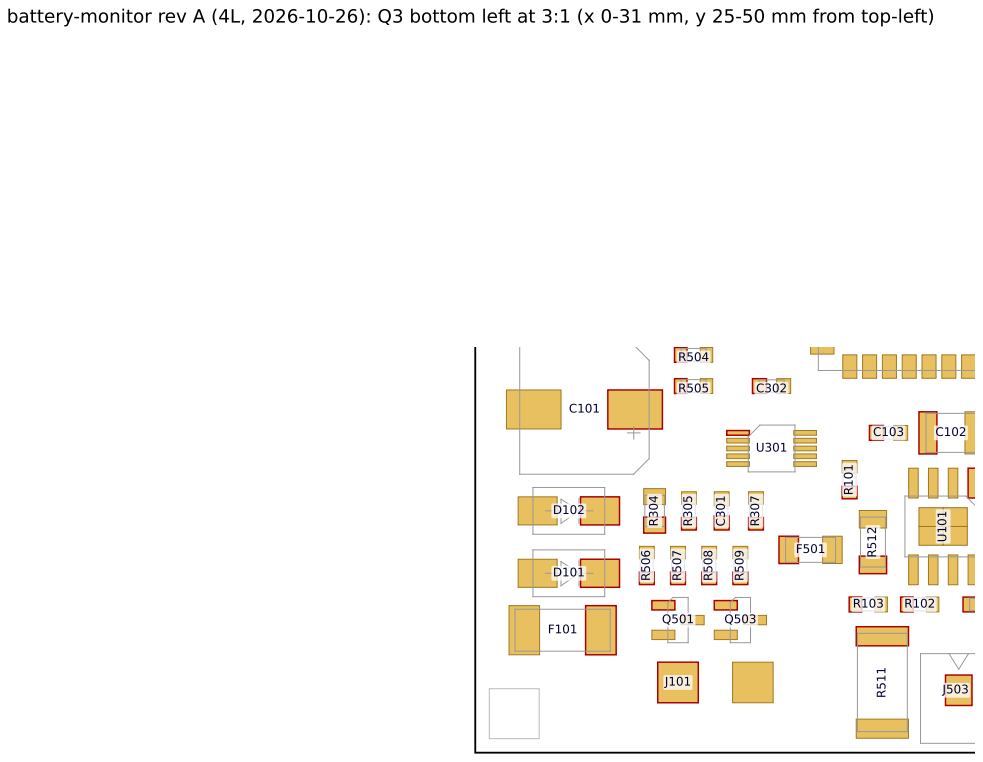
[picture p10: page 5]

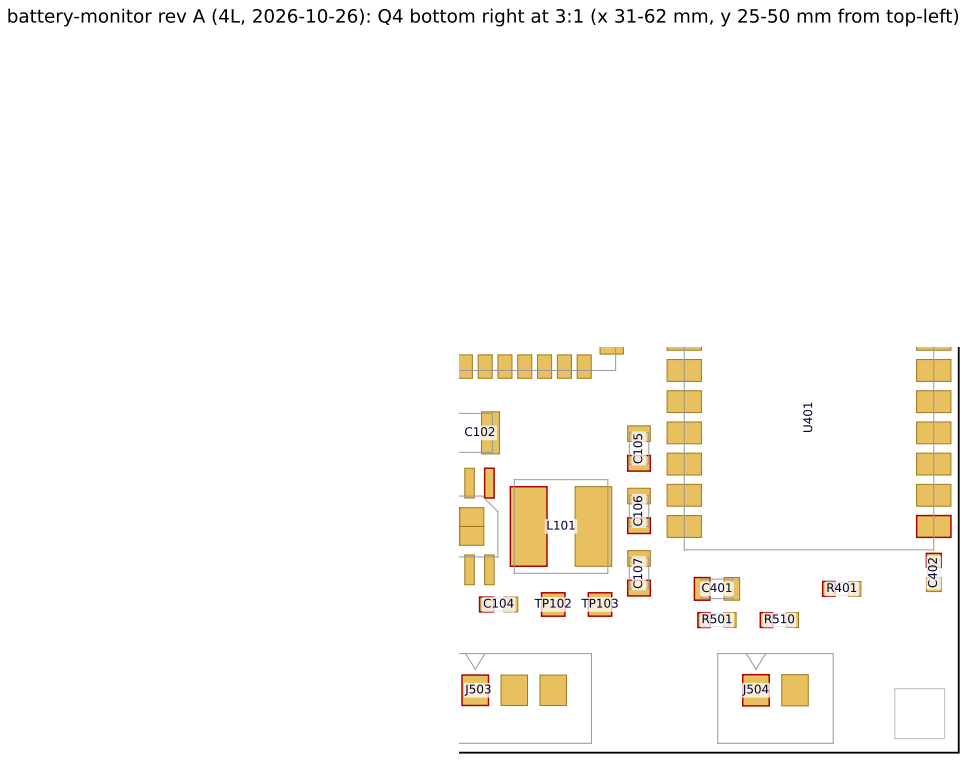
[picture p11: page 6]

battery-monitor rev A (4L, 2026-10-26): Q4 bottom right at 3:1 (x 31-62 mm, y 25-50 mm from top-left)
