bogdan-kovalchuk/esp32-battery-charging-monitoring/hardware/battery-monitor-rev-a/battery-monitor-rev-a.kicad_pcb

## KiCad design hardware/battery-monitor-rev-a/battery-monitor-rev-a.kicad_pcb (2026-10-18)

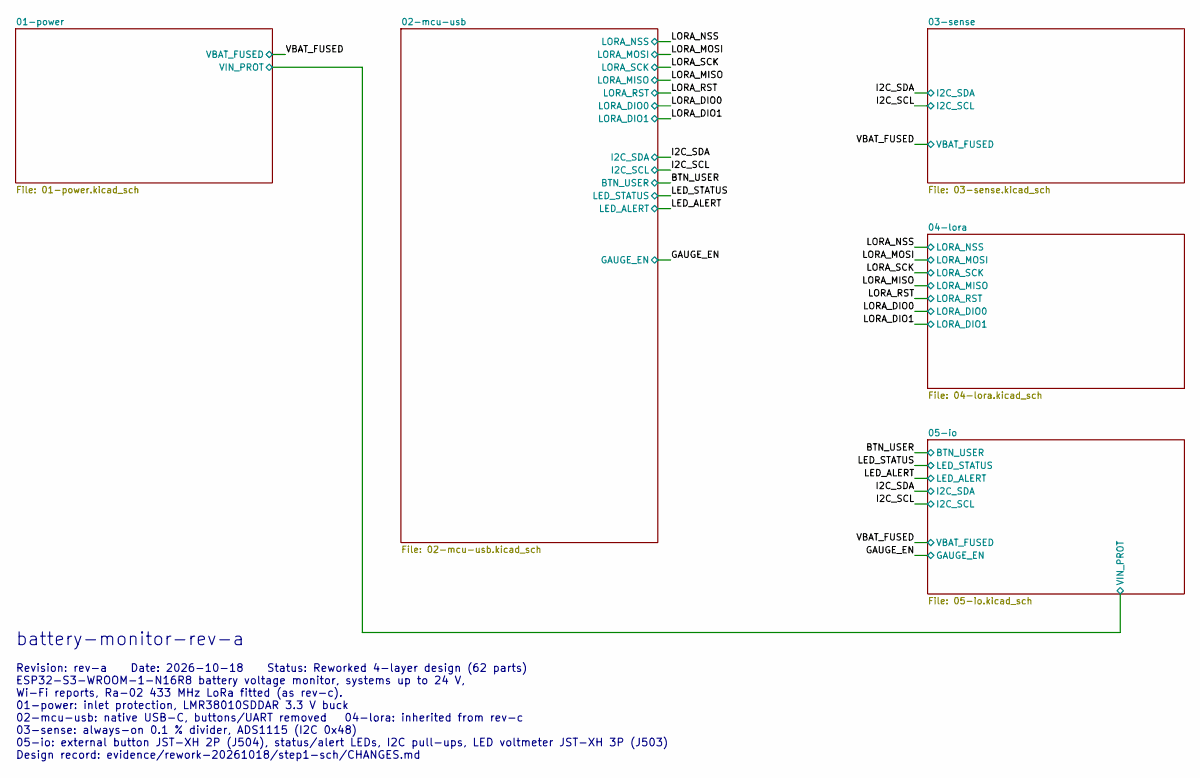
[picture p15: schematic battery-monitor-rev-a.kicad_sch]

Notes on the sheet:
battery-monitor-rev-a
Revision: rev-a Date: 2026-10-18 Status: Reworked 4-layer design (62 parts) ESP32-S3-WROOM-1-N16R8 battery voltage monitor, systems up to 24 V, Wi-Fi reports, Ra-02 433 MHz LoRa fitted (as rev-c). 01-power: inlet protection, LMR38010SDDAR 3.3 V buck 02-mcu-usb: native USB-C, buttons/UART removed 04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

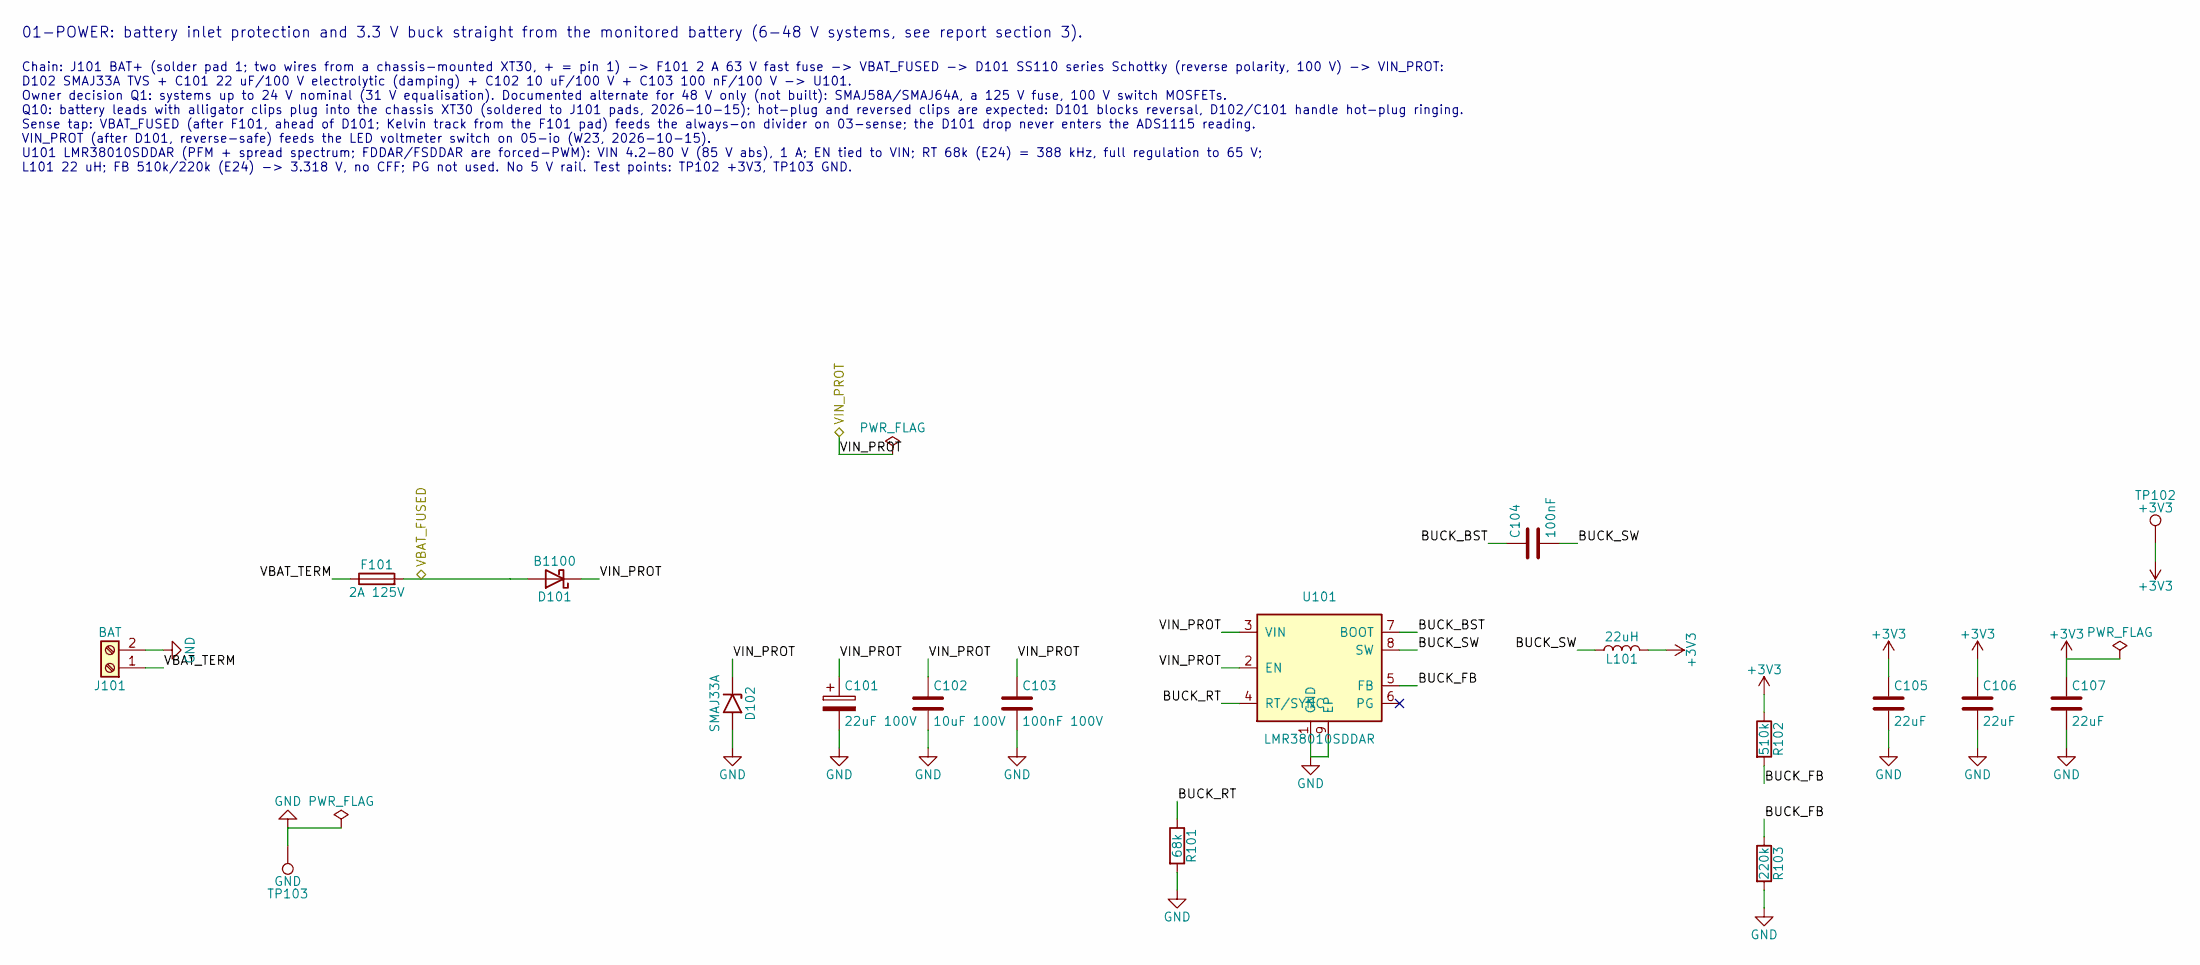
[picture p16: schematic 01-power.kicad_sch]

Parts:
C101: 22uF 100V; CP_Elec_8x10; MPN EEE-FK2A220P
C102: 10uF 100V; C_1210_3225Metric; MPN GRM32EC72A106KE05L
C103: 100nF 100V; C_0603_1608Metric; MPN CL10B104KC8NNNC
C104: 100nF; C_0603_1608Metric; MPN CL10B104KB8NNNC
C105, C106, C107: 22uF; C_0805_2012Metric; MPN GRM21BR61E226ME44L
D101: B1100; D_SMA; MPN B1100-13-F
D102: SMAJ33A; D_SMA; MPN SMAJ33A-TR
F101: 2A 125V; Fuse_Littelfuse-NANO2-451_453; MPN 0451002.MRL
J101: BAT; SolderWire-0.75sqmm_1x02_P4.8mm_D1.25mm_OD2.3mm
L101: 22uH; L_Bourns_SRN6045TA; MPN SRN6045-220M
R101: 68k; R_0603_1608Metric; MPN RC0603FR-0768KL
R102: 510k; R_0603_1608Metric; MPN 0603SAF5103T5E
R103: 220k; R_0603_1608Metric; MPN RC0603FR-07220KL
TP102: +3V3; TestPoint_Pad_D1.5mm
TP103: GND; TestPoint_Pad_D1.5mm
U101: LMR38010SDDAR; TI_SO-PowerPAD-8; MPN LMR38010SDDAR

Connections:
+3V3: C105.1, C106.1, C107.1, L101.2, R102.1, TP102.1; also elsewhere on the board
/01-power/BUCK_BST: C104.1, U101.7 (BOOT)
/01-power/BUCK_FB: R102.2, R103.1, U101.5 (FB)
/01-power/BUCK_RT: R101.1, U101.4 (RT/SYNC)
/01-power/BUCK_SW: C104.2, L101.1, U101.8 (SW)
/01-power/VBAT_TERM: F101.1, J101.1
/01-power/VIN_PROT: C101.1, C102.1, C103.1, D101.1 (K), D102.1 (A1), U101.2 (EN), U101.3 (VIN); also elsewhere on the board
/VBAT_FUSED: D101.2 (A), F101.2; also elsewhere on the board
GND: C101.2, C102.2, C103.2, C105.2, C106.2, C107.2, D102.2 (A2), J101.2, R101.2, R103.2, TP103.1, U101.1 (GND), U101.9 (EP); also elsewhere on the board

Notes on the sheet:
01-POWER: battery inlet protection and 3.3 V buck straight from the monitored battery (6-48 V systems, see report section 3).
Chain: J101 BAT+ (solder pad 1; two wires from a chassis-mounted XT30, + = pin 1) -> F101 2 A 63 V fast fuse -> VBAT_FUSED -> D101 SS110 series Schottky (reverse polarity, 100 V) -> VIN_PROT: D102 SMAJ33A TVS + C101 22 uF/100 V electrolytic (damping) + C102 10 uF/100 V + C103 100 nF/100 V -> U101. 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

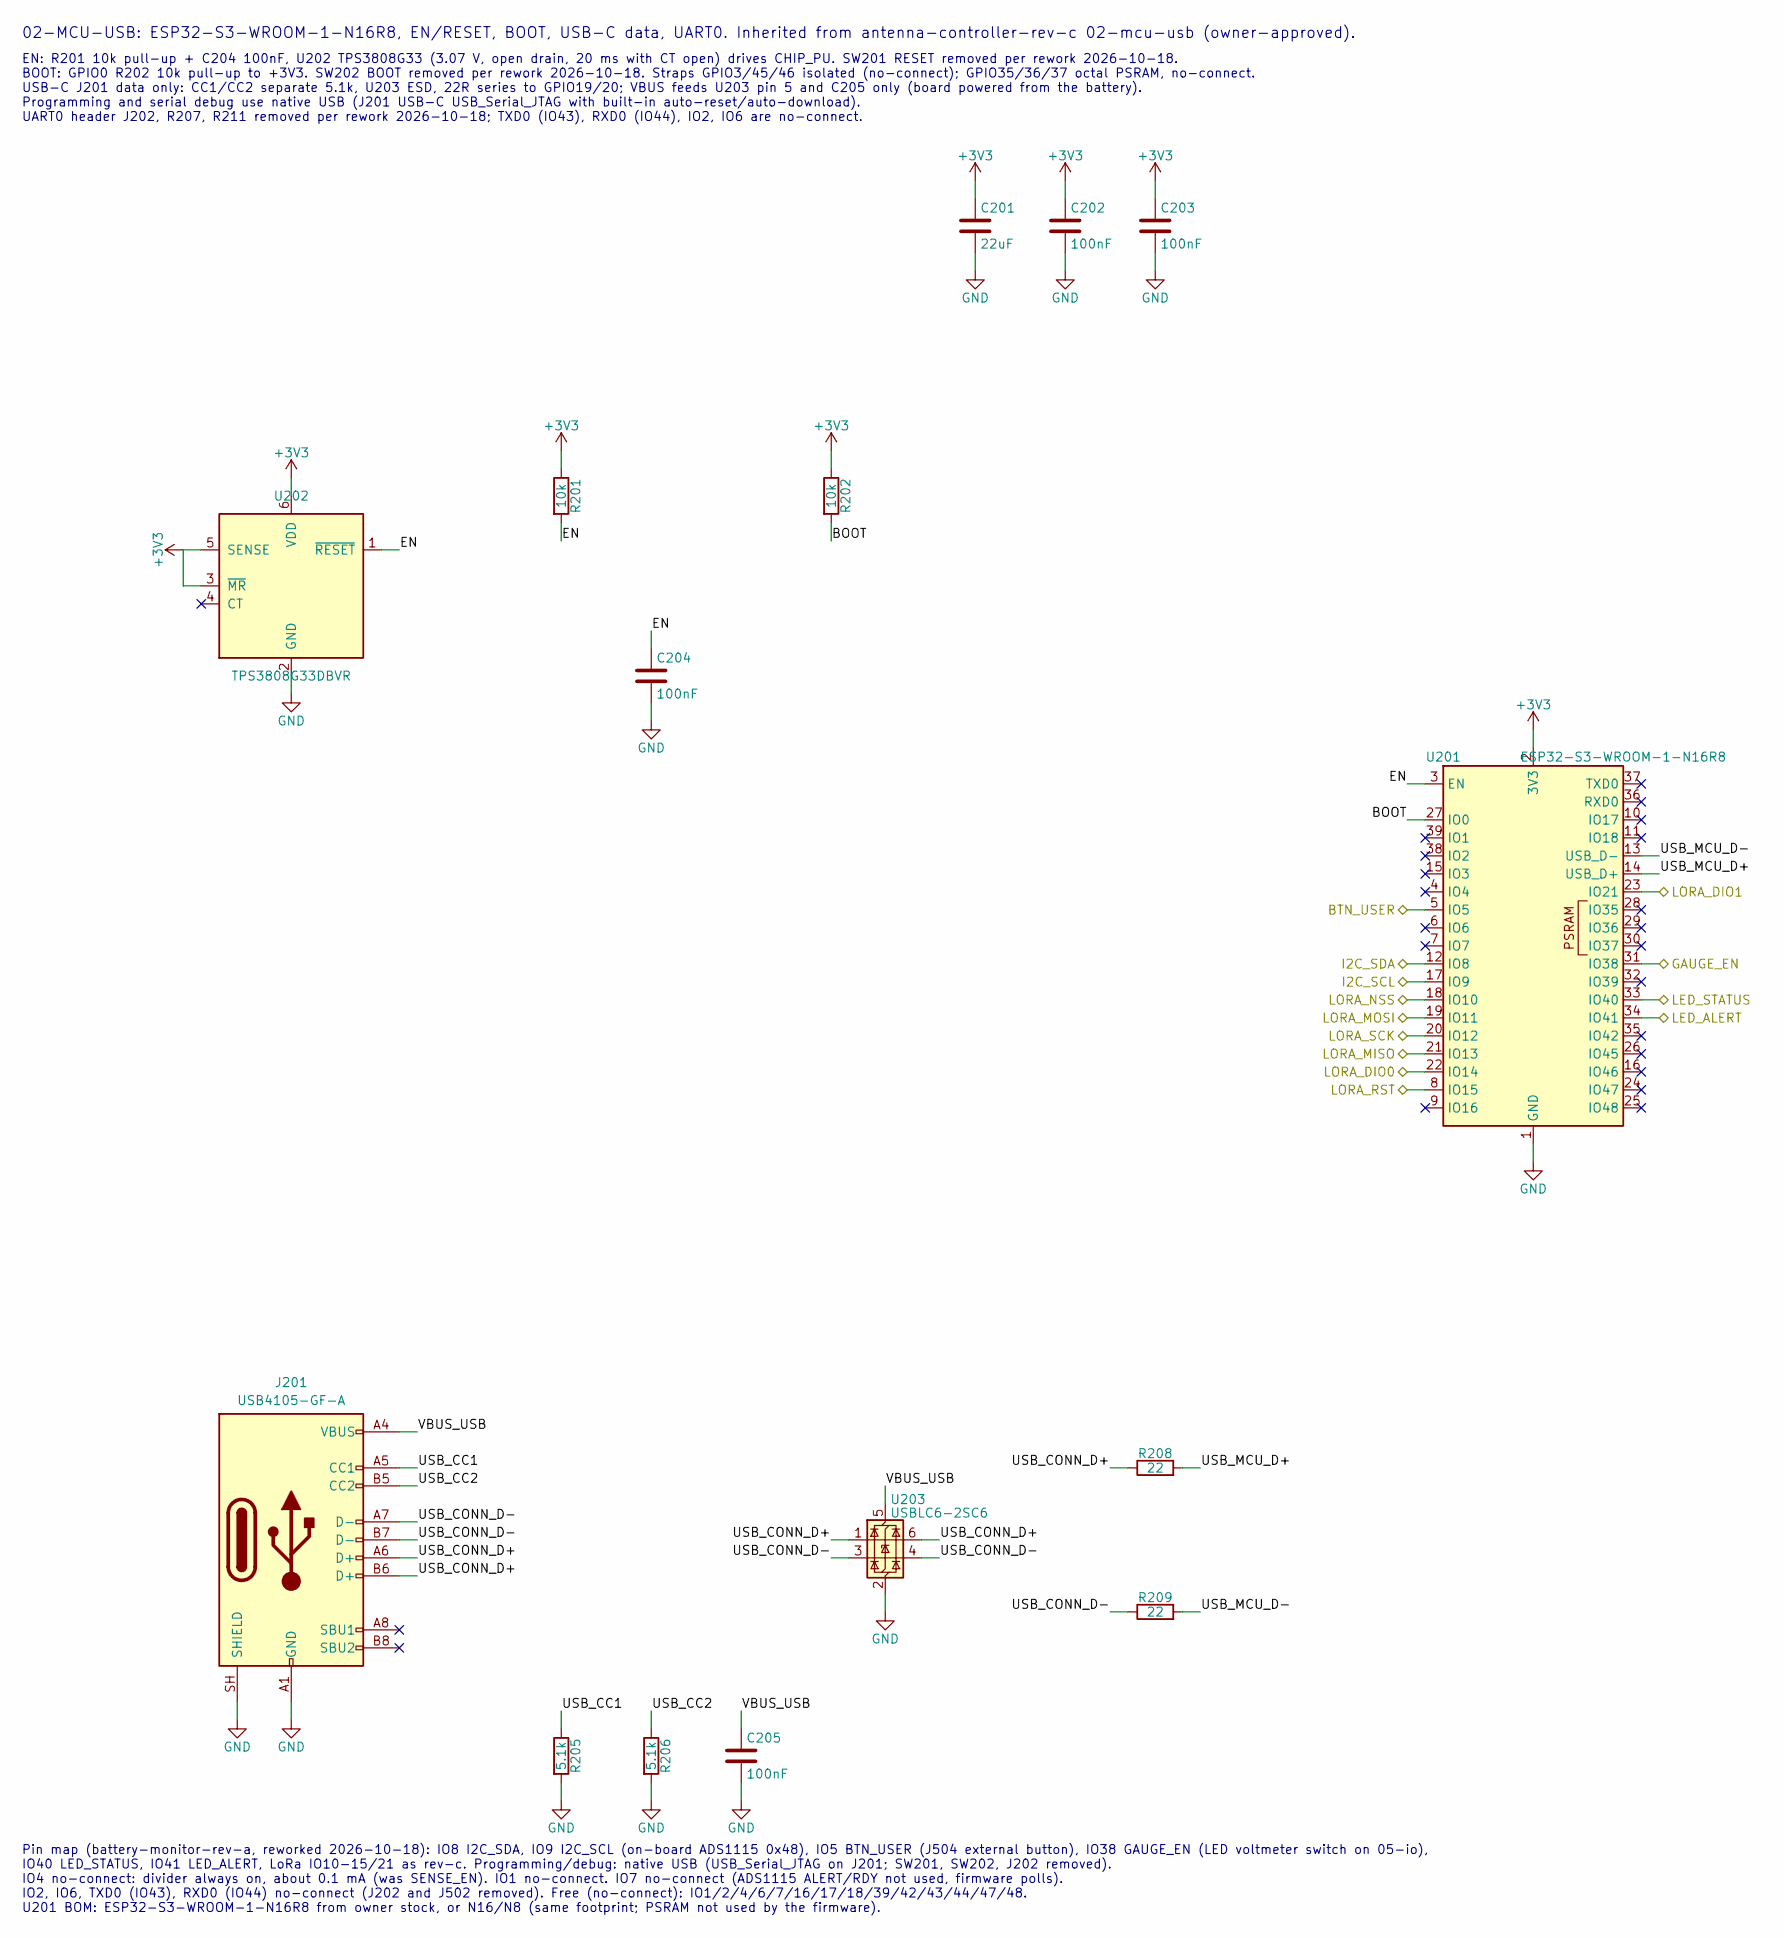
[picture p17: schematic 02-mcu-usb.kicad_sch]

Parts:
C201: 22uF; C_0805_2012Metric; MPN GRM21BR61E226ME44L
C202, C203, C204, C205: 100nF; C_0603_1608Metric; MPN CL10B104KB8NNNC
J201: USB4105-GF-A; USB_C_Receptacle_HRO_TYPE-C-31-M-12; MPN USB4105-GF-A
R201, R202: 10k; R_0603_1608Metric; MPN 0603SAF1002T5E
R205, R206: 5.1k; R_0603_1608Metric; MPN RC0603FR-075K1L
R208, R209: 22; R_0603_1608Metric; MPN RC0603FR-0722RL
U201: ESP32-S3-WROOM-1-N16R8; ESP32-S3-WROOM-1; MPN ESP32-S3-WROOM-1-N16R8 (or -N16 / -N8, 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
U202: TPS3808G33DBVR; SOT-23-6; MPN TPS3808G33DBVR
U203: USBLC6-2SC6; SOT-23-6; MPN USBLC6-2SC6

Connections:
+3V3: C201.1, C202.1, C203.1, R201.1, R202.1, U201.2 (3V3), U202.3 (~MR), U202.5 (SENSE), U202.6 (VDD); also elsewhere on the board
/02-mcu-usb/BOOT: R202.2, U201.27 (IO0)
/02-mcu-usb/EN: C204.1, R201.2, U201.3 (EN), U202.1 (~RESET)
/02-mcu-usb/USB_CC1: J201.A5 (CC1), R205.1
/02-mcu-usb/USB_CC2: J201.B5 (CC2), R206.1
/02-mcu-usb/USB_CONN_D+: J201.A6 (D+), J201.B6 (D+), R208.1, U203.1 (I/O1), U203.6 (I/O1)
/02-mcu-usb/USB_CONN_D-: J201.A7 (D-), J201.B7 (D-), R209.1, U203.3 (I/O2), U203.4 (I/O2)
/02-mcu-usb/USB_MCU_D+: R208.2, U201.14 (USB_D+)
/02-mcu-usb/USB_MCU_D-: R209.2, U201.13 (USB_D-)
/02-mcu-usb/VBUS_USB: C205.1, J201.A4 (VBUS), J201.A9 (VBUS), J201.B4 (VBUS), J201.B9 (VBUS), U203.5 (VBUS)
/BTN_USER: U201.5 (IO5); also elsewhere on the board
/GAUGE_EN: U201.31 (IO38); also elsewhere on the board
/I2C_SCL: U201.17 (IO9); also elsewhere on the board
/I2C_SDA: U201.12 (IO8); also elsewhere on the board
/LED_ALERT: U201.34 (IO41); also elsewhere on the board
/LED_STATUS: U201.33 (IO40); also elsewhere on the board
/LORA_DIO0: U201.22 (IO14); also elsewhere on the board
/LORA_DIO1: U201.23 (IO21); also elsewhere on the board
/LORA_MISO: U201.21 (IO13); also elsewhere on the board
/LORA_MOSI: U201.19 (IO11); also elsewhere on the board
/LORA_NSS: U201.18 (IO10); also elsewhere on the board
/LORA_RST: U201.8 (IO15); also elsewhere on the board
/LORA_SCK: U201.20 (IO12); also elsewhere on the board
GND: C201.2, C202.2, C203.2, C204.2, C205.2, J201.A1 (GND), J201.A12 (GND), J201.B1 (GND), J201.B12 (GND), J201.SH (SHIELD), R205.2, R206.2, U201.1 (GND), U201.40 (GND), U201.41 (GND), U202.2 (GND), U203.2 (GND); also elsewhere on the board

Notes on the sheet:
02-MCU-USB: ESP32-S3-WROOM-1-N16R8, EN/RESET, BOOT, USB-C data, UART0. Inherited from antenna-controller-rev-c 02-mcu-usb (owner-approved).
EN: R201 10k pull-up + C204 100nF, U202 TPS3808G33 (3.07 V, open drain, 20 ms with CT open) drives CHIP_PU. SW201 RESET removed per rework 2026-10-18. BOOT: GPIO0 R202 10k pull-up to +3V3. SW202 BOOT removed per rework 2026-10-18. Straps GPIO3/45/46 isolated (no-connect); GPIO35/36/37 octal PSRAM, 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
Pin map (battery-monitor-rev-a, reworked 2026-10-18): IO8 I2C_SDA, IO9 I2C_SCL (on-board ADS1115 0x48), IO5 BTN_USER (J504 external button), IO38 GAUGE_EN (LED voltmeter switch on 05-io), IO40 LED_STATUS, IO41 LED_ALERT, LoRa IO10-15/21 as rev-c. Programming/debug: native USB (USB_Serial_JTAG on J2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

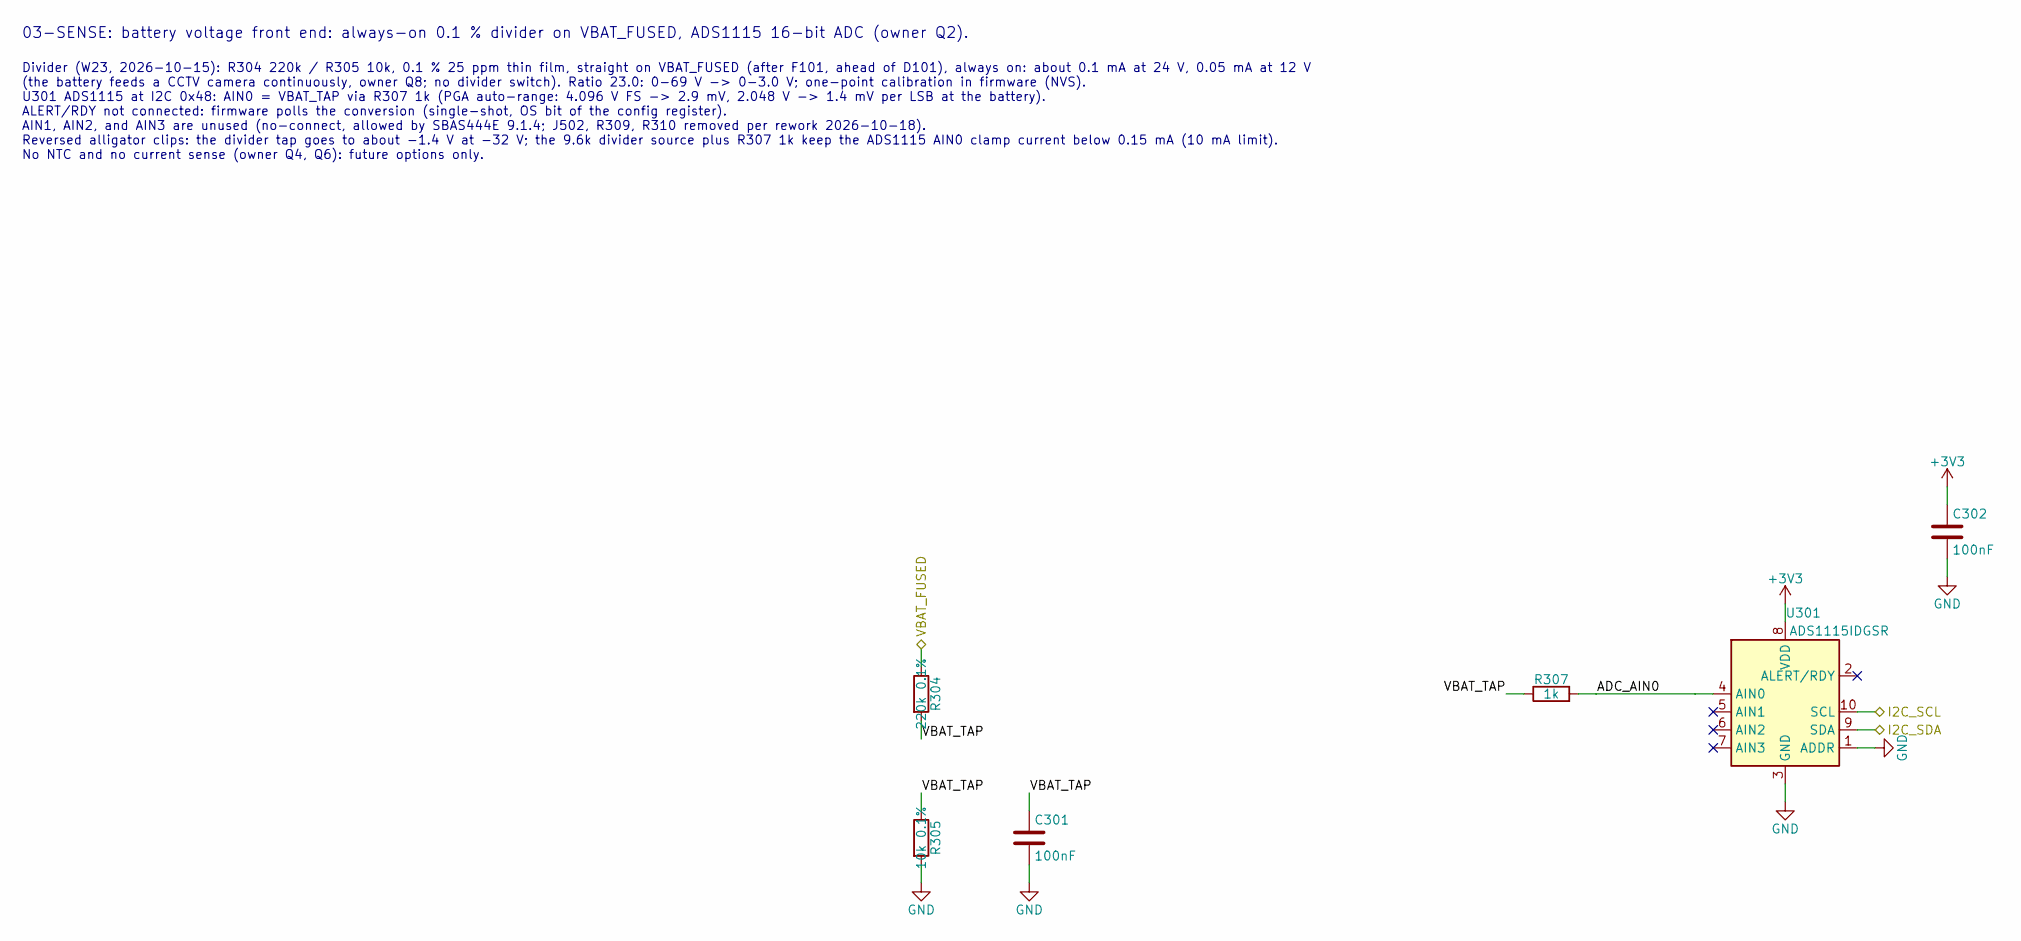
[picture p18: schematic 03-sense.kicad_sch]

Parts:
C301, C302: 100nF; C_0603_1608Metric; MPN CL10B104KB8NNNC
R304: 220k 0.1%; R_0805_2012Metric; MPN ERA-6AEB224V
R305: 10k 0.1%; R_0603_1608Metric; MPN RT0603BRD0710KL
R307: 1k; R_0603_1608Metric; MPN RC0603FR-071KL
U301: ADS1115IDGSR; TSSOP-10_3x3mm_P0.5mm; MPN ADS1115IDGSR

Connections:
+3V3: C302.1, U301.8 (VDD); also elsewhere on the board
/03-sense/ADC_AIN0: R307.2, U301.4 (AIN0)
/03-sense/VBAT_TAP: C301.1, R304.2, R305.1, R307.1
/I2C_SCL: U301.10 (SCL); also elsewhere on the board
/I2C_SDA: U301.9 (SDA); also elsewhere on the board
/VBAT_FUSED: R304.1; also elsewhere on the board
GND: C301.2, C302.2, R305.2, U301.1 (ADDR), U301.3 (GND); also elsewhere on the board

Notes on the sheet:
03-SENSE: battery voltage front end: always-on 0.1 % divider on VBAT_FUSED, ADS1115 16-bit ADC (owner Q2).
Divider (W23, 2026-10-15): R304 220k / R305 10k, 0.1 % 25 ppm thin film, straight on VBAT_FUSED (after F101, ahead of D101), always on: about 0.1 mA at 24 V, 0.05 mA at 12 V (the battery feeds a CCTV camera continuously, owner Q8; no divider switch). Ratio 23.0: 0-69 V -> 0-3.0 V; one-point calibra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

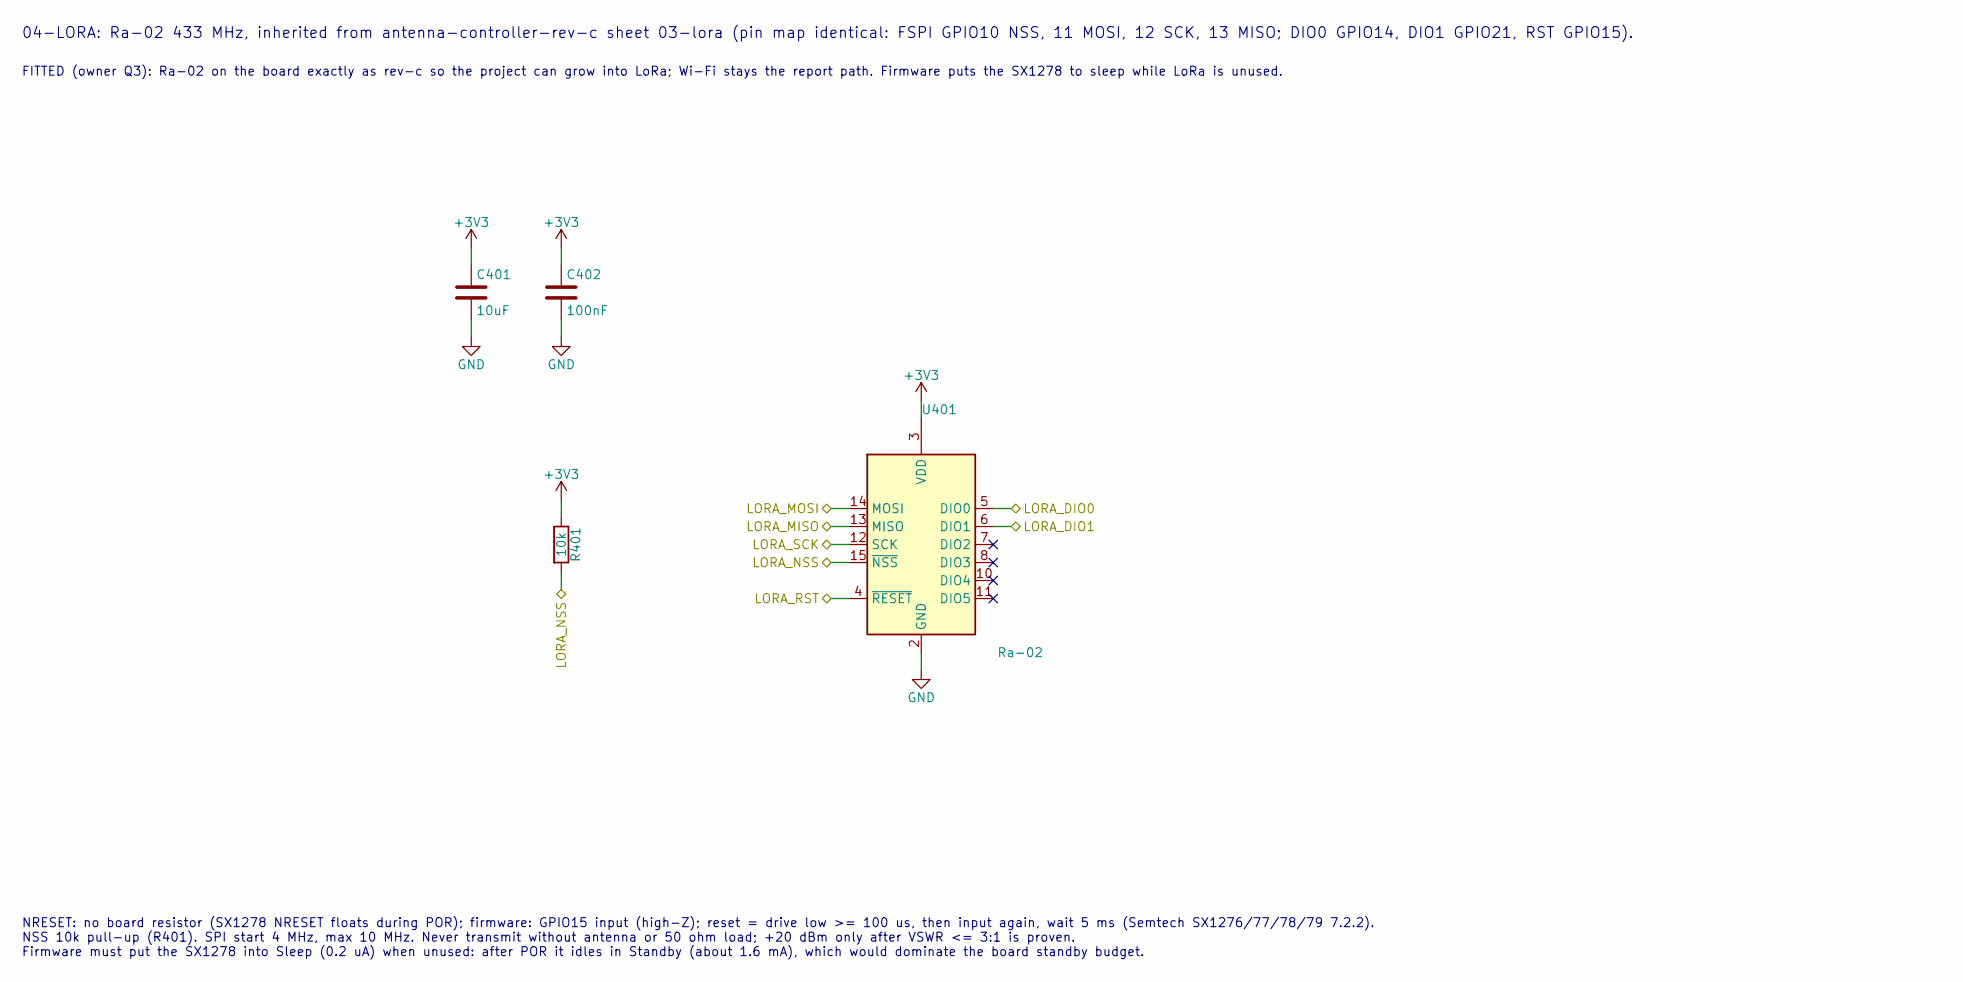
[picture p19: schematic 04-lora.kicad_sch]

Parts:
C401: 10uF; C_0805_2012Metric; MPN CL21A106KAYNNNE
C402: 100nF; C_0603_1608Metric; MPN CL10B104KB8NNNC
R401: 10k; R_0603_1608Metric; MPN 0603SAF1002T5E
U401: Ra-02; Ra02_Source; MPN Ra-02

Connections:
+3V3: C401.1, C402.1, R401.1, U401.3 (VDD); also elsewhere on the board
/LORA_DIO0: U401.5 (DIO0); also elsewhere on the board
/LORA_DIO1: U401.6 (DIO1); also elsewhere on the board
/LORA_MISO: U401.13 (MISO); also elsewhere on the board
/LORA_MOSI: U401.14 (MOSI); also elsewhere on the board
/LORA_NSS: R401.2, U401.15 (~NSS); also elsewhere on the board
/LORA_RST: U401.4 (~RESET); also elsewhere on the board
/LORA_SCK: U401.12 (SCK); also elsewhere on the board
GND: C401.2, C402.2, U401.1 (GND), U401.2 (GND), U401.9 (GND), U401.16 (GND); also elsewhere on the board

Notes on the sheet:
04-LORA: Ra-02 433 MHz, inherited from antenna-controller-rev-c sheet 03-lora (pin map identical: FSPI GPIO10 NSS, 11 MOSI, 12 SCK, 13 MISO; DIO0 GPIO14, DIO1 GPIO21, RST GPIO15).
FITTED (owner Q3): Ra-02 on the board exactly as rev-c so the project can grow into LoRa; Wi-Fi stays the report path. Firmware puts the SX1278 to sleep while LoRa is unused.
NRESET: no board resistor (SX1278 NRESET floats during POR); firmware: GPIO15 input (high-Z); reset = drive low >= 100 us, then input again, wait 5 ms (Semtech SX1276/77/78/79 7.2.2). NSS 10k pull-up (R401). SPI start 4 MHz, max 10 MHz. Never transmit without antenna or 50 ohm load; +20 dBm only af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

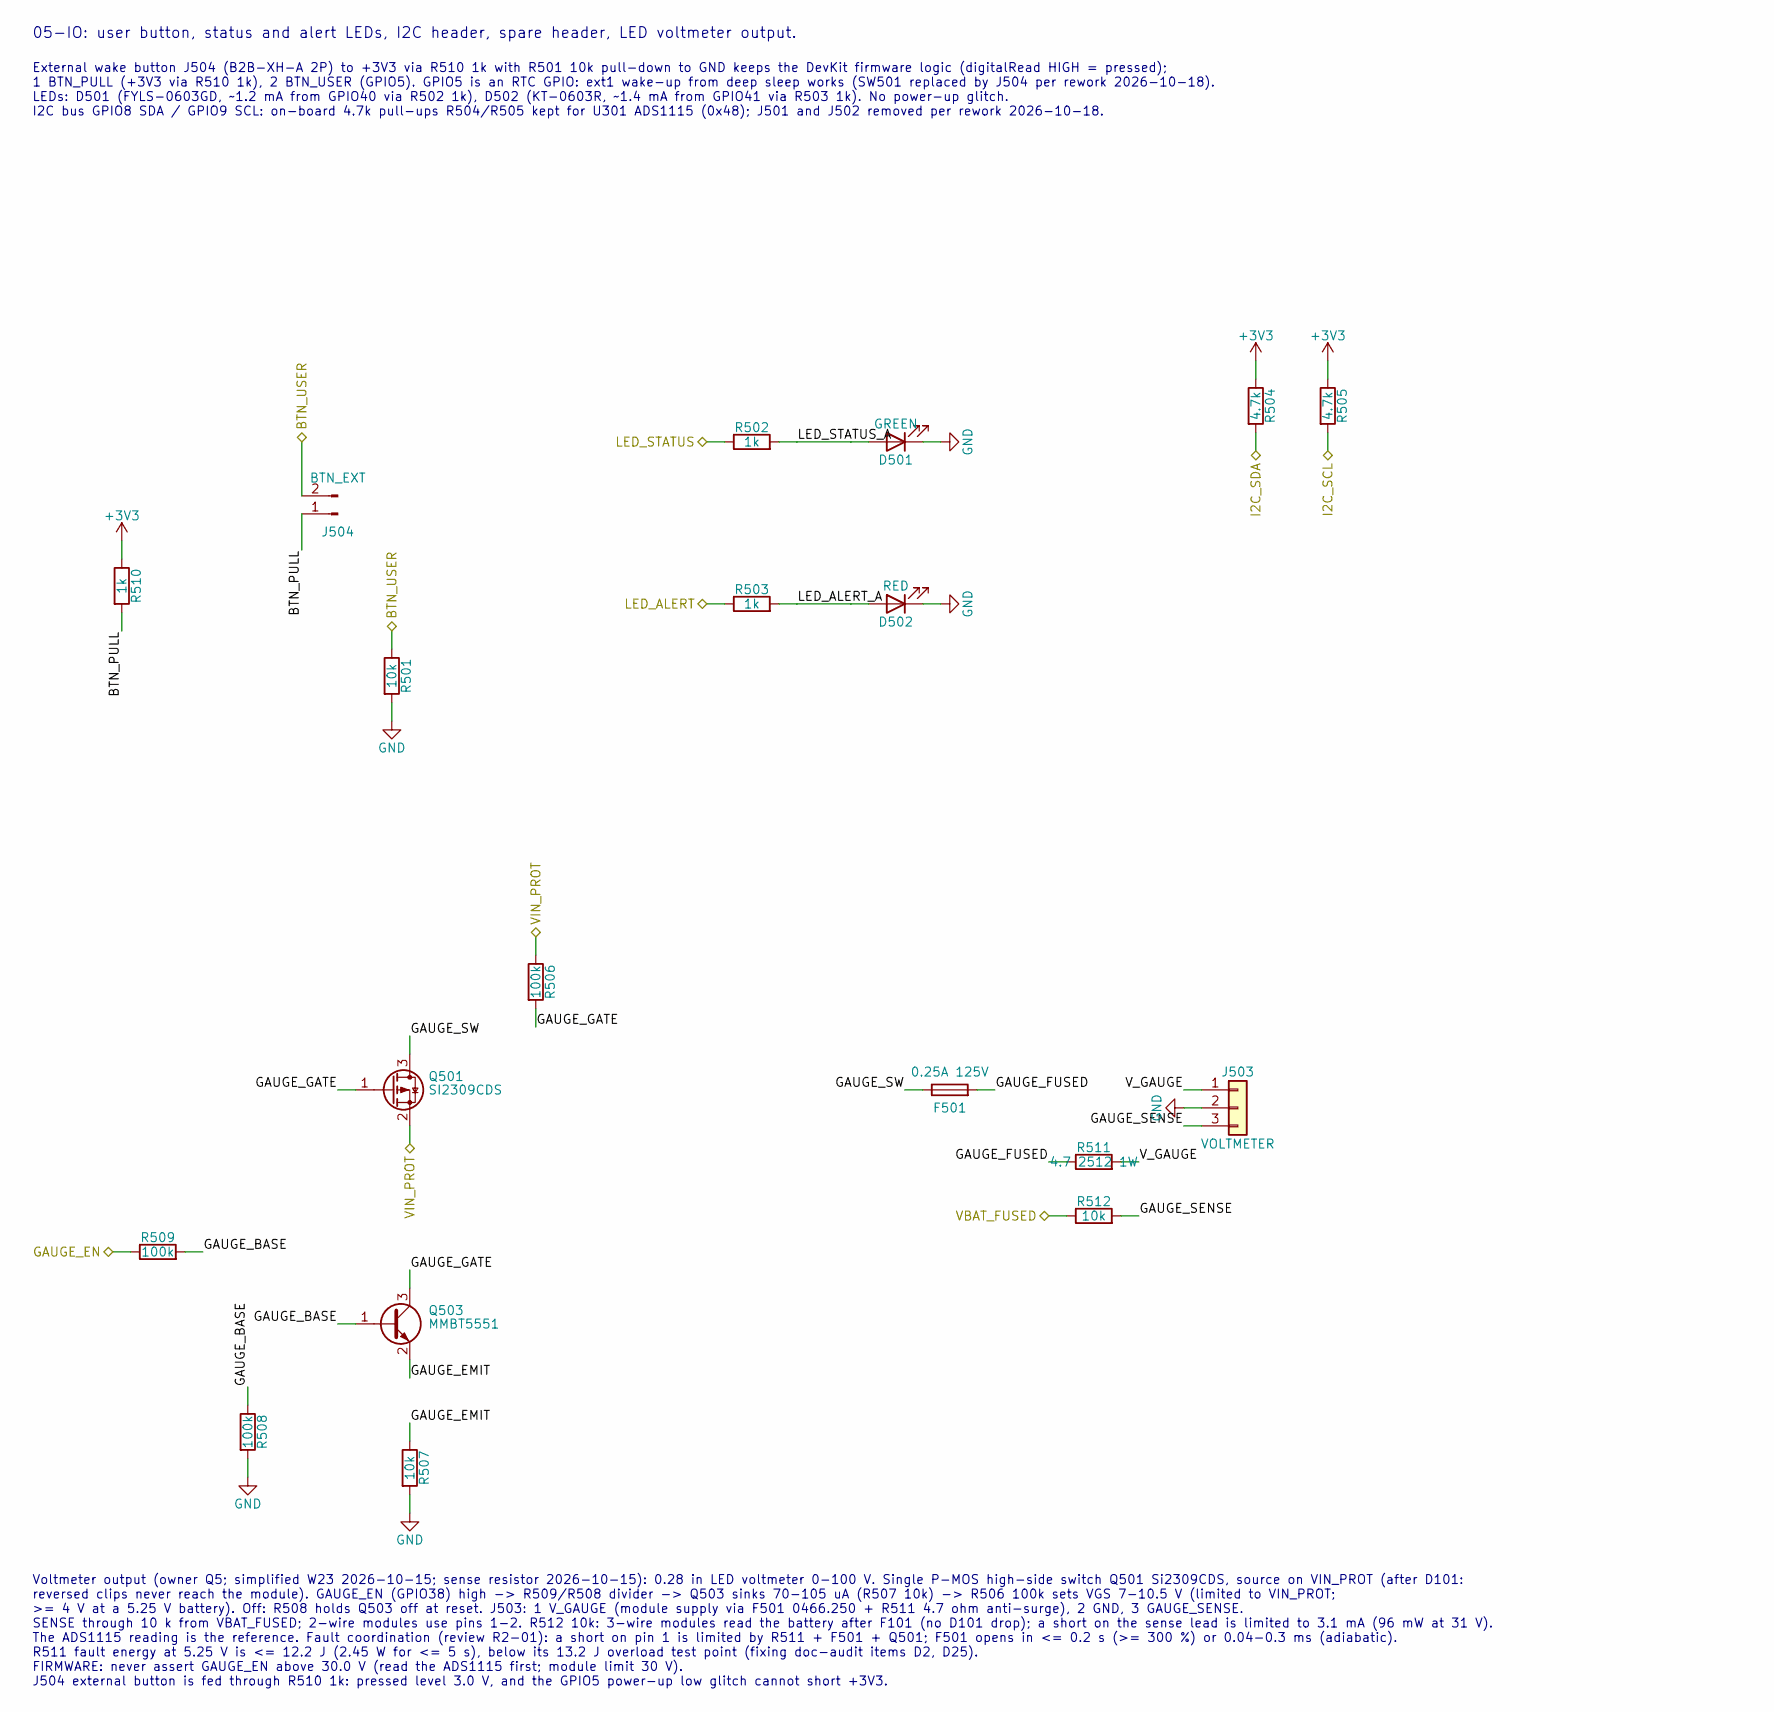
[picture p20: schematic 05-io.kicad_sch]

Parts:
D501: GREEN; LED_0603_1608Metric; MPN LTST-C191KGKT
D502: RED; LED_0603_1608Metric; MPN KP-1608SURCK
F501: 0.25A 125V; Fuse_1206_3216Metric; MPN 0466.250NRHF
J503: VOLTMETER; JST_XH_B3B-XH-A_1x03_P2.50mm_Vertical; MPN B3B-XH-A(LF)(SN)
J504: BTN_EXT; JST_XH_B2B-XH-A_1x02_P2.50mm_Vertical; MPN B2B-XH-A(LF)(SN)
Q501: SI2309CDS; SOT-23; MPN SI2309CDS-T1-GE3
Q503: MMBT5551; SOT-23; MPN MMBT5551LT1G
R501, R507: 10k; R_0603_1608Metric; MPN 0603SAF1002T5E
R502, R503, R510: 1k; R_0603_1608Metric; MPN RC0603FR-071KL
R504, R505: 4.7k; R_0603_1608Metric; MPN 0603SAF4701T5E
R506, R508, R509: 100k; R_0603_1608Metric; MPN AC0603FR-07100KL
R511: 4.7 2512 1W; R_2512_6332Metric; MPN RC2512JK-074R7L
R512: 10k; R_1206_3216Metric; MPN 1206S4F1002T5E

Connections:
+3V3: R504.1, R505.1, R510.1; also elsewhere on the board
/01-power/VIN_PROT: Q501.2 (S), R506.1; also elsewhere on the board
/05-io/BTN_PULL: J504.1, R510.2
/05-io/GAUGE_BASE: Q503.1 (B), R508.1, R509.2
/05-io/GAUGE_EMIT: Q503.2 (E), R507.1
/05-io/GAUGE_FUSED: F501.2, R511.1
/05-io/GAUGE_GATE: Q501.1 (G), Q503.3 (C), R506.2
/05-io/GAUGE_SENSE: J503.3, R512.2
/05-io/GAUGE_SW: F501.1, Q501.3 (D)
/05-io/LED_ALERT_A: D502.2 (A), R503.2
/05-io/LED_STATUS_A: D501.2 (A), R502.2
/05-io/V_GAUGE: J503.1, R511.2
/BTN_USER: J504.2, R501.1; also elsewhere on the board
/GAUGE_EN: R509.1; also elsewhere on the board
/I2C_SCL: R505.2; also elsewhere on the board
/I2C_SDA: R504.2; also elsewhere on the board
/LED_ALERT: R503.1; also elsewhere on the board
/LED_STATUS: R502.1; also elsewhere on the board
/VBAT_FUSED: R512.1; also elsewhere on the board
GND: D501.1 (K), D502.1 (K), J503.2, R501.2, R507.2, R508.2; also elsewhere on the board

Notes on the sheet:
05-IO: user button, status and alert LEDs, I2C header, spare header, LED voltmeter output.
External wake button J504 (B2B-XH-A 2P) to +3V3 via R510 1k with R501 10k pull-down to GND keeps the DevKit firmware logic (digitalRead HIGH = pressed); 1 BTN_PULL (+3V3 via R510 1k), 2 BTN_USER (GPIO5). GPIO5 is an RTC GPIO: ext1 wake-up from deep sleep works (SW501 replaced by J504 per rework 202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
Voltmeter output (owner Q5; simplified W23 2026-10-15; sense resistor 2026-10-15): 0.28 in LED voltmeter 0-100 V. Single P-MOS high-side switch Q501 Si2309CDS, source on VIN_PROT (after D101: reversed clips never reach the module). GAUGE_EN (GPIO38) high -> R509/R508 divider -> Q503 sinks 70-105 uA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

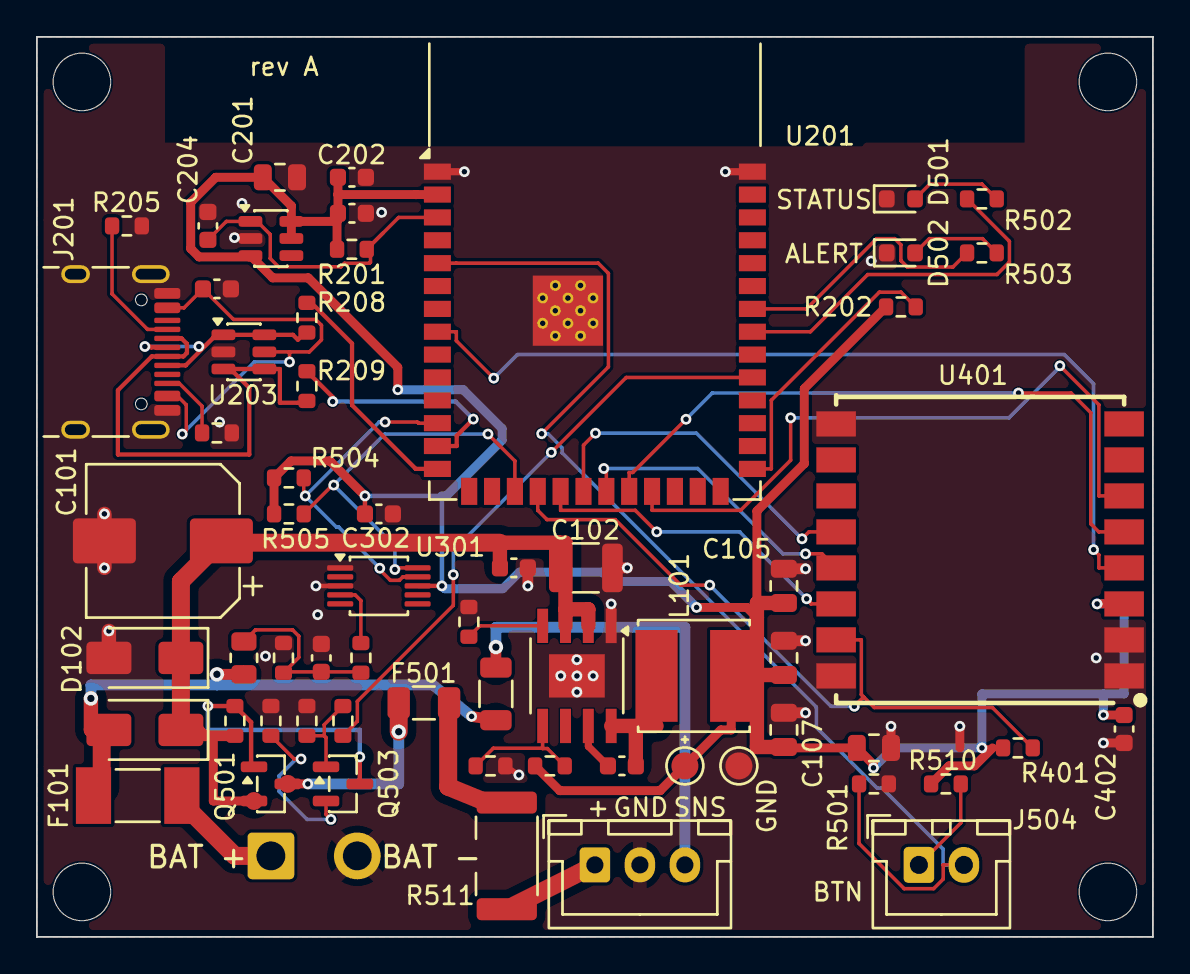
[picture p21: board battery-monitor-rev-a.kicad_pcb from above]

Board: 4 copper layers, 62.0 x 50.0 mm, 66 parts (0 on the bottom side), 43 nets.

Other parts of the board:
H1, H2, H3, H4: M3; MountingHole_3.2mm_M3
