bogdan-kovalchuk/esp32-battery-charging-monitoring/(commit log)

2025-02-24 change voltage pin
2025-02-24 changed approach to voltage calculation
2025-02-26 only send critical messages if voltage is below critical
2025-02-28 added conversion to milliseconds
2025-02-28 adding config reset and some minore changes
    [main.cpp]
2025-03-02 changing voltmeter on time
2025-03-02 minor changes to voltmeter on
2025-03-03 round battery voltage
2025-03-04 not sending message when voltage is equal zero
2025-03-05 not send messages with zero voltage
2026-07-31 rework ESP32 monitoring firmware
    [app_config.h, backend_client.cpp, ci_secrets.h, config_portal.cpp, device_config.cpp, device_config.h]
2026-10-18 add battery monitor rev-a KiCad design
2026-10-22 add battery monitor rev-a production package
2026-10-25 document rev-a PCB in README
